ZeroGDesign/docs/pages/bom/instructions/merc/Hardware.md

---
layout: default
title: Installation Hardware
nav_order: 1
has_children: false
has_toc: false
parent: How To Build
permalink: /instructions/how/hardware
---

# Installation Hardware

| Image | Tool |
| :---: | --- |
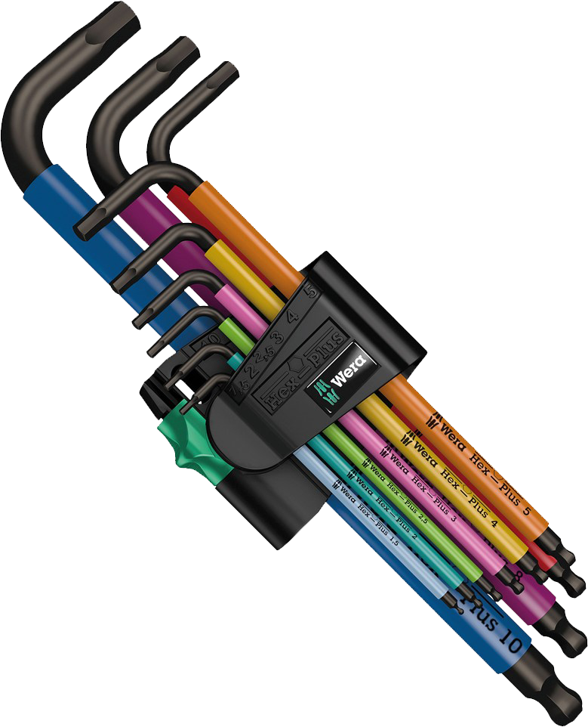
[picture p1: assets/img/hardware/hexkeys.png]
Wera Hex Keys
|  | Hex Key set.<br/>Used to tighten or loosen screws.|
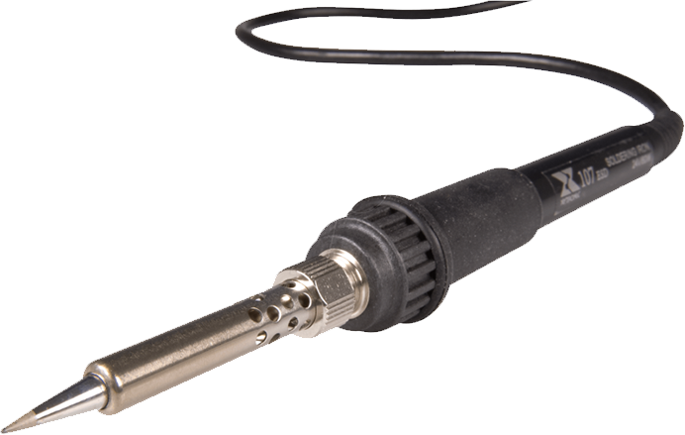
[picture p2: assets/img/hardware/solderiron.png]
Generic Soldering Iron
|  | Generic Soldering iron.<br/>Heat insert tip recommended.<br />Used to melt in brass heat inserts.|
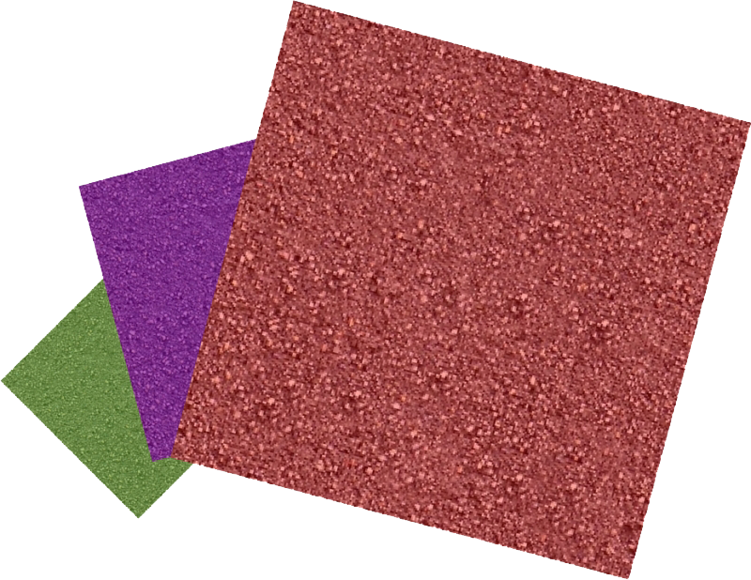
[picture p3: assets/img/hardware/sandpaper.png]
Sander paper
|  | Sand paper.<br/>Sometimes dowel pins are too tight, used to grind them down a little.|
