ZeroGDesign/docs/index.md

---

title: Welcome
nav_order: 1
---

# Welcome to the ZeroG docs!

Our first attempt at documentation! Found any errors in this document? Please report it on our [Discord server](https://discord.com/invite/gzJP2s8).

This contains all the information you need to build your personal ZeroG printer.

If you're not an expert with cad we'd suggest you to read our Documentation carefully. Do you have any questions? Hit up our [Discord](https://discord.com/invite/gzJP2s8){:target="_blank"}!

## Screenshot
The image bellow contains the Mercury One.1 ([Eva](https://main.eva-3d.page/){:target="_blank"} compatible).

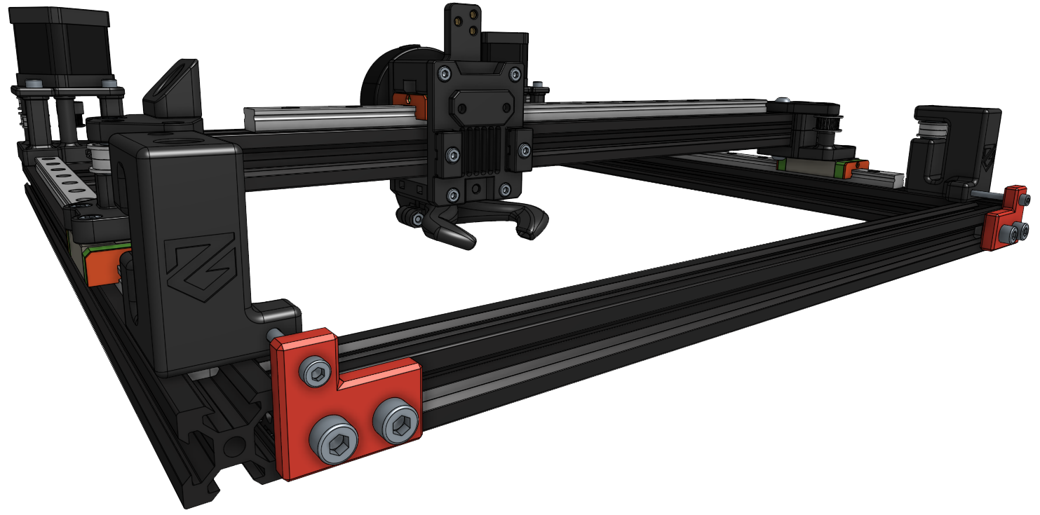
[picture p4: assets/img/printer/birdview.png]
Birdseye overview
