ZeroGDesign/docs/docs/index.md

---

title: Welcome
nav_order: 1
---

# Welcome
{: .fs-9 }
The Zero G documentation will give you a start building your project, learning all about 3D printing and more!
{: .fs-6 .fw-300 }

## Getting started
On this website you'll find all sorts of information, [ABS Printing Tips](/manual/print/abs), [Print Settings](/standard/print/settings), [Design Guidelines](/standard/cad/guidelines), [Mainsail Theme](/klipper/mainsail/theme), [Manuals](/manual/build) and more!

Currently we're working on instructions for two of our projects. Our projects are **Mercury One.1** and **Hydra**.

*The documentation is still a work in progress so keep in mind it's not complete.*

[Mercury One.1](/manual/build/mercury_eva){: .btn .btn-red } [Hydra](/manual/build/hydra){: .btn }

### Discord

We're a big [<i class="bi bi-discord"></i> Discord](https://discord.gg/zerog) advocate! We love using it and building a community. Missing something in the documentation, need assistance, share your adventure, or enjoy a nice community? Join our [<i class="bi bi-discord"></i> Discord](https://discord.gg/zerog) today!

## Step files!

The step files for Hydra and Mercury One.1 are now available.

Find them in the menu: Manual → [Mercury One.1](/manual/build/mercury_eva/printed_files) **OR** [Hydra](/manual/build/hydra/printed_files) → 3. Files. There is a section called "Step files".

### License

We're not using a GPL3 license like most other open source projects. 
Our work is licensed under a [Creative Commons Attribution-NonCommercial-ShareAlike 4.0 International License](http://creativecommons.org/licenses/by-nc-sa/4.0/)

**What does this mean and why did you choose for this instead of GPL3?**

1. What does this mean?
   1. Read more about the license here **[here](http://creativecommons.org/licenses/by-nc-sa/4.0/)**.
2. Why did you choose this license?
   1. I want to protect our project from others taking advantage of our files and community members.
   2. The license still allows you to do the following:
      1. **Share** — copy and redistribute the material in any medium or format
      2. **Adapt** — remix, transform, and build upon the material
   3. Yes, **Share and Adapt** come with **terms** and you can read those **[here](http://creativecommons.org/licenses/by-nc-sa/4.0/)**.
