ZeroGDesign/docs/docs/pages/menu/menu_universal.md

---
layout: default
title: Universal
nav_order: 45
has_toc: true
has_children: true
permalink: /universal
---

# Universal
{: .no_toc }

## WHAT IS UNIVERSAL ABOUT THIS PAGE
{: .no_toc }

This page is a versatile space designed to address a wide range of needs beyond our own project, ZeroG. Whether you're a seasoned 3D printing enthusiast or a newcomer wanting to enhance your printing experience, this page is a helpfull tool. Presenting a range of small tools to simplify your setup and troubleshooting processes.
