ZeroGDesign/docs/docs/pages/menu/menu_klipper.md

---
layout: default
title: Klipper
nav_order: 40
has_toc: true
has_children: true
permalink: /klipper
---

# Klipper
