ZeroGDesign/docs/docs/pages/manual/build/Electronics_enclosure/introduction.md

---
layout: default
title: 1. Introduction
nav_order: 0
has_toc: false
parent: Electronics Enclosure
grand_parent: Manual
permalink: /manual/build/electronics_enclosure/introduction
---

# 1. Introduction
{: .no_toc }

Building the Electronics enclosure
{: .fs-6 .fw-300 }

<dl>
  <dt>Difficulty</dt>
  <dd><span style="color:#FF3001">Advanced</span></dd>
  <dt>Language</dt>
  <dd>English</dd>
</dl>

## Higher resolution image

Hovering an image with your mouse will show a zoom icon <i class="bi bi-zoom-in"></i> after opening the image you can either click 'CLOSE' or anywhere on the screen to close the pop-up.

## Tools required

| :-------------------------: | :--------------------       | -------------------------------------------------------------------------------: |
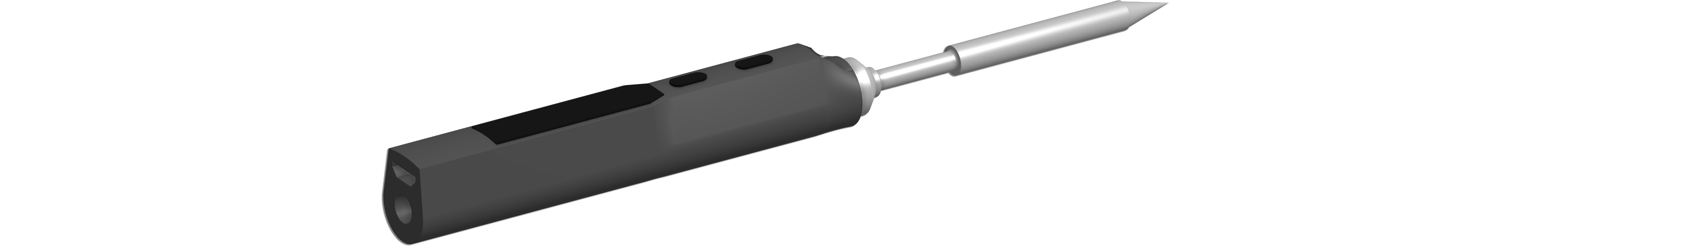
[picture p5: docs/assets/images/tools/soldering_iron.png]
soldering iron
| Tool<br/>Description| Soldering iron<br/>Used for heat set inserts |     {: .lightbox_wrapper} |
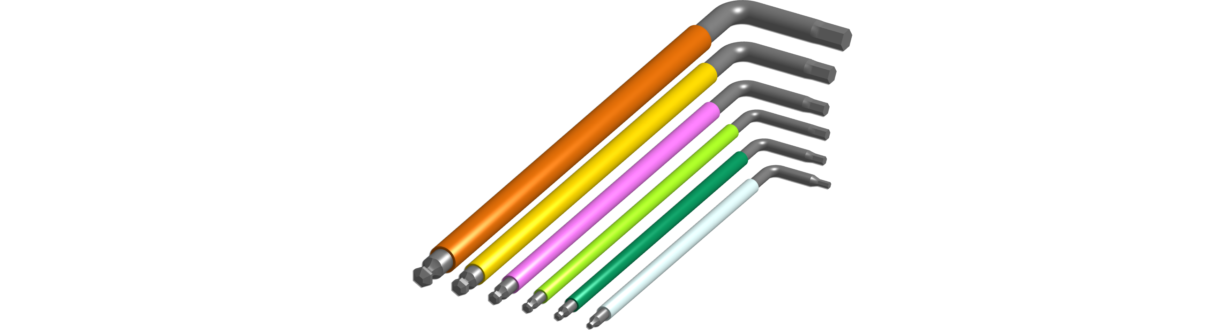
[picture p6: docs/assets/images/tools/wera_hexkeys.png]
| Tool<br/>Description<br/>Sizes| Hex Keys<br/>Used to tighten and losen bolts<br/>2mm, 2.5mm, 3mm|     {: .lightbox_wrapper} |
{: class="hardwaretable"}

<div onclick="location.href='##';"  id="lightbox__item_1"  class="lightbox__item">
    <div class="lightbox__content">

        Soldering iron
    </div>
</div>

<div onclick="location.href='##';"  id="lightbox__item_2"  class="lightbox__item">
    <div class="lightbox__content">

        Hex keys
    </div>
</div>

## Do's and don'ts

1. **Read and execute the instructions.**
2. **Got questions?**
   1. Join our [Discord server <i class="bi bi-discord"></i>](https://discord.gg/zerog){:target="_blank"}.
3. **Don't just look at images.**
   1. An image doesn't explain the full story.
   2. There is text that will explain every step, read it carefully.
4. **Don't skip instructions.**
   1. Unless we tell you to.
5. **Don't use force, you shouldn't have too.**
   1. Make sure to not use a unreasonable amount of force.
   2. Plastic does break and flange bearings crack, would be a waste wouldn't it?

## Need more help?

Lost? Need help? Not sure? Join our [Discord server <i class="bi bi-discord"></i>](https://discord.gg/zerog){:target="_blank"}, we've got a big community ready to help you out!

{: style="text-align: center" .fs-8}
[Next step &rarr;](#){: .btn .btn-red }
