ZeroGDesign/docs/docs/assets/stl/eva2_4/optional_ducts/info.pdf

# FAN DUCT NAMES

WHAT ARE THOSE!?

EVA2_4_TRIHORN_2-6-NARROW.STL / EVA2_4_TRIHORN_2-6-WIDE.STL

The name contains 2-6, this means the lowest part of the Trihorn duct is 2.6mm above the bottom of your nozzle.

Narrow means the width in-between exhaust holes is 24mm
Wide means the width in-between exhaust holes is 31mm.

EVA2_4_TRIHORN_3-4-NARROW.STL / EVA2_4_TRIHORN_3-4-WIDE.STL

Lowest part of the Trihorn duct is 3.4mm above the bottom of your nozzle.

EVA2_4_TRIHORN_4-3-NARROW.STL / EVA2_4_TRIHORN_4-3-WIDE.STL

Lowest part of the Trihorn duct is 4.3mm above the bottom of your nozzle.
