ZeroGDesign/docs/docs/assets/stl/m1_1/customExtrusion/what_are_these_files_for.pdf

These files are for the Lightweight Mercury One.1 Extrusion.

For normal size and plus size.
