ZeroGDesign/docs/docs/pages/klipper/mainsail_theme.md

---
layout: default
title: Mainsail Theme
nav_order: 2
has_children: false
has_toc: true
parent: Klipper
permalink: /klipper/mainsail/theme
---

# Mainsail theme

Mainsail custom theme installation instructions.
{: .fs-6 .fw-300 }

Skill required - easy
{: .label .label-red }

[Screenshot](#screenshot)

---

<details closed markdown="block">
  <summary>
    Table of contents
  </summary>
1. TOC
{:toc}
</details>

## Connect to SSH

1) Launch your SSH client, in my case [Putty](https://www.putty.org/){:target="_blank"}.

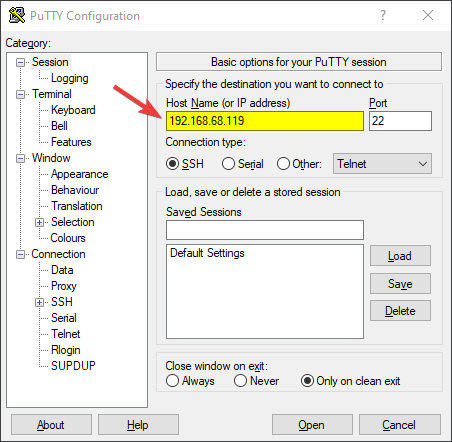
[picture p7: docs/assets/images/howto/theme/step1.png]
putty


2) Enter your Raspberry's local IP address in the "Host" or "Server" field.

3) Follow the prompts to connect to your Raspberry. Note that your local IP address may differ from the one used in the example.

---

### SSH console

Your console should appear similar to this.

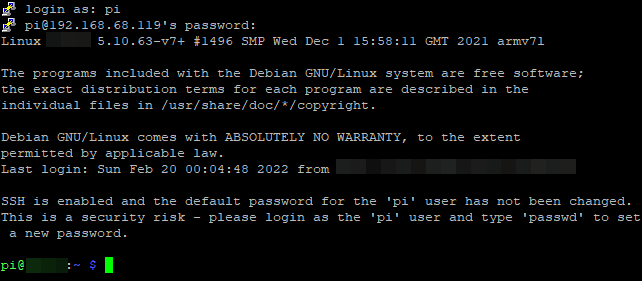
[picture p8: docs/assets/images/howto/theme/step2.png]
putty_normal_view


---

### Console Commands

Paste the following code into your console.

```bash
    cd ~/
    git clone https://github.com/ZeroGDesign/zerog-mainsail-theme.git
    bash ~/zerog-mainsail-theme/install.sh
```

After pasting them into the console, it should resemble this.

putty_first_paste

{: .warn }
The input field still shows a command we have to run, press **ENTER** on your keyboard to run the command.

Once executed, your console should display the message  '*Theme has been installed, have fun!*' indicating that this step is now complete.

putty_second_paste

---

## Machine Settings

For the next step of the instructions, you will be using your web client.
{: .fs-6 .fw-300 }

To begin, open the web client of your printer. On the left-hand side of the interface, locate the menu and click on '*Machine*'.

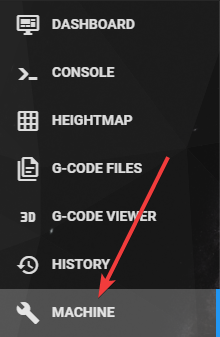
[picture p9: docs/assets/images/howto/theme/step5.png]
machine_web


---

### Config Files

Locate the file '*moonraker.conf*' and click on it.

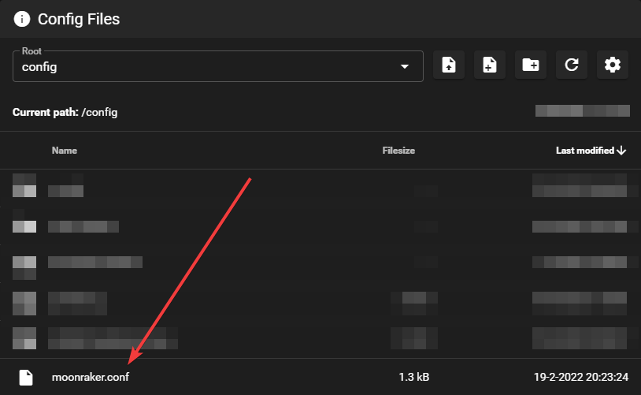
[picture p10: docs/assets/images/howto/theme/step6.png]
config_files


---

## Adding Update Script

Scroll down until you find the text *[update_manager]*.

{: .note }
If you see an additional line that reads "enable_auto_refresh: True", do not remove it. Simply proceed to the next line. Note that this line may not be present for all users.

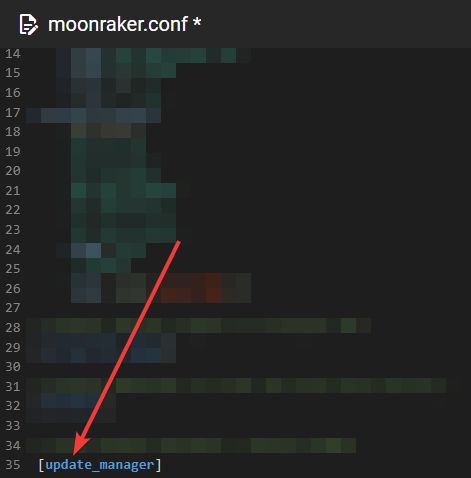
[picture p11: docs/assets/images/howto/theme/step7.png]


Insert the following code:

```s
[update_manager client ZeroGTheme]
type: git_repo
path: ~/zerog-mainsail-theme
origin: https://github.com/ZeroGDesign/zerog-mainsail-theme.git
install_script: install.sh
is_system_service: False
```

---

Your configuration should now resemble the following:

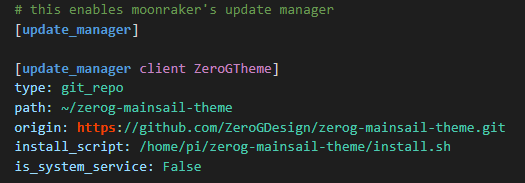
[picture p12: docs/assets/images/howto/theme/step8.png]
pasted_update_manager


---

### Save & Restart

Click on the **Save & Restart** button.

save_restart

---

### Restart Moonraker

If a notification appears asking you to **try again**, click on it to proceed.

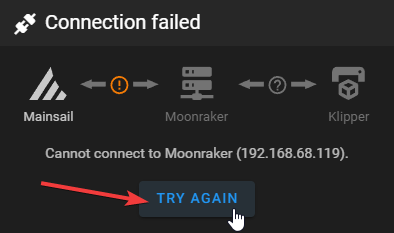
[picture p13: docs/assets/images/howto/theme/step10.png]
try_again


---

### Refresh your browser

Refresh your browser to check if the ZeroG theme is now visible.

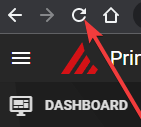
[picture p14: docs/assets/images/howto/theme/step11.png]
refresh


---

### Update manager

On the right-hand side, you will see the **Update Manager**. You should now notice that **ZeroGTheme** has been added. This will enable you to easily obtain the latest updates as they become available for the ZeroG Mainsail Theme.

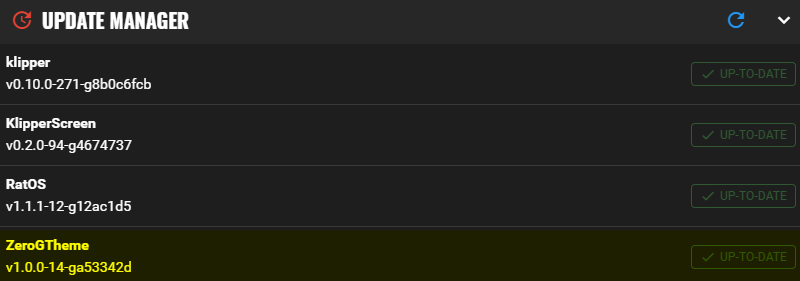
[picture p15: docs/assets/images/howto/theme/step12.png]


---

### Screenshot

You now have a fresh new theme to enjoy. With its sleek new design, your ZeroG experience just got a whole lot better. So sit back and enjoy the ride - the view has never looked better!

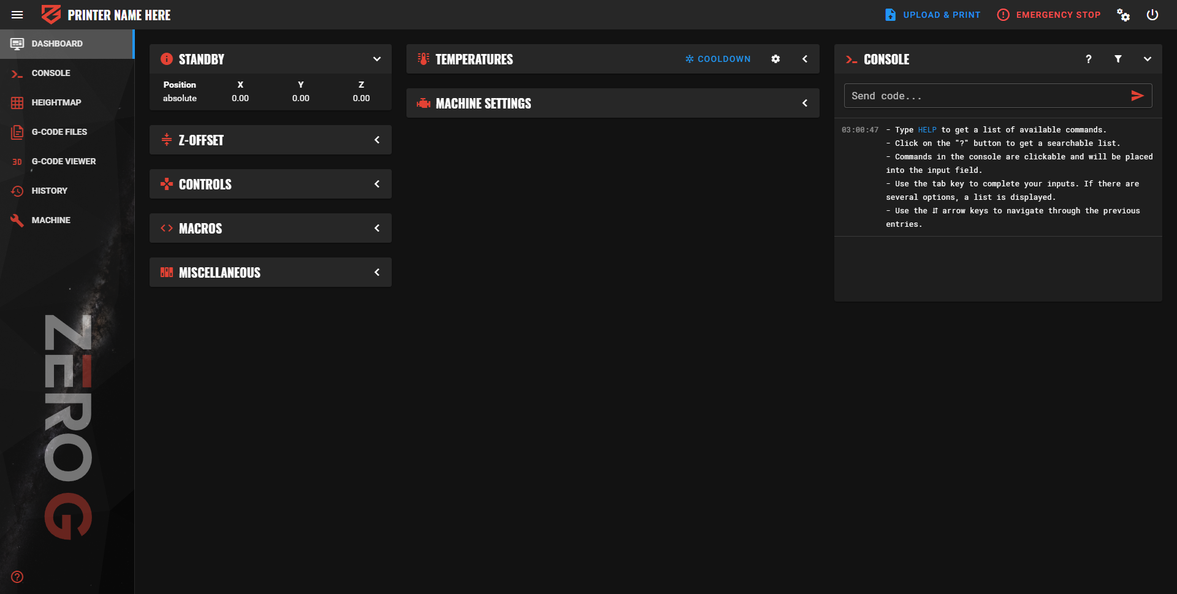
[picture p16: docs/assets/images/howto/theme/step13.png]
full_theme
