ZeroGDesign/docs/docs/assets/images/instructions/hydra/electronics_enclosure/back_left_5.png

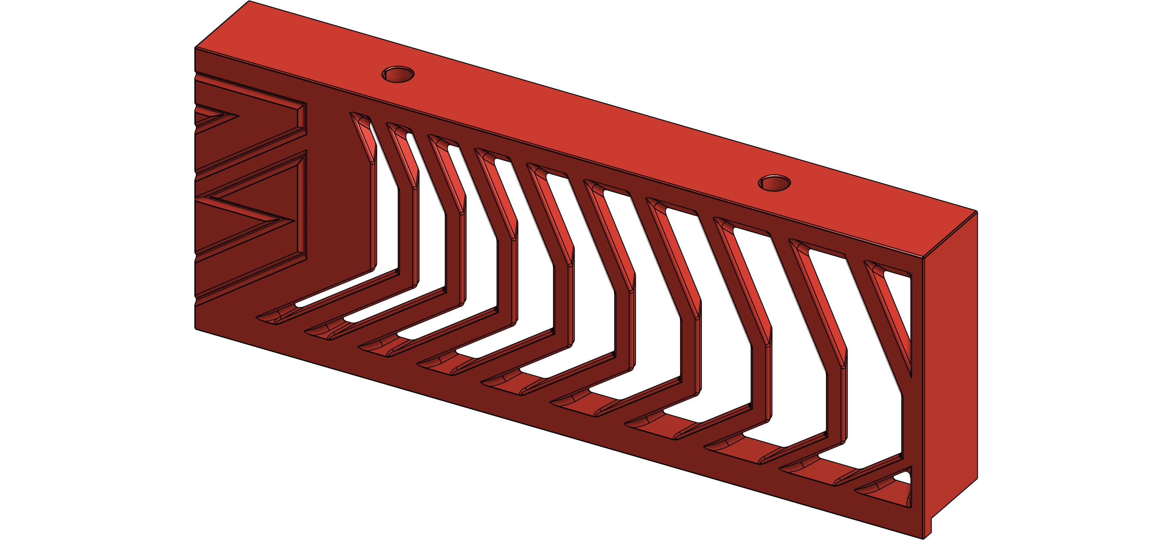
docs/assets/images/instructions/hydra/electronics_enclosure/back_left_5.png
