ZeroGDesign/docs/docs/assets/images/instructions/hydra/electronics_enclosure/back_left_5plus.png

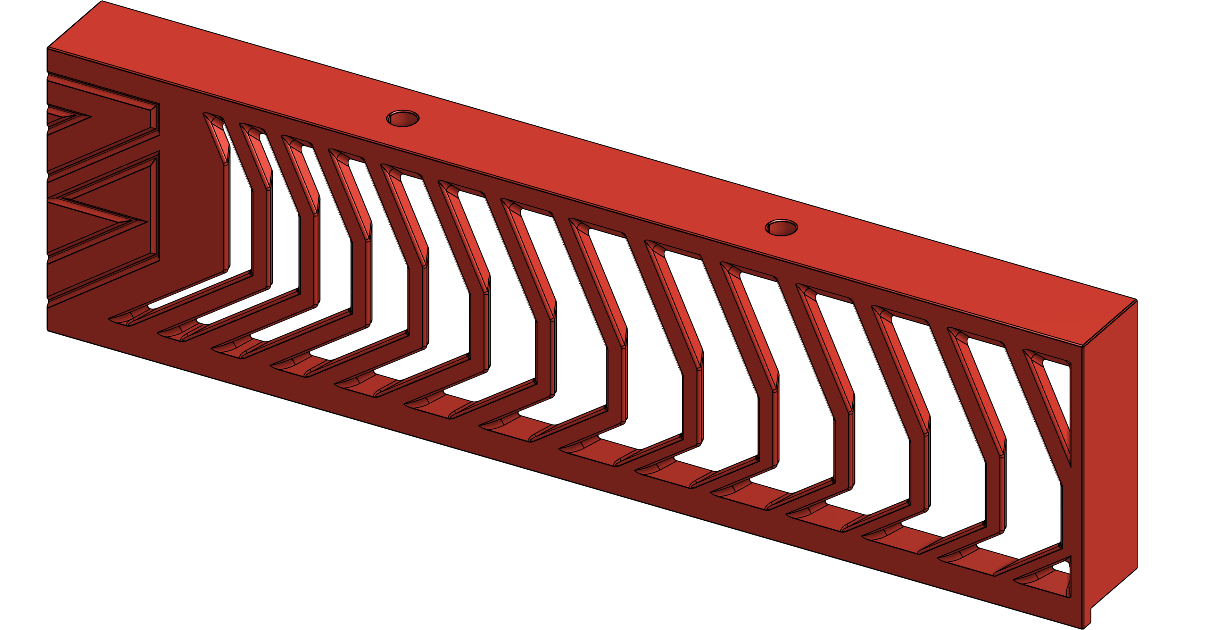
docs/assets/images/instructions/hydra/electronics_enclosure/back_left_5plus.png
