ZeroGDesign/docs/docs/assets/images/instructions/hydra/electronics_enclosure/back_right_5.png

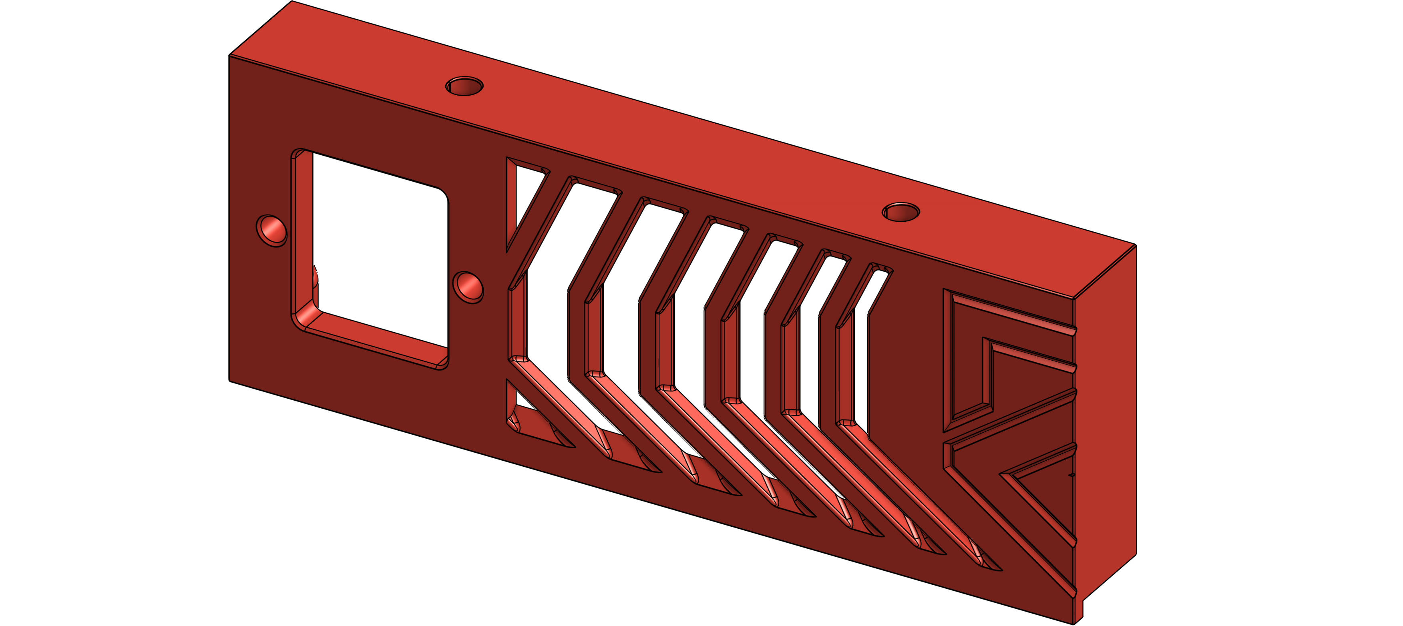
docs/assets/images/instructions/hydra/electronics_enclosure/back_right_5.png
