ZeroGDesign/docs/docs/assets/images/instructions/hydra/electronics_enclosure/front_left_5.png

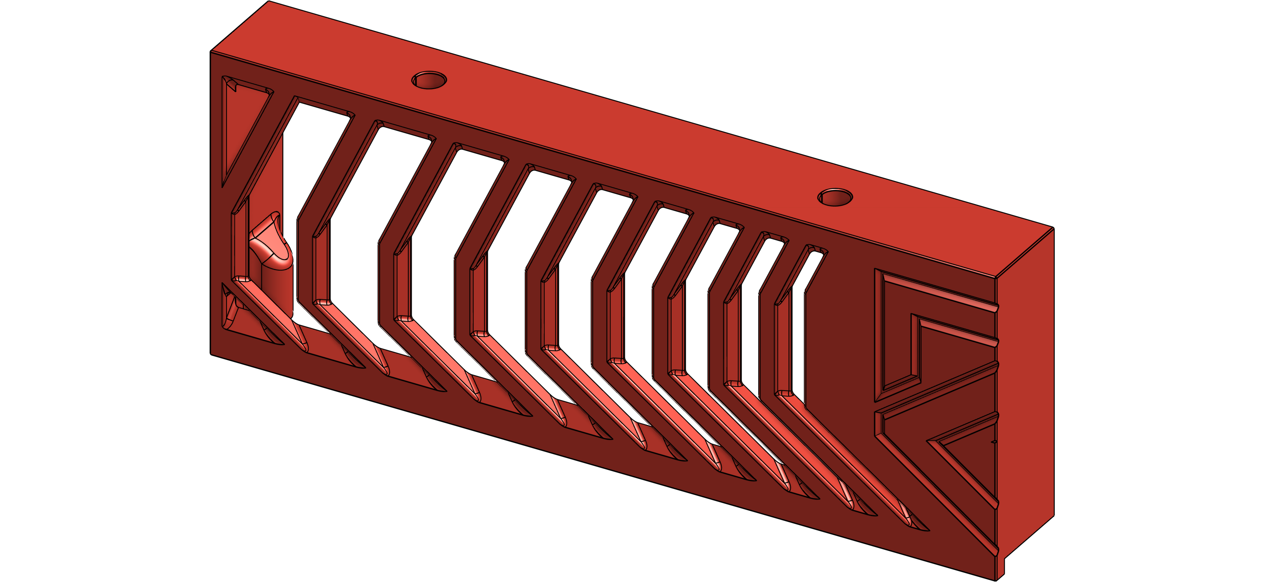
docs/assets/images/instructions/hydra/electronics_enclosure/front_left_5.png
