ZeroGDesign/docs/docs/assets/images/instructions/hydra/electronics_enclosure/front_right_5plus.png

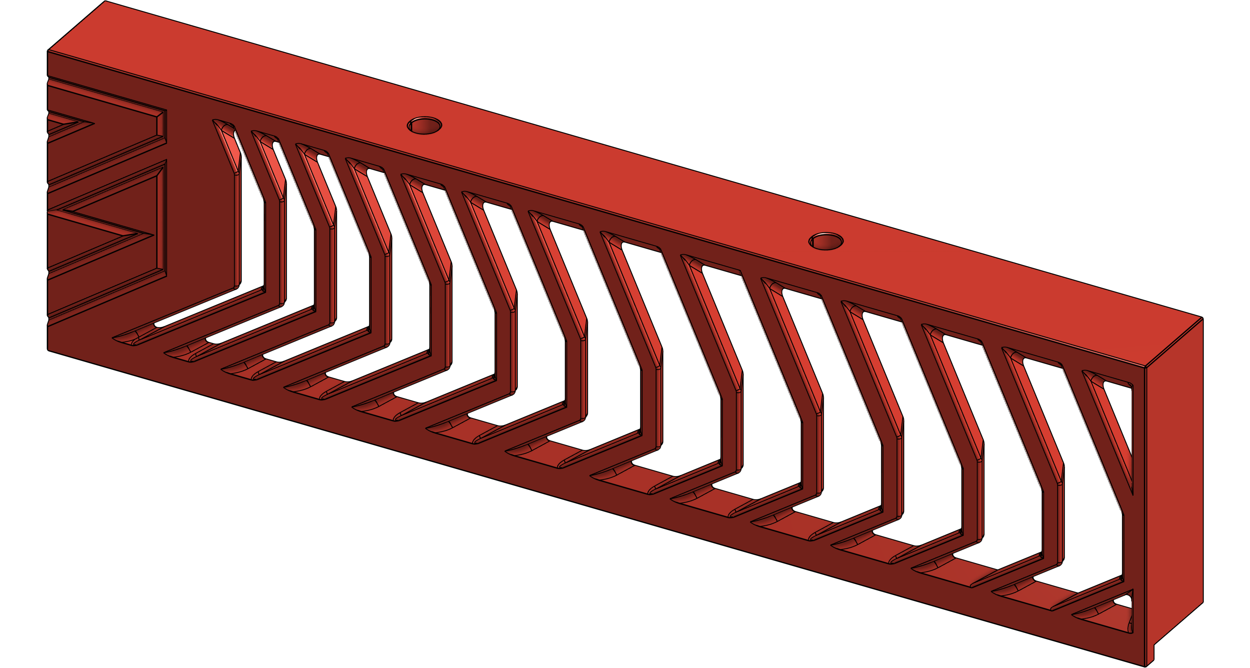
docs/assets/images/instructions/hydra/electronics_enclosure/front_right_5plus.png
