ZeroGDesign/docs/docs/assets/images/instructions/hydra/electronics_enclosure/left_corner.png

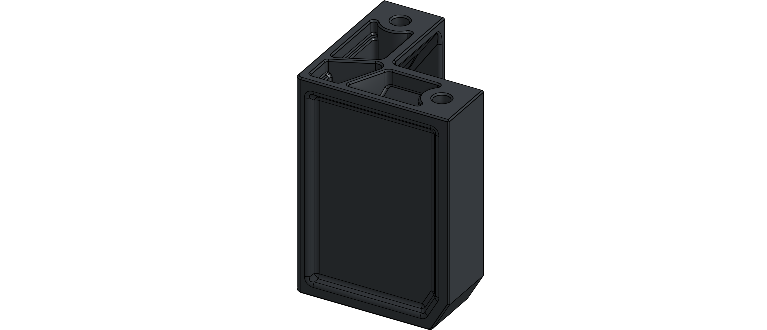
docs/assets/images/instructions/hydra/electronics_enclosure/left_corner.png
