ZeroGDesign/docs/docs/assets/images/instructions/hydra/electronics_enclosure/right_corner_switch.png

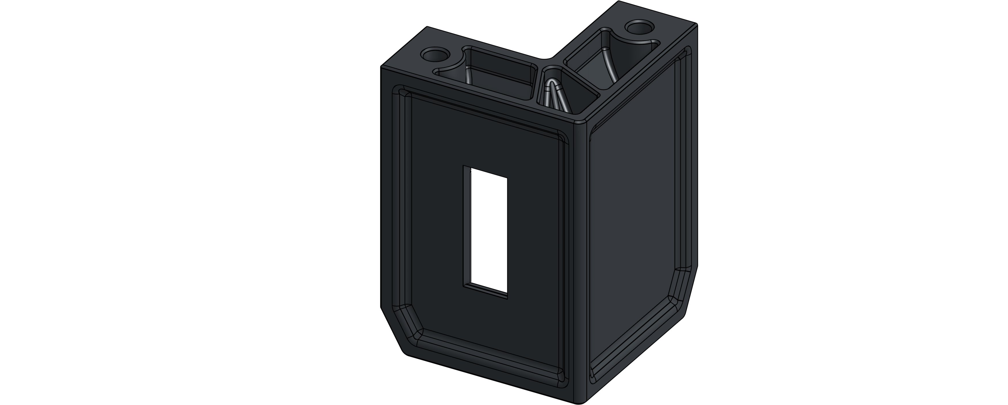
docs/assets/images/instructions/hydra/electronics_enclosure/right_corner_switch.png
