ZeroGDesign/docs/docs/assets/images/instructions/hydra/electronics_enclosure/side_left_5plus.png

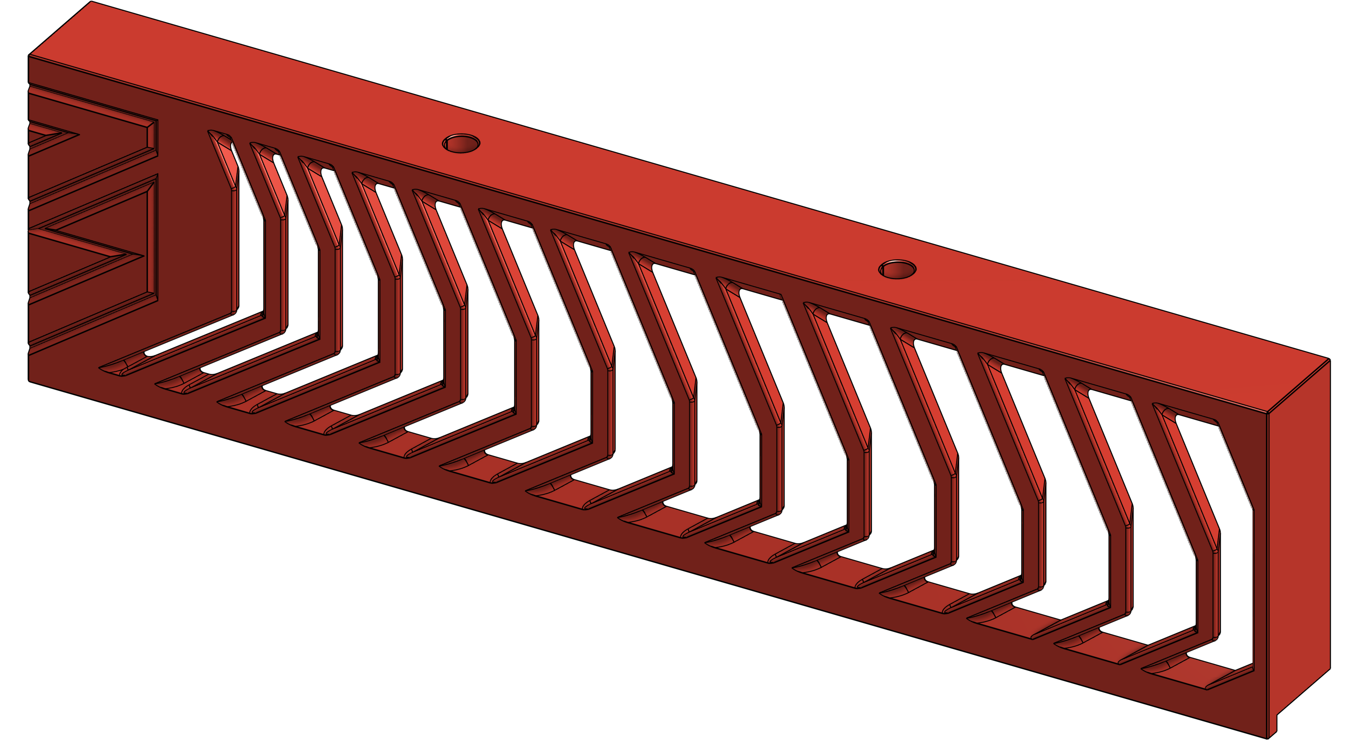
docs/assets/images/instructions/hydra/electronics_enclosure/side_left_5plus.png
