ZeroGDesign/docs/docs/assets/images/instructions/hydra/hydra_overview.png

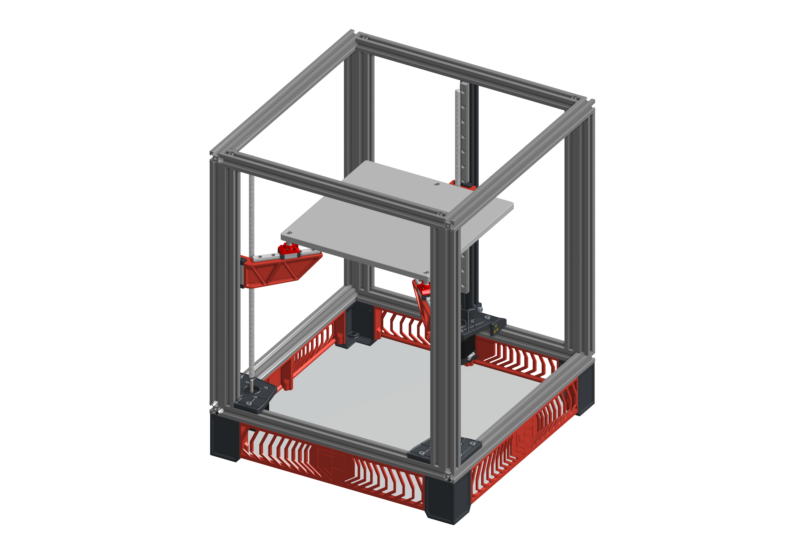
docs/assets/images/instructions/hydra/hydra_overview.png
