ZeroGDesign/docs/docs/assets/images/instructions/m1_1/right_stepper_tower/overview_top.png

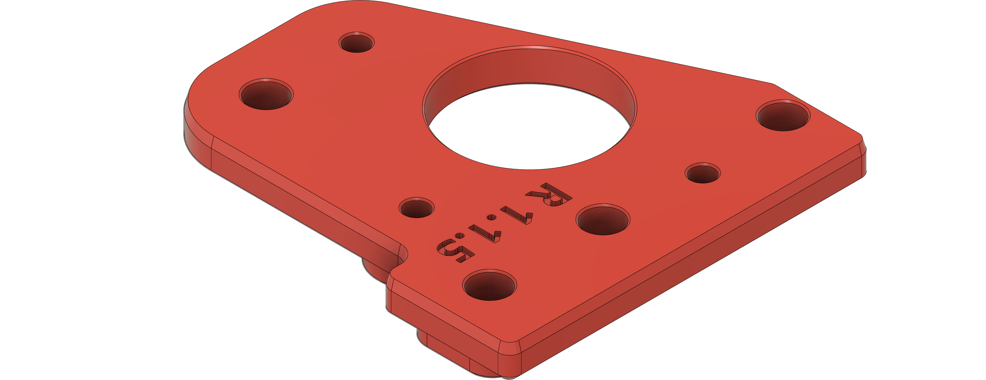
docs/assets/images/instructions/m1_1/right_stepper_tower/overview_top.png
