ZeroGDesign/docs/docs/assets/images/renders/electronics_back.png

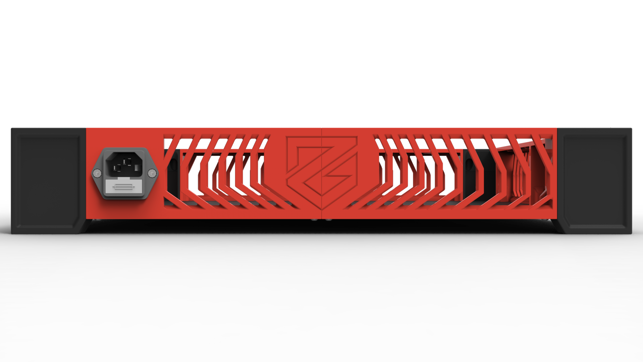
docs/assets/images/renders/electronics_back.png
