ZeroGDesign/docs/docs/assets/images/renders/electronics_bird.png

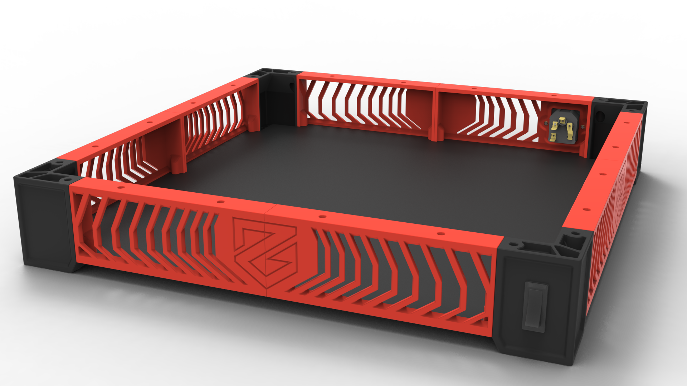
docs/assets/images/renders/electronics_bird.png
