ZeroGDesign/docs/docs/assets/images/renders/electronics_bottom.png

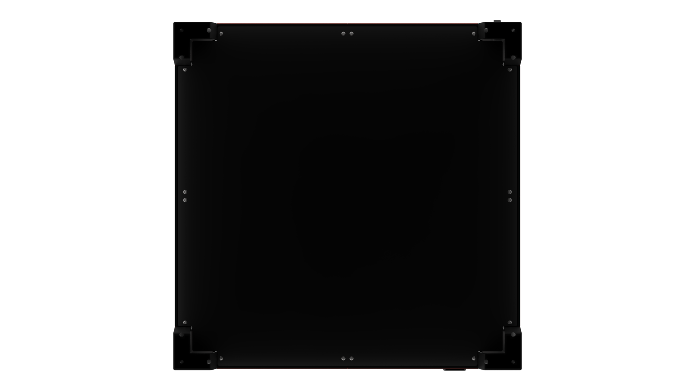
docs/assets/images/renders/electronics_bottom.png
