ZeroGDesign/docs/docs/assets/images/renders/electronics_front.png

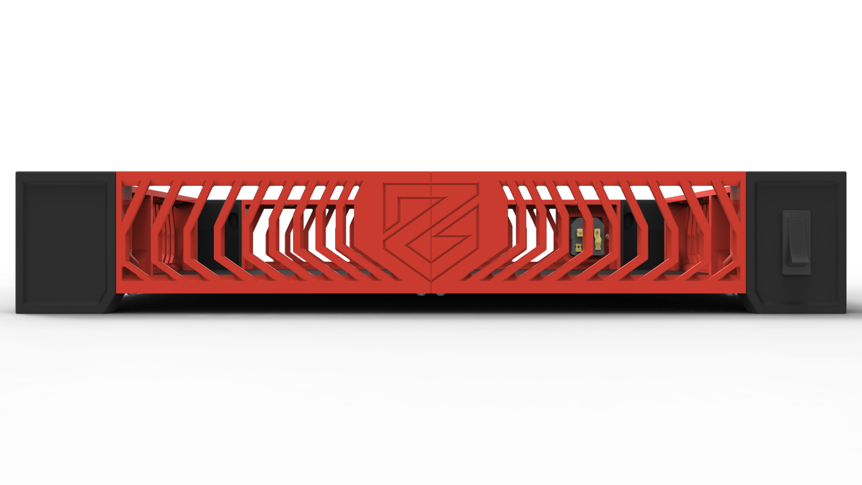
docs/assets/images/renders/electronics_front.png
