ZeroGDesign/docs/docs/assets/images/renders/electronics_top.png

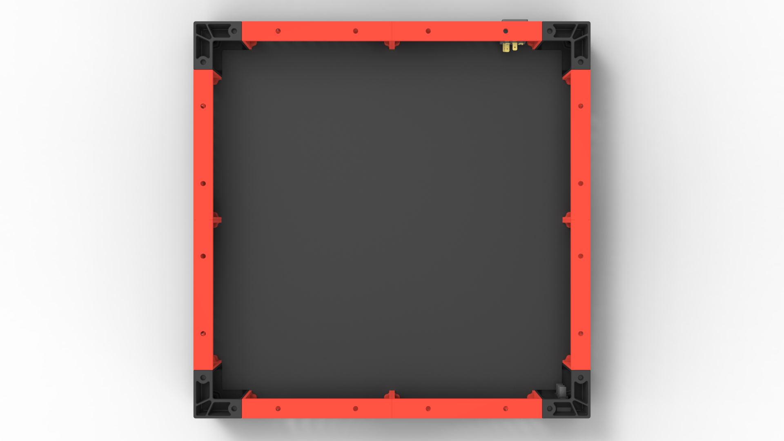
docs/assets/images/renders/electronics_top.png
