ZeroGDesign/docs/docs/pages/manual/build/mercury_one_1/bill_of_material.md

---
layout: default
title: Bill of material
nav_order: 20
has_toc: false
parent: Mercury One.1
grand_parent: Manual
permalink: /manual/build/mercury_eva/bill_of_material
---

{% include store_popout.md %}

# Bill of material
{: .no_toc }

The tables contain a column named `Stores` Click the [red text](#) underneath to reveal a pop-up with a list of stores. Stores that contain a checkmark <i class="bi bi-check-all"></i> have been verified and tested by either an Engineer or a trusted community member.

The Bill of Materials for the Mercury One.1 is not yet complete, but it does include the hardware for the EVA Toolhead. For further information, please refer to the Changelog [here](/changelog/mercury#th-december-2022).

## Self sourcing

### Bolts

#### Self sourcing bolts

*Note: The amount of bolts includes spares.*
{: .fs-3 }

| Size  | Type | Amount | Stores |
|:---|:---|:---:|:---:|
| M3x8  | <nobr>ISO 4762 / DIN 912</nobr> | 65 | [Click here](#m3x8_912)  &emsp; <input type="checkbox"> |
| M3x12 | <nobr>ISO 4762 / DIN 912</nobr> | 8 | [Click here](#m3x12_912) &emsp; <input type="checkbox"> |
| M3x16 | <nobr>ISO 4762 / DIN 912</nobr> | 8 | [Click here](#m3x16_912) &emsp; <input type="checkbox"> |
| M3x20 | <nobr>ISO 4762 / DIN 912</nobr> | 14 | [Click here](#m3x20_912) &emsp; <input type="checkbox"> |
| M3x25 | <nobr>ISO 4762 / DIN 912</nobr> | 5 | [Click here](#m3x25_912) &emsp; <input type="checkbox"> |
| M3x30 | <nobr>ISO 4762 / DIN 912</nobr> | 8 | [Click here](#m3x30_912) &emsp; <input type="checkbox"> |
| M3x35 | <nobr>ISO 4762 / DIN 912</nobr> | 12 | [Click here](#m3x35_912) &emsp; <input type="checkbox"> |
| M4x20 | <nobr>ISO 4762 / DIN 912</nobr> | 8 (PLUS ONLY) | [Click here](#m4x20_912) &emsp; <input type="checkbox"> |
| M5x8  | <nobr>ISO 4762 / DIN 912</nobr> | 6 | [Click here](#m5x8_912_SHCS) &emsp; <input type="checkbox"> |
| M5x12 | <nobr>ISO 4762 / DIN 912</nobr> | 6 | [Click here](#m5x12_912) &emsp; <input type="checkbox"> |
| M5x20 | <nobr>ISO 4762 / DIN 912</nobr> | 4 | [Click here](#m5x20_912) &emsp; <input type="checkbox"> |
| M5x50 | <nobr>ISO 4762 / DIN 912</nobr> | 6 | [Click here](#m5x50_912) &emsp; <input type="checkbox"> |
{: class="transparant_table"}

### T-Nuts

| Size | Type | Amount | Stores |
|:-----|:---|:---:|:---:|
| M3 | <nobr>Roll in spring loaded</nobr> | 35 | [Click here](#m3_rollin_tnut) &emsp; <input type="checkbox"> |
| M5 | <nobr>Roll in spring loaded</nobr> | 20 | [Click here](#m5_rollin_tnut) &emsp; <input type="checkbox"> |
{: class="transparant_table"}

### Extrusions

*Note: Ender 5 (Pro) and Ender 5 Plus have different sizes for parts.*
{: .fs-3 }

| Printer | Size  | Type | Amount | Stores |
|:---|:---|:---|:---:|:---:|
| Ender 5 (Pro) | 370mm | <nobr>2020 Extrusion</nobr> | 1 | [Click here](#extrusion_2020) &emsp; <input type="checkbox"> |
| Ender 5 Plus | 500mm | <nobr>2020 Extrusion</nobr> | 1 | [Click here](#extrusion_2020) &emsp; <input type="checkbox"> |
| LIGHTWEIGHT GANTRY | 370mm | <nobr>READ NOTE →</nobr> | 1 | [Click here](#merc_light) &emsp; <input type="checkbox"> |
{: class="transparant_table"}

### Linear rails

*Note: Ender 5 (Pro) and Ender 5 Plus have different sizes for parts.*
{: .fs-3 }

| Printer | Size  | Type | Amount | Stores |
|:---|:---|:---|:---:|:---:|
| Ender 5 (Pro) | 330mm | <nobr>MGN12H</nobr> | 3 | [Click here](#MGN12mm) &emsp; <input type="checkbox"> |
| Ender 5 Plus  | 450mm | <nobr>MGN12H</nobr> | 3 | [Click here](#MGN12mm) &emsp; <input type="checkbox"> |
{: class="transparant_table"}

### Electronics

*Note: You can self source the following parts. The parts below are recommended by us.*
{: .fs-3 }

| Type | Amount | Stores |
|:---|:---:|:---:|
| <nobr>Nema17 Stepper motor</nobr> | 2 | [Click here](#nema17_stepper_motor) &emsp; <input type="checkbox"> |
| <nobr>Controller board</nobr> | 1 | [Click here](#printer_motherboard) &emsp; <input type="checkbox">  |
| <nobr>Hotend - Rapido HF</nobr> | 1 | [Click here](#rapido_hotend) &emsp; <input type="checkbox"> |
{: class="transparant_table"}

| Size | Type | Amount | Stores |
|:---|:---|:---:|:---:|
| 40x40x10mm | <nobr>Brushless DC fan</nobr> | 1 | [Click here](#Gdstime_4010) &emsp; <input type="checkbox"> |
{: class="transparant_table"}

### Misc

#### Motion system

| Size | Type | Amount | Stores |
|:---|:---|:---:|:---:|
| <nobr>M5X30mm</nobr> | Precision dowel pin | 10 | [Click here](#m5_30_Precision_dowel_pin) &emsp; <input type="checkbox"> |
| <nobr>5*13*4 Mm</nobr> | F695-2RS | 20 |  [Click here](#f695_2rs_flangebearing) &emsp; <input type="checkbox"> |
| 6mm | 2GT 20T Idler | 2 | [Click here](#2gt_teeth_idler) &emsp; <input type="checkbox"> |
| 6mm | 2GT 20T Pulley | 2 | [Click here](#2gt_teeth_pulley) &emsp; <input type="checkbox"> |
| Check note in store | GATES-LL-2GT | READ NOTE → | [Click here](#gates_belts_6mm) &emsp; <input type="checkbox"> |
{: class="transparant_table"}

#### Other

| Size | Type | Amount | Stores |
|:---|:---|:---:|:---:|
| <nobr>M3 X D5.0 X L4.0</nobr> | Heatset insert | 50 | [Click here](#heatset_insert) &emsp; <input type="checkbox">  |
| <nobr>M3</nobr> | Hex Nut | 10 | [Click here](#m3_hex_nut) &emsp; <input type="checkbox"> |
| M3 Washer | <nobr>Normal grade A M3<br/>Stainless Steel</nobr> | 10 | [Click here](#plain_m3_washer) &emsp; <input type="checkbox"> |
| M5 Washer/Shim | <nobr>Normal grade A M5<br/>Stainless Steel</nobr> | 40 | [Click here](#plain_m5_washer) &emsp; <input type="checkbox"> |
{: class="transparant_table"}

{: style="text-align: center" .fs-8}
[Next step &rarr;](/manual/build/mercury_eva/printed_files){: .btn .btn-red }
