ZeroGDesign/docs/docs/pages/manual/build/Hydra/bill_of_material.md

---
layout: default
title: 2. Bill of material
nav_order: 20
has_toc: false
parent: Hydra
grand_parent: Manual
permalink: /manual/build/hydra/bill_of_material
---

{% include store_popout.md %}

# 2. Bill of material
{: .no_toc }

The tables contain a column named `Stores`. Click the [red text](#) underneath to reveal a pop-up with a list of stores. Stores that contain a checkmark <i class="bi bi-check-all"></i> have been verified and tested by either an Engineer or a trusted community member.

## Kits

We **do not** own the kits. We're **not responsible** for these kits. **Make sure to check the included hardware**. These kits might not contain all the hardware needed.

### All kits

| Type | Stores |
|:---|:---:|
| <nobr>Hydra kit</nobr> | [Click here](#hydra_kits) |
{: class="transparant_table"}

## Self sourcing

### Bolts

#### Self sourcing bolts

| Size  | Type | Amount | Stores |
|:---|:---|:---:|:---:|
| M3X6  | <nobr>ISO 10642 / DIN 7991</nobr> | 6 | [Click here](#m3x6_7991) &emsp; <input type="checkbox"> |
| M3X8  | <nobr>ISO 4762 / DIN 912</nobr> | 85 | [Click here](#m3x8_912)  &emsp; <input type="checkbox"> |
| M3X10 | <nobr>ISO 4762 / DIN 912</nobr> | 3 | [Click here](#m3x10_912) &emsp; <input type="checkbox"> |
| M4X16 | <nobr>ISO 4762 / DIN 912</nobr> | 3 | [Click here](#m4x16_912) &emsp; <input type="checkbox"> |
| M5X8  | <nobr>ISO 7380 / DIN 7380</nobr>  | 4 | [Click here](#m5x8_7380) &emsp; <input type="checkbox"> |
| M5X10 | <nobr>ISO 4762 / DIN 912</nobr> | 18 | [Click here](#m5x10_912) &emsp; <input type="checkbox"> |
{: class="transparant_table"}

### T-Nuts

| Size | Type | Amount | Stores |
|:-----|:---|:---:|:---:|
| M3 | <nobr>Roll in spring loaded</nobr> | 24 | [Click here](#m3_rollin_tnut) &emsp; <input type="checkbox"> |
| M5 | <nobr>Roll in spring loaded</nobr> | 22 | [Click here](#m5_rollin_tnut) &emsp; <input type="checkbox"> |
{: class="transparant_table"}

### Extrusions

*Note: Ender 5 (Pro) and Ender 5 Plus have different sizes for parts.*
{: .fs-3 }

| Printer | Size  | Type | Amount | Stores |
|:---|:---|:---|:---:|:---:|
| Ender 5 (Pro) | 400mm | <nobr>2020 Extrusion</nobr> | 1 | [Click here](#extrusion_2020) &emsp; <input type="checkbox"> |
| Ender 5 Plus  | 510mm | <nobr>2020 Extrusion</nobr> | 1 | [Click here](#extrusion_2020) &emsp; <input type="checkbox"> |
{: class="transparant_table"}

### Linear rails

*Note: Ender 5 (Pro) and Ender 5 Plus have different sizes for parts.*
{: .fs-3 }

| Printer | Size  | Type | Amount | Stores |
|:---|:---|:---|:---:|:---:|
| X | 100mm | <nobr>MGN9C</nobr> | 3 | [Click here](#MGN9C_100mm) &emsp; <input type="checkbox"> |
| Ender 5 (Pro) | 400mm | <nobr>MGN12C <b>OR</b> MGN12H</nobr> | 3 | [Click here](#MGN12_400mm) &emsp; <input type="checkbox"> |
| Ender 5 Plus  | 500mm | <nobr>MGN12C <b>OR</b> MGN12H</nobr> | 3 | [Click here](#MGN12_500mm) &emsp; <input type="checkbox"> |
{: class="transparant_table"}

### Leadscrew

*Note: Ender 5 (Pro) and Ender 5 Plus have different sizes for parts. Leadscrews can vary in sizes.*
{: .fs-3 }

{: .warn}
Make sure to look for Leadscrews that include a circular T8 Nut with 4 holes.

| Printer | Size Range | Type | Amount | Stores |
|:---|:---|:---|:---:|:---:|
| Ender 5 (Pro) | 350mm / 370mm | <nobr>TR8 Leadscrew</nobr> | 3 | [Click here](#TR8_Leadscrew) &emsp; <input type="checkbox"> |
| Ender 5 Plus  | 450mm / 470mm | <nobr>TR8 Leadscrew</nobr> | 3 | [Click here](#TR8_Leadscrew) &emsp; <input type="checkbox"> |
{: class="transparant_table"}

### Magnet

| Size | Type | Amount | Stores |
|:---|:---|:---:|:---:|
| 12x5mm or 12x4mm | <nobr>4mm hole Neodymium<br/>Countersunk Ring Magnet</nobr> | 3 | [Click here](#12x5_cs_magnet) &emsp; <input type="checkbox"> |
{: class="transparant_table"}

### Bed

| Printer | Size | Type | Amount | Stores |
|:---|:---|:---|:---:|:---:|
| Ender 5 (Pro) | 255/275mm | <nobr>Bed heater</nobr> | 1 | [Click here](#bed_heater) &emsp; <input type="checkbox"> |
| Ender 5 Plus  | 377mm | <nobr>Bed heater</nobr> | 1 | [Click here](#bed_heater) &emsp; <input type="checkbox"> |
| Ender 5 (Pro) | 255/275mm | <nobr>Aluminum bed</nobr> | 1 | [Click here](#hydra_bed)  &emsp; <input type="checkbox"> |
| Ender 5 Plus  | 377mm | <nobr>Aluminum bed</nobr> | 1 | [Click here](#hydra_bed)  &emsp; <input type="checkbox"> |
| X | Case specific | <nobr>Solid State Relay</nobr> | 1 |  [Click here](#ssr) &emsp; <input type="checkbox"> |
{: class="transparant_table"}

### Misc

| Size | Type | Amount | Stores |
|:---|:---|:---:|:---:|
| 2020 | <nobr>2020 Corner bracket</nobr> | 2 | [Click here](#2020_corner_bracket) &emsp; <input type="checkbox"> |
| <nobr>M3 X D5.0 X L4.0</nobr> | Heatset insert | 39 |  [Click here](#heatset_insert) &emsp; <input type="checkbox">  |
| M3 Washer | <nobr>Normal grade A M3 <br/>Stainless Steel </nobr> | 12 |  [Click here](#plain_m3_washer) &emsp; <input type="checkbox">  |
| M4 X 8 X L8 | Spacer | 3 | [Click here](#8mm_spacers) &emsp; <input type="checkbox"> |
| 10mm M4 | Kossel ball | 3 |  [Click here](#m4_kossel_balls) &emsp; <input type="checkbox">  |
| 10x11mm - 1 Meter | R18 Drag chain | 1 | [Click here](#10x11_drag_chain) &emsp; <input type="checkbox">  |
| Nema17 | Stepper motor | 3 |  [Click here](#nema17_zaxis) &emsp; <input type="checkbox"> |
| 5mm-8mm | Shaft Coupling | 3 |  [Click here](#stepper_coupler) &emsp; <input type="checkbox">  |
| OPTIONAL | Oldham Coupling | 3 |  [Click here](#oldham_coupler) &emsp; <input type="checkbox">  |
{: class="transparant_table"}

{: style="text-align: center" .fs-8 }
[Next step <i class="bi bi-arrow-return-right"></i>](/manual/build/hydra/printed_files){: .btn .btn-red }
