ZeroGDesign/docs/docs/assets/dxf/hydra/275x275.dxf

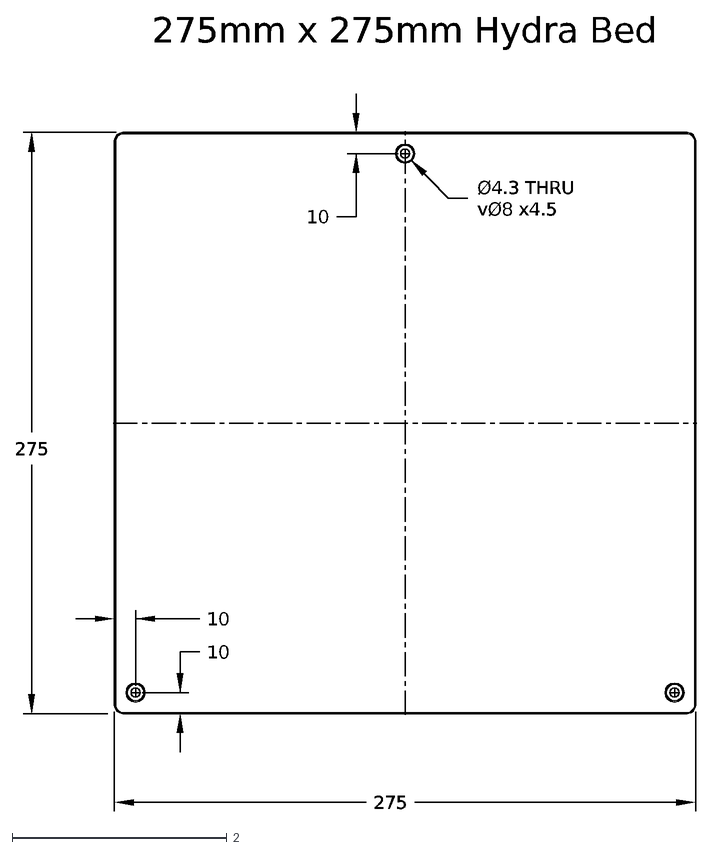
[picture p35: CAD file, 2022-05-21]
docs/assets/dxf/hydra/275x275.dxf
10
275
275mm x 275mm Hydra Bed
