ZeroGDesign/docs/docs/assets/stl/electronics_enclosure/DIN-Pi-M3_heatset_1.stl

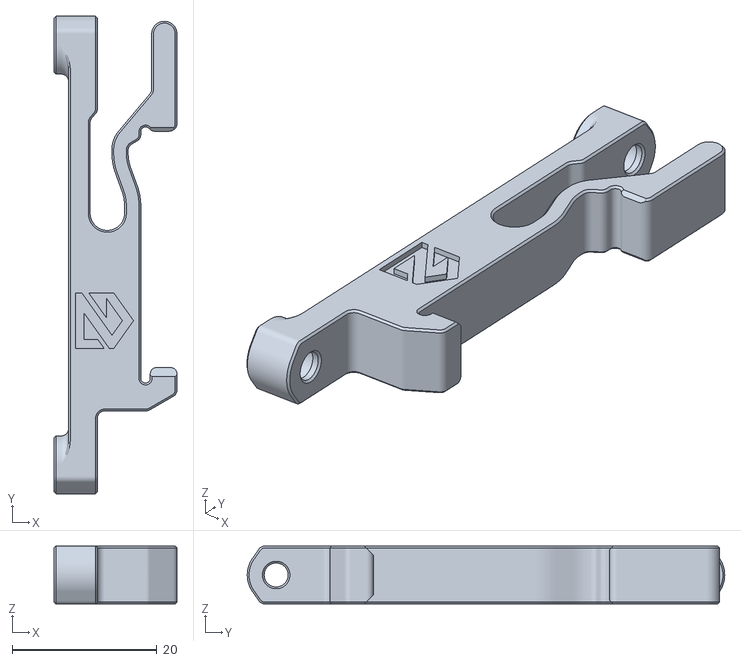
[picture p36: CAD file, 2023-03-29]
docs/assets/stl/electronics_enclosure/DIN-Pi-M3_heatset_1.stl
17.0 x 66.0 x 8.00
