ZeroGDesign/docs/docs/assets/stl/electronics_enclosure/skirt/5plus/SK_5Plus_BottomPanel.dxf

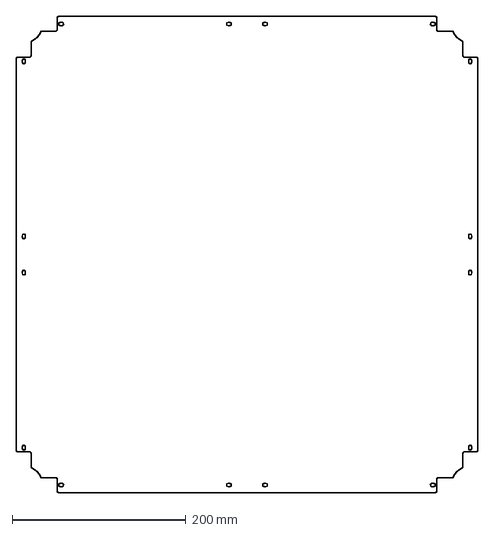
[picture p37: CAD file, 2024-02-21]
docs/assets/stl/electronics_enclosure/skirt/5plus/SK_5Plus_BottomPanel.dxf
530.5 x 547.5 mm
