ZeroGDesign/docs/docs/assets/stl/electronics_enclosure/skirt/5pro/5Pro_BottomPanel.dxf

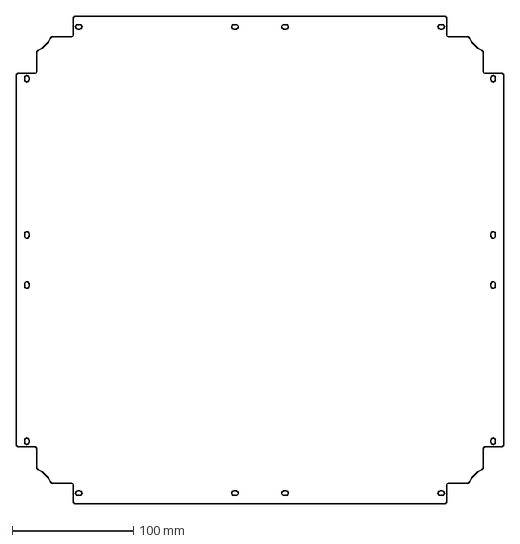
[picture p38: CAD file, 2024-02-21]
docs/assets/stl/electronics_enclosure/skirt/5pro/5Pro_BottomPanel.dxf
402.5 x 402.5 mm
