ZeroGDesign/docs/docs/assets/stl/electronics_enclosure/skirt/SK_CenterLogo_Inlay_x4.stl

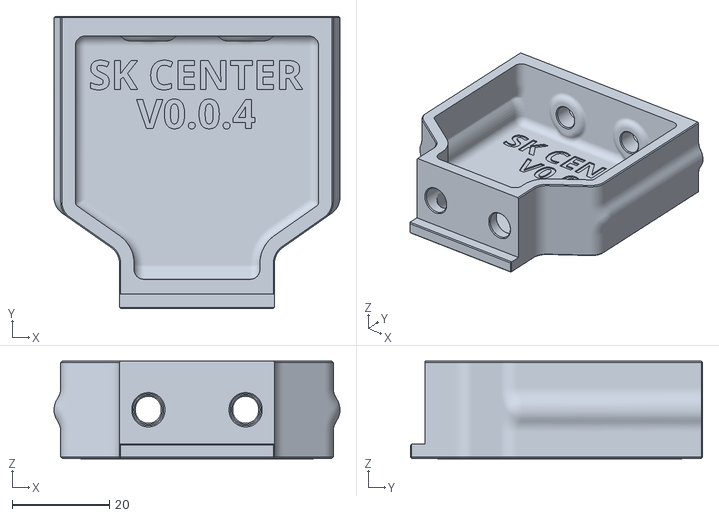
[picture p39: CAD file, 2023-03-29]
docs/assets/stl/electronics_enclosure/skirt/SK_CenterLogo_Inlay_x4.stl
58.8 x 60.0 x 20.1
