ZeroGDesign/docs/docs/assets/stl/eva2_4/optional_ducts/EVA2_4_Trihorn_3-4-wide.stl

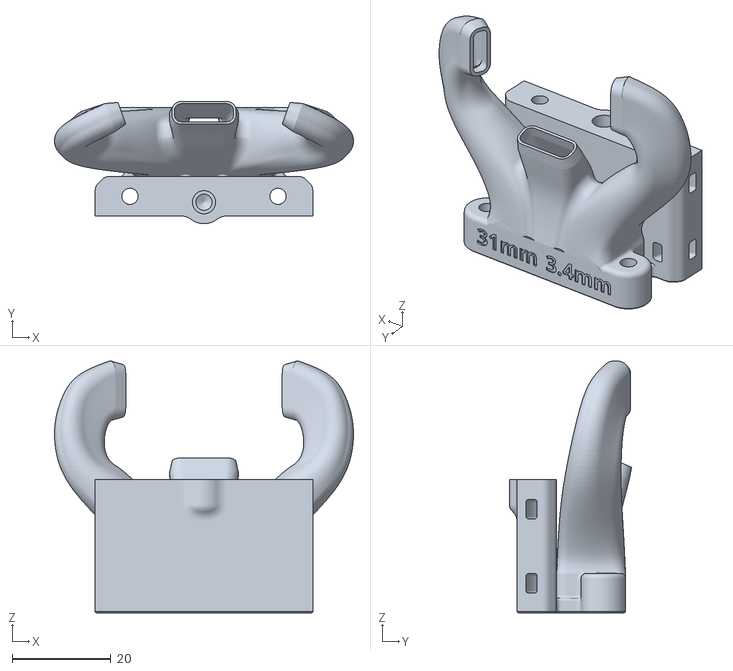
[picture p40: CAD file, 2024-02-20]
docs/assets/stl/eva2_4/optional_ducts/EVA2_4_Trihorn_3-4-wide.stl
60.6 x 24.8 x 51.0
