ZeroGDesign/docs/docs/assets/stl/eva2_4/Orbiter_2_0_TOP.stl

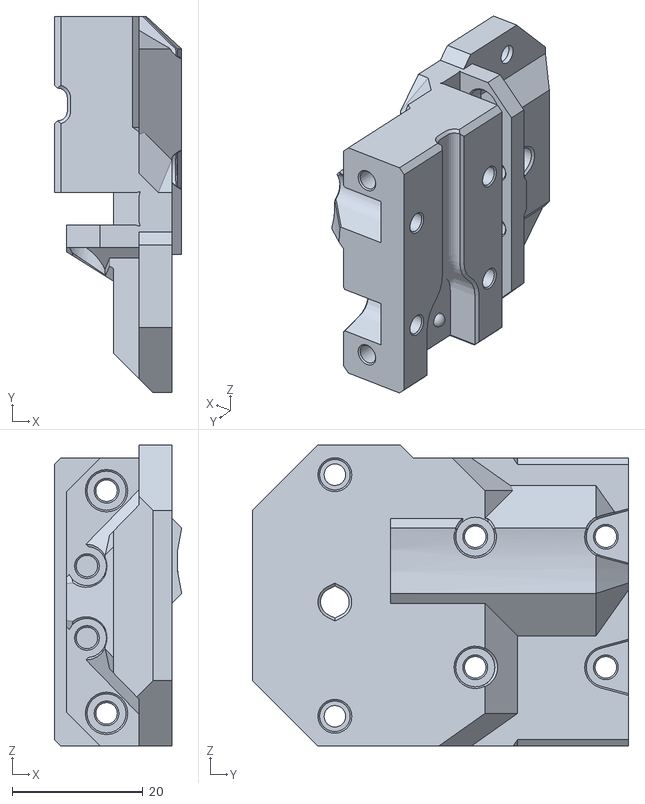
[picture p41: CAD file, 2024-02-18]
docs/assets/stl/eva2_4/Orbiter_2_0_TOP.stl
19.5 x 57.6 x 46.1
