ZeroGDesign/docs/docs/assets/stl/hydra/ChainEnd.stl

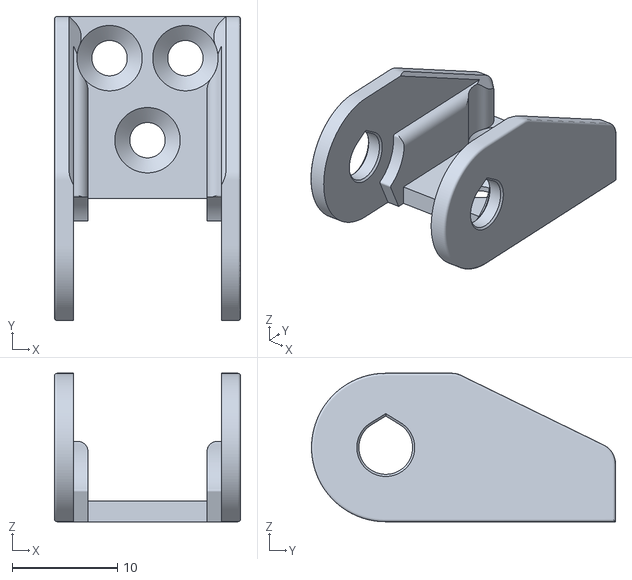
[picture p42: CAD file, 2023-03-04]
docs/assets/stl/hydra/ChainEnd.stl
17.7 x 28.9 x 14.1
