ZeroGDesign/docs/docs/assets/dxf/hydra/377x370.dxf

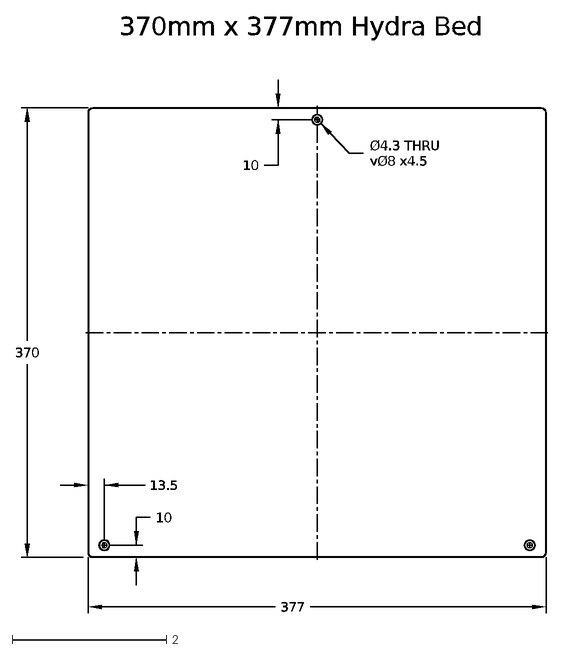
[picture p43: CAD file, 2022-05-21]
docs/assets/dxf/hydra/377x370.dxf
10
13.5
377
370
370mm x 377mm Hydra Bed
