ZeroGDesign/docs/docs/assets/stl/electronics_enclosure/Clip_Top_x4.stl

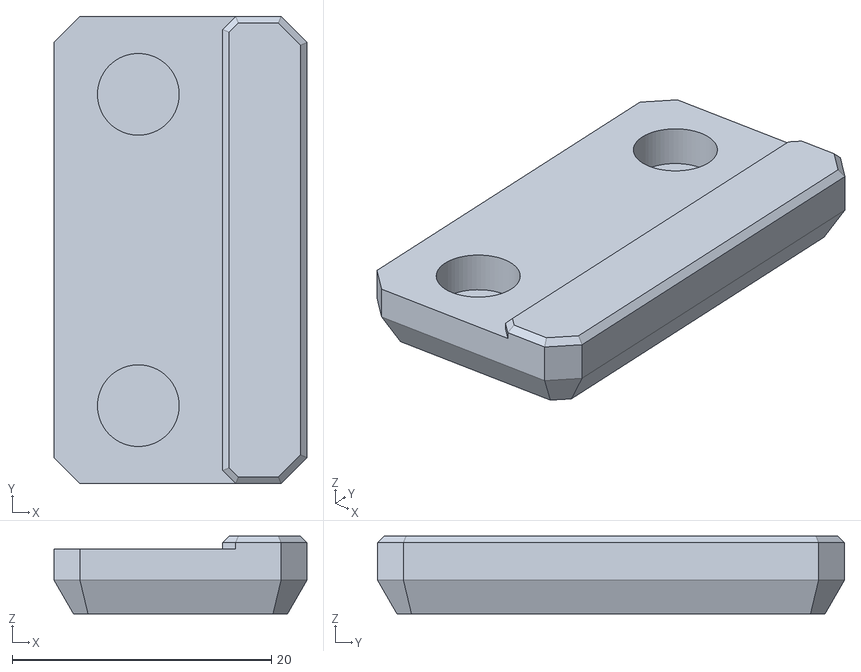
[picture p44: CAD file, 2023-03-29]
docs/assets/stl/electronics_enclosure/Clip_Top_x4.stl
19.5 x 36.0 x 6.00
