ZeroGDesign/docs/docs/assets/stl/electronics_enclosure/skirt/5plus/5Plus_Hydra_TopPanel.dxf

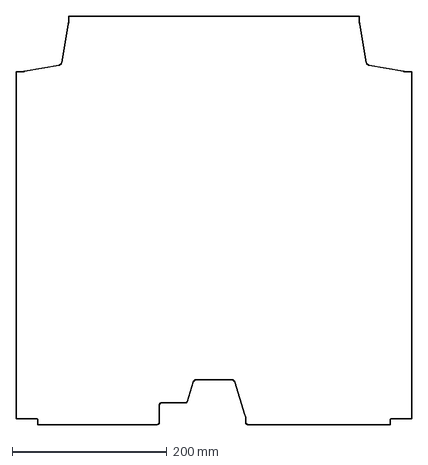
[picture p45: CAD file, 2023-03-29]
docs/assets/stl/electronics_enclosure/skirt/5plus/5Plus_Hydra_TopPanel.dxf
511.0 x 528.0 mm
