ZeroGDesign/docs/docs/assets/stl/electronics_enclosure/skirt/5pro/5Pro_Hydra_TopPanel.dxf

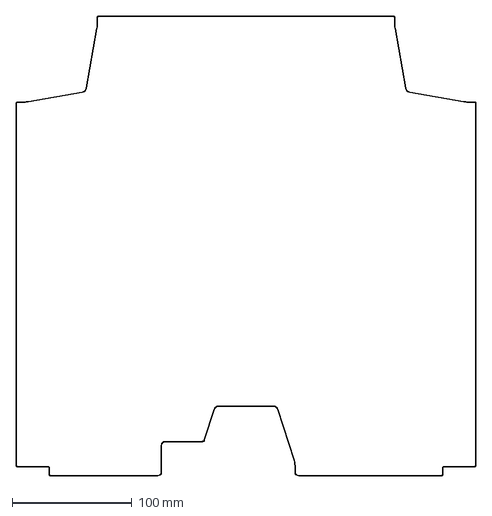
[picture p46: CAD file, 2023-03-29]
docs/assets/stl/electronics_enclosure/skirt/5pro/5Pro_Hydra_TopPanel.dxf
383.0 x 383.0 mm
