ZeroGDesign/docs/docs/assets/stl/electronics_enclosure/skirt/SK_FT_38mm_x3.stl

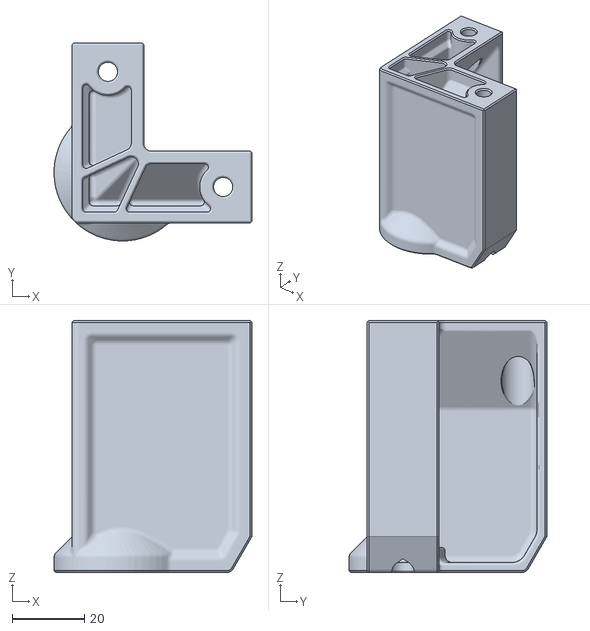
[picture p47: CAD file, 2023-03-29]
docs/assets/stl/electronics_enclosure/skirt/SK_FT_38mm_x3.stl
55.0 x 55.0 x 70.0
