ZeroGDesign/docs/docs/assets/stl/eva2_4/LGX_Lite_TOP.stl

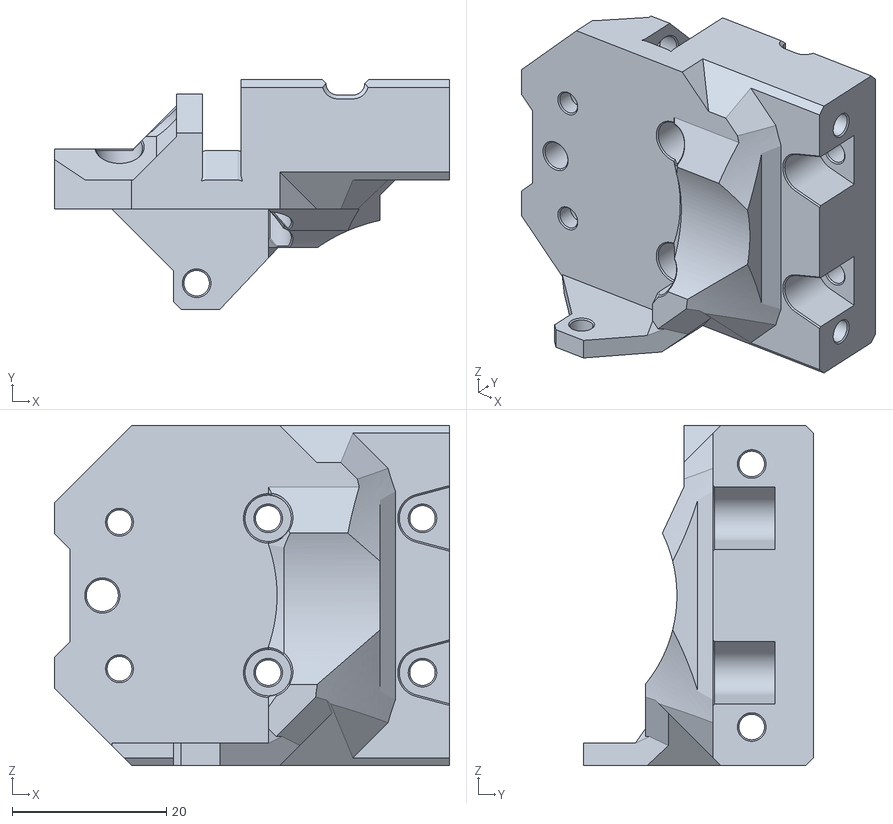
[picture p48: CAD file, 2023-04-16]
docs/assets/stl/eva2_4/LGX_Lite_TOP.stl
51.2 x 29.8 x 44.1
