ZeroGDesign/docs/docs/assets/stl/eva2_4/optional_ducts/EVA2_4_Trihorn_4-3-wide.stl

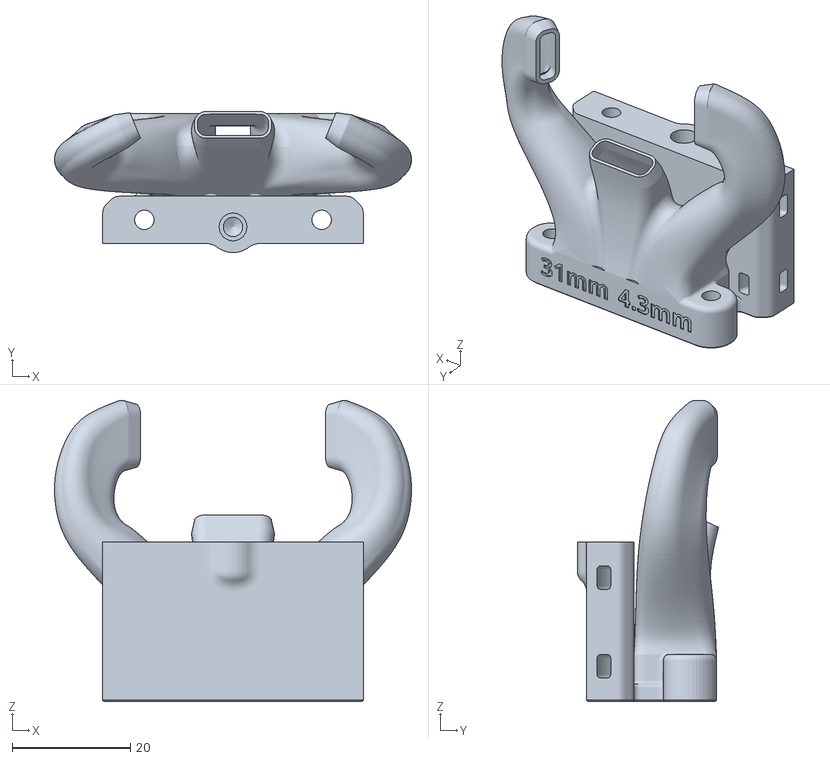
[picture p49: CAD file, 2024-02-20]
docs/assets/stl/eva2_4/optional_ducts/EVA2_4_Trihorn_4-3-wide.stl
60.4 x 23.9 x 51.0
