ZeroGDesign/docs/docs/assets/stl/hydra/2020_CableTie.stl

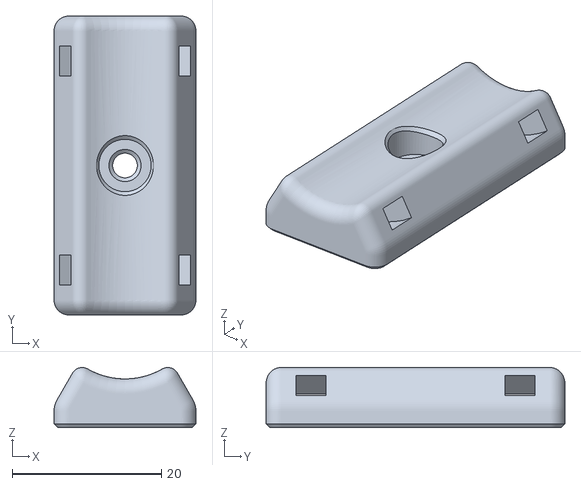
[picture p50: CAD file, 2023-03-04]
docs/assets/stl/hydra/2020_CableTie.stl
19.0 x 40.0 x 8.03
