ZeroGDesign/docs/docs/assets/dxf/hydra/255x255.dxf

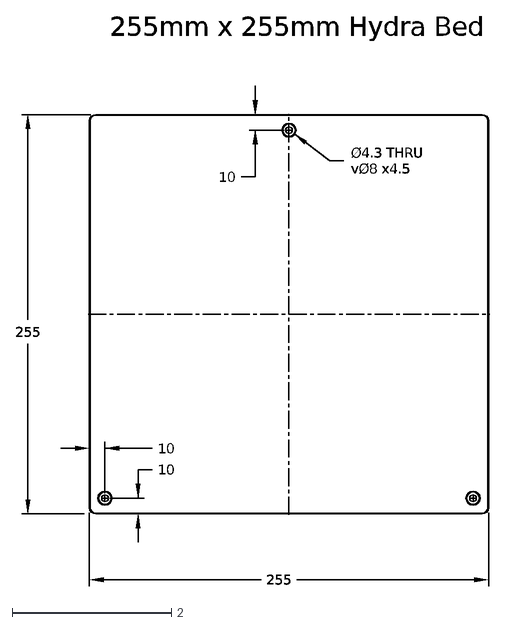
[picture p51: CAD file, 2022-05-21]
docs/assets/dxf/hydra/255x255.dxf
10
255
255mm x 255mm Hydra Bed
