ZeroGDesign/docs/docs/assets/stl/electronics_enclosure/DIN-Spider-M3_heatset_2.stl

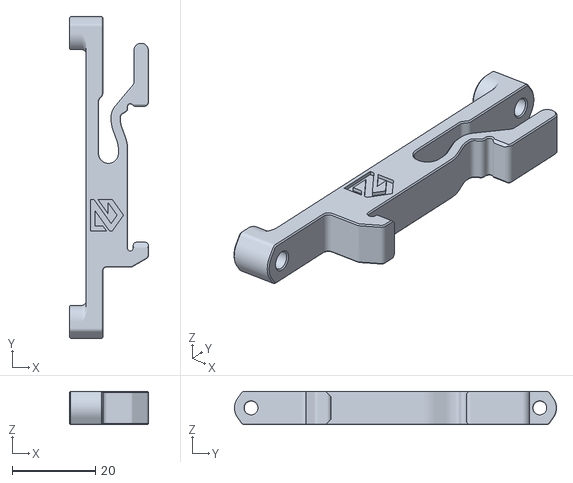
[picture p52: CAD file, 2023-03-29]
docs/assets/stl/electronics_enclosure/DIN-Spider-M3_heatset_2.stl
19.0 x 77.5 x 8.00
