ZeroGDesign/docs/docs/assets/stl/electronics_enclosure/skirt/SK_FT_38mm_PowerSW.stl

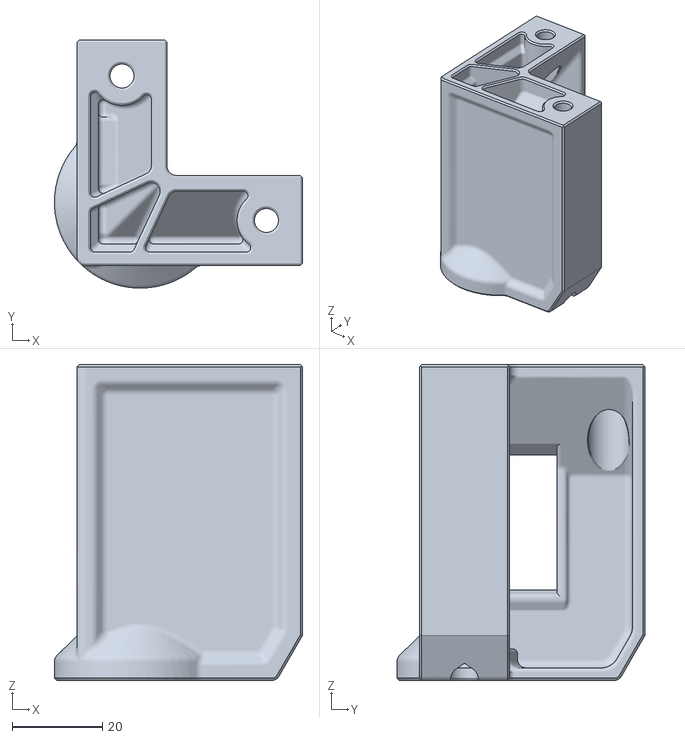
[picture p53: CAD file, 2023-03-29]
docs/assets/stl/electronics_enclosure/skirt/SK_FT_38mm_PowerSW.stl
55.0 x 55.0 x 70.0
