ZeroGDesign/docs/docs/assets/stl/eva2_4/LGX_TOP_a.stl

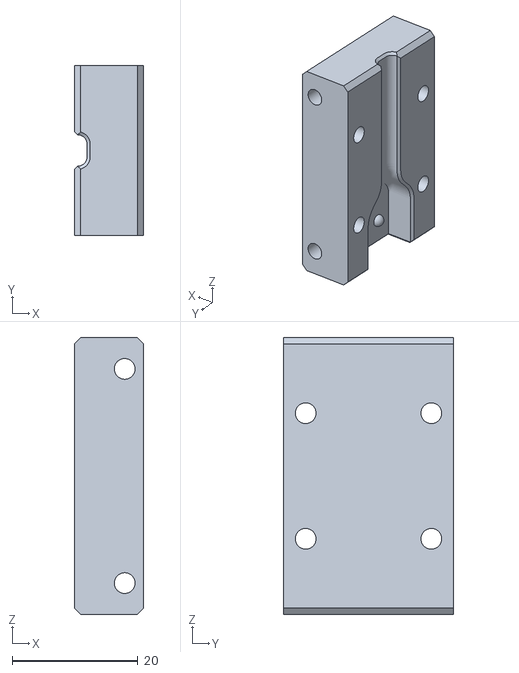
[picture p54: CAD file, 2022-12-26]
docs/assets/stl/eva2_4/LGX_TOP_a.stl
11.0 x 27.0 x 44.1
