ZeroGDesign/docs/docs/assets/dxf/hydra/410x410.dxf

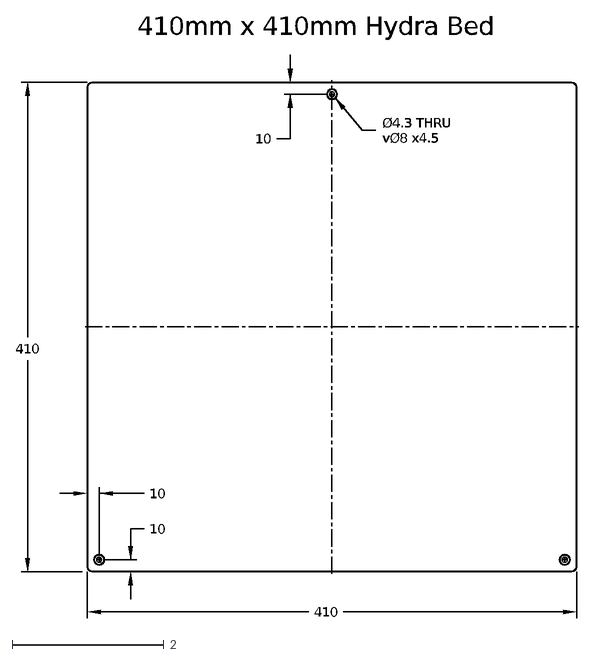
[picture p55: CAD file, 2022-05-21]
docs/assets/dxf/hydra/410x410.dxf
10
410
410mm x 410mm Hydra Bed
