ZeroGDesign/docs/docs/assets/stl/electronics_enclosure/DIN-PSU-LRS200_LRS350-M4_2.stl

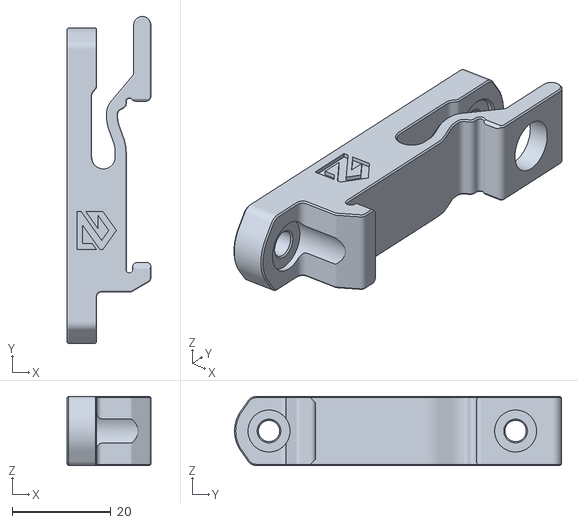
[picture p56: CAD file, 2023-03-29]
docs/assets/stl/electronics_enclosure/DIN-PSU-LRS200_LRS350-M4_2.stl
17.0 x 66.3 x 14.0
