ZeroGDesign/docs/docs/assets/stl/eva2_4/bl_touch_mount_volcano.stl

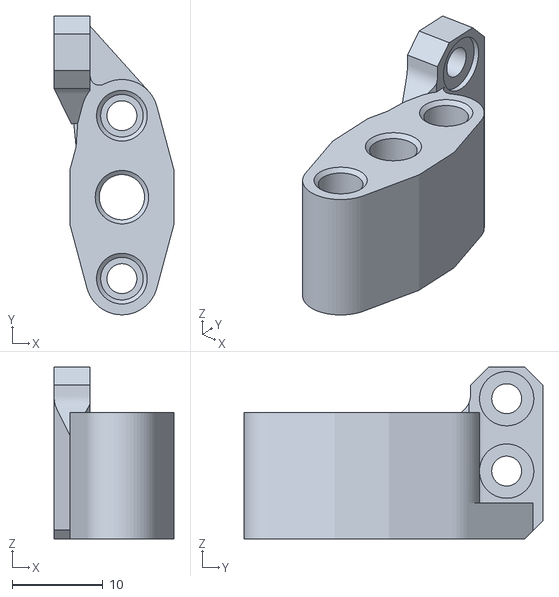
[picture p58: CAD file, 2022-12-26]
docs/assets/stl/eva2_4/bl_touch_mount_volcano.stl
13.2 x 33.0 x 19.0
