ZeroGDesign/docs/docs/assets/stl/eva2_4/copperhead_support_b.stl

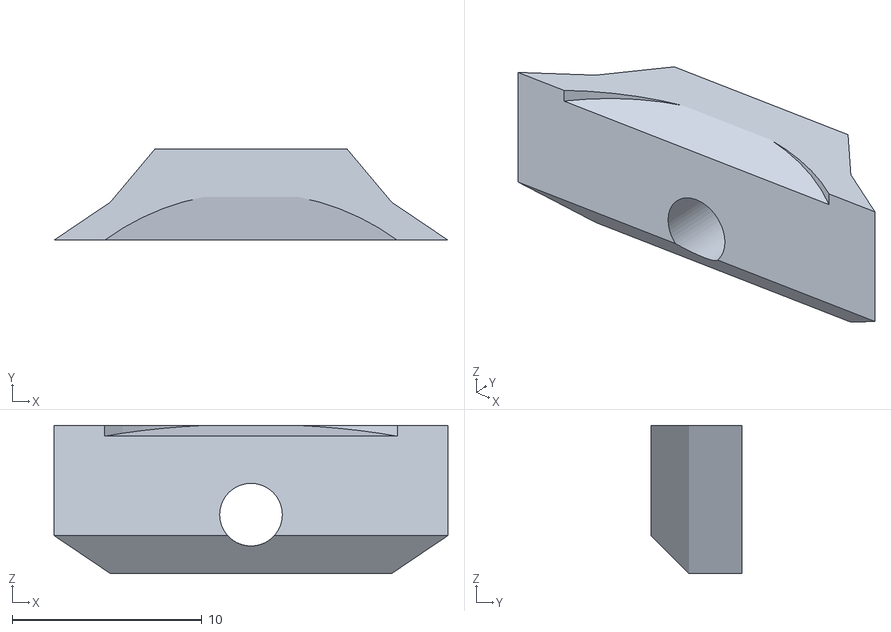
[picture p59: CAD file, 2022-12-26]
docs/assets/stl/eva2_4/copperhead_support_b.stl
20.8 x 4.81 x 7.80
