ZeroGDesign/docs/docs/assets/stl/electronics_enclosure/DIN-UHP200-M3_heatset_2.stl

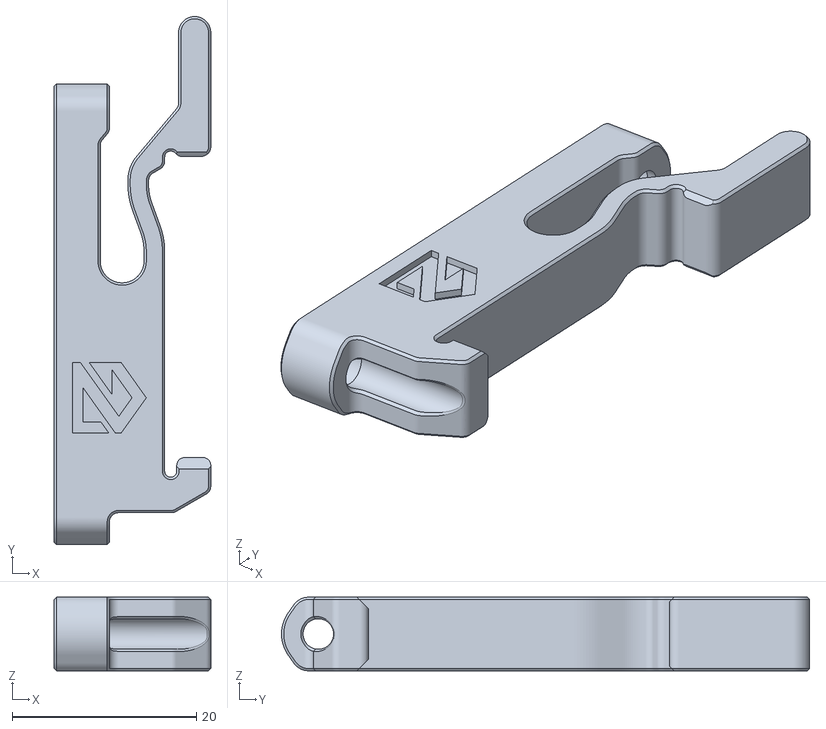
[picture p60: CAD file, 2023-03-29]
docs/assets/stl/electronics_enclosure/DIN-UHP200-M3_heatset_2.stl
17.0 x 57.3 x 8.00
