ZeroGDesign/docs/docs/assets/stl/eva2_4/v6_support.stl

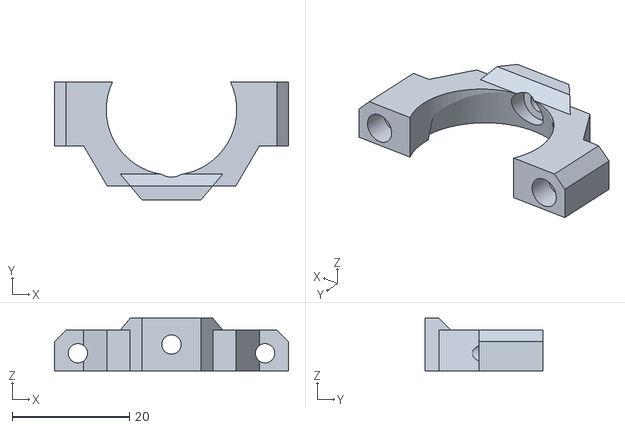
[picture p61: CAD file, 2022-12-26]
docs/assets/stl/eva2_4/v6_support.stl
40.0 x 20.2 x 9.00
