ZeroGDesign/docs/docs/assets/stl/electronics_enclosure/DIN-WS2403DY-M2.5.stl

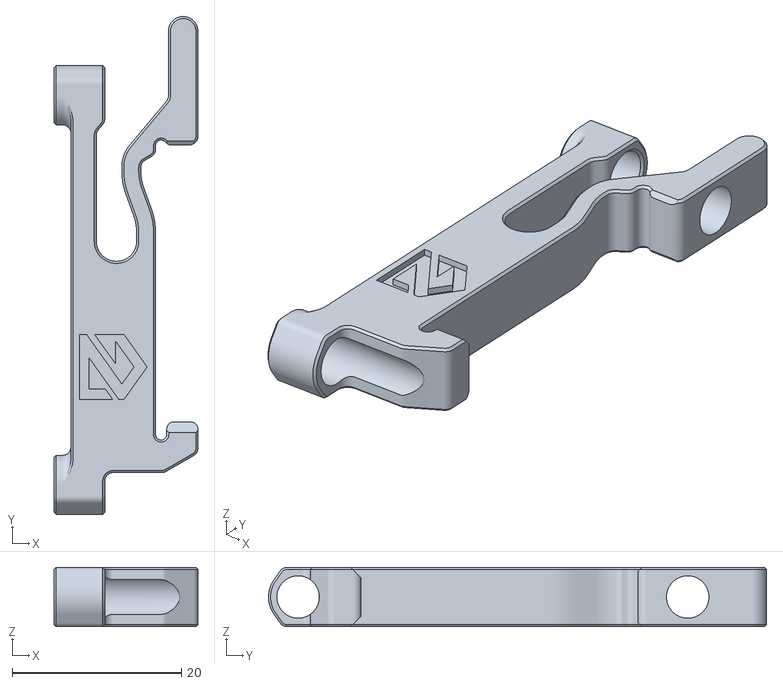
[picture p62: CAD file, 2023-03-29]
docs/assets/stl/electronics_enclosure/DIN-WS2403DY-M2.5.stl
17.0 x 58.8 x 7.00
