ZeroGDesign/docs/docs/assets/stl/eva2_4/bl_touch_mount.stl

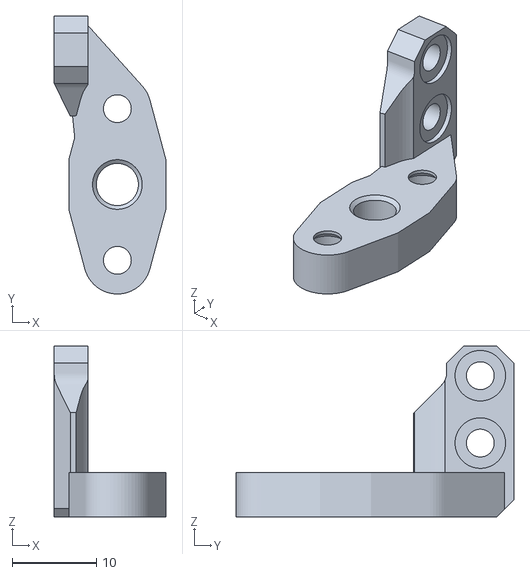
[picture p63: CAD file, 2022-12-26]
docs/assets/stl/eva2_4/bl_touch_mount.stl
13.2 x 33.0 x 20.2
