ZeroGDesign/docs/docs/assets/stl/eva2_4/Orbiter_1_5_TOP.stl

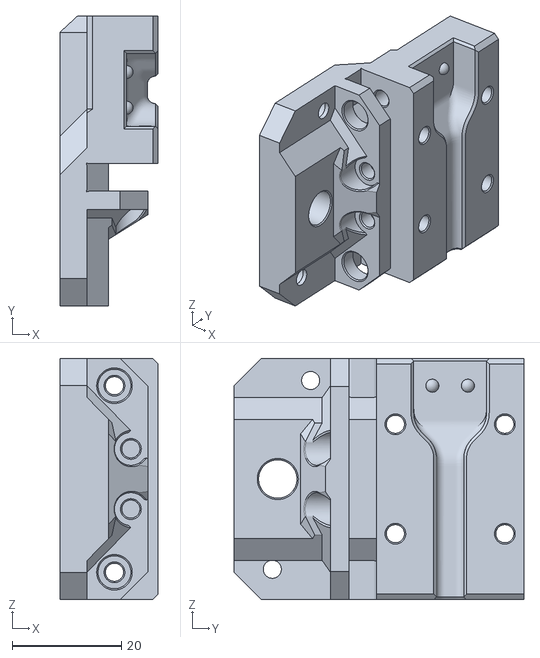
[picture p64: CAD file, 2022-12-26]
docs/assets/stl/eva2_4/Orbiter_1_5_TOP.stl
18.0 x 53.0 x 44.1
