ZeroGDesign/docs/docs/assets/stl/electronics_enclosure/DIN-Octopus-M3_heatset_2.stl

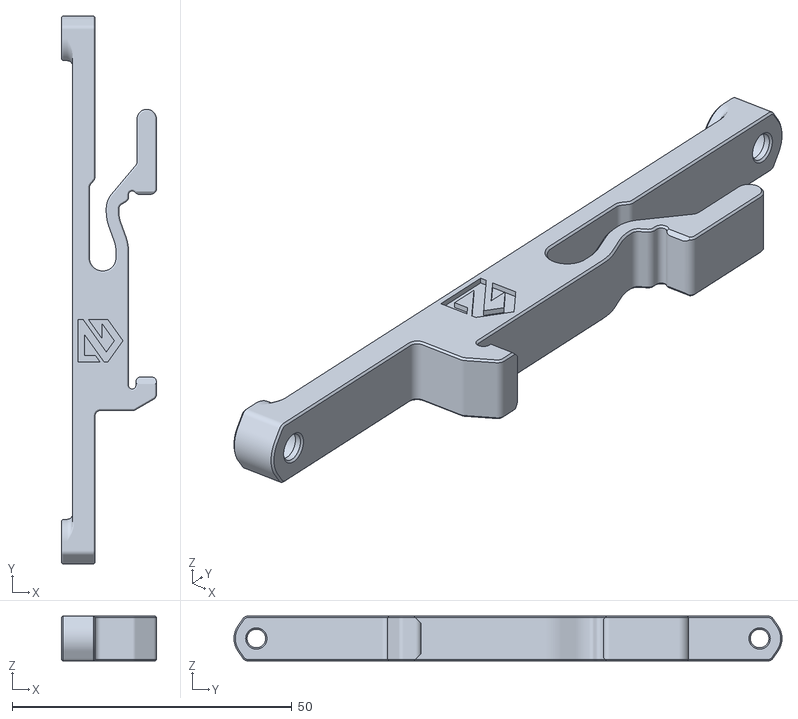
[picture p65: CAD file, 2023-03-29]
docs/assets/stl/electronics_enclosure/DIN-Octopus-M3_heatset_2.stl
17.0 x 98.0 x 8.00
