ZeroGDesign/docs/docs/assets/stl/electronics_enclosure/DIN-Generic-M2_5_threaded_2.stl

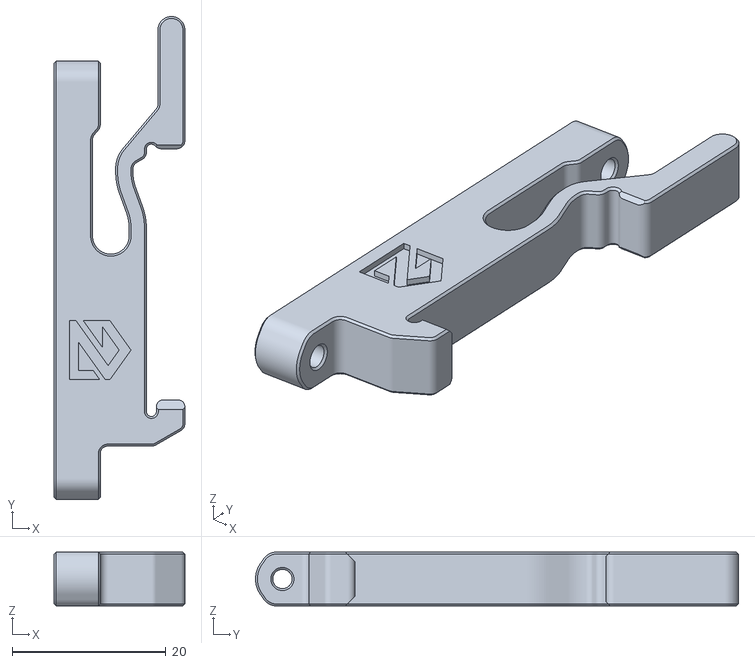
[picture p66: CAD file, 2023-03-29]
docs/assets/stl/electronics_enclosure/DIN-Generic-M2_5_threaded_2.stl
17.0 x 62.8 x 7.00
