ZeroGDesign/docs/docs/assets/stl/eva2_4/bmo_face.stl

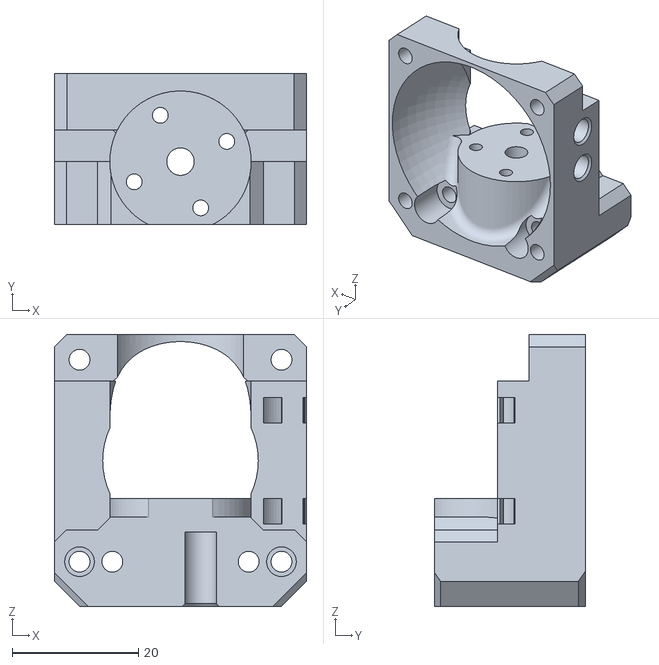
[picture p67: CAD file, 2022-12-26]
docs/assets/stl/eva2_4/bmo_face.stl
40.0 x 24.0 x 43.1
