ZeroGDesign/docs/docs/assets/stl/eva2_4/dragon_face.stl

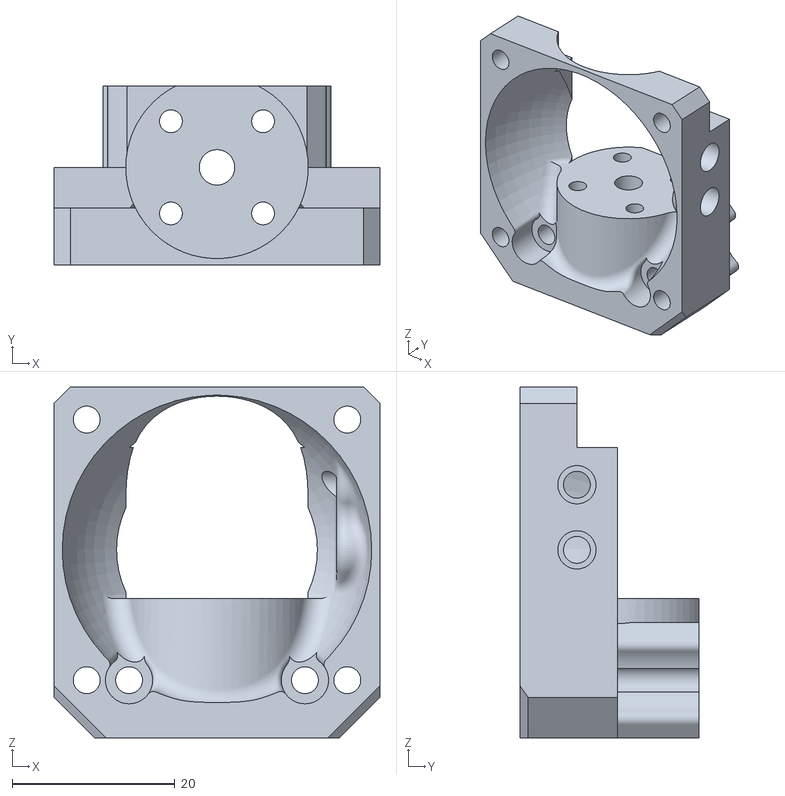
[picture p68: CAD file, 2022-12-26]
docs/assets/stl/eva2_4/dragon_face.stl
40.0 x 22.0 x 43.1
