ZeroGDesign/docs/docs/assets/stl/electronics_enclosure/DIN-Pi-M2_5_2.stl

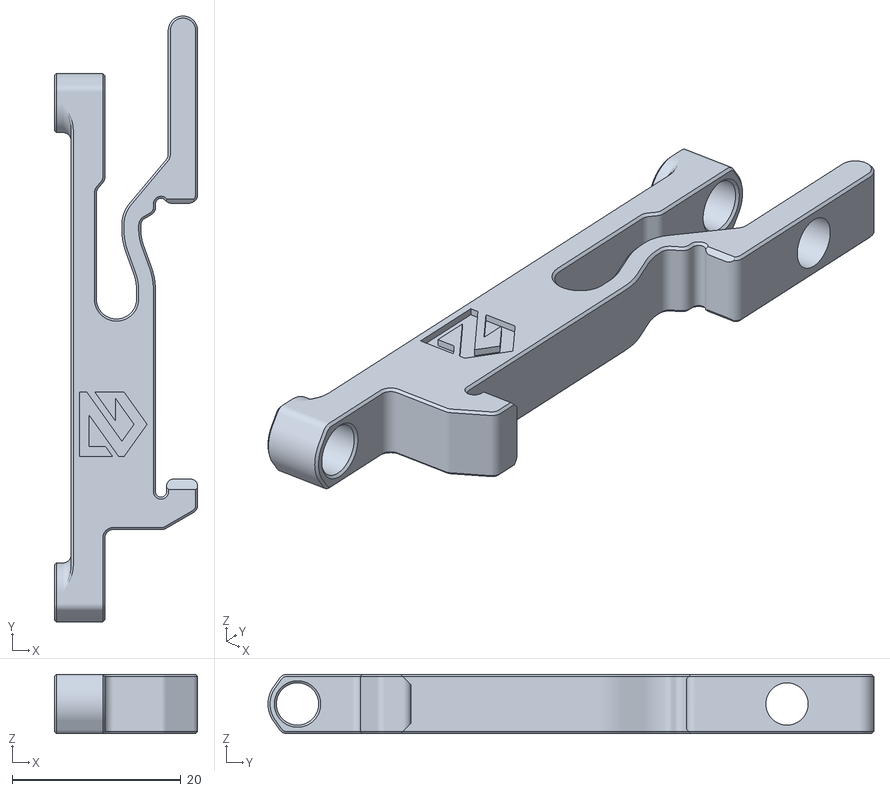
[picture p69: CAD file, 2023-03-29]
docs/assets/stl/electronics_enclosure/DIN-Pi-M2_5_2.stl
17.0 x 71.8 x 7.00
