ZeroGDesign/docs/docs/assets/stl/eva2_4/TOP.stl

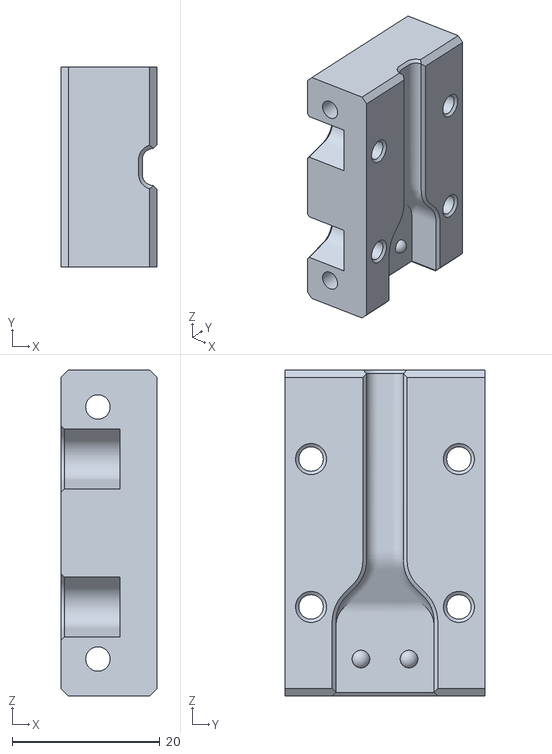
[picture p70: CAD file, 2022-12-26]
docs/assets/stl/eva2_4/TOP.stl
13.0 x 27.0 x 44.1
