ZeroGDesign/docs/docs/assets/stl/electronics_enclosure/DIN-U2C-V2_1-M3_heatset_1.stl

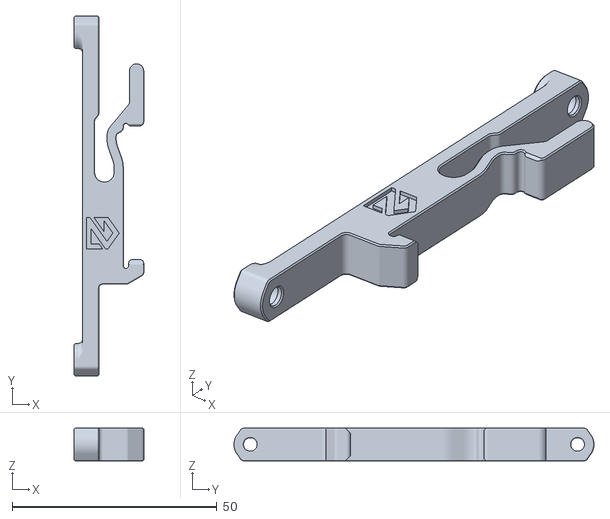
[picture p71: CAD file, 2023-03-29]
docs/assets/stl/electronics_enclosure/DIN-U2C-V2_1-M3_heatset_1.stl
17.0 x 88.0 x 8.00
