ZeroGDesign/docs/docs/assets/stl/eva2_4/copperhead_support_a.stl

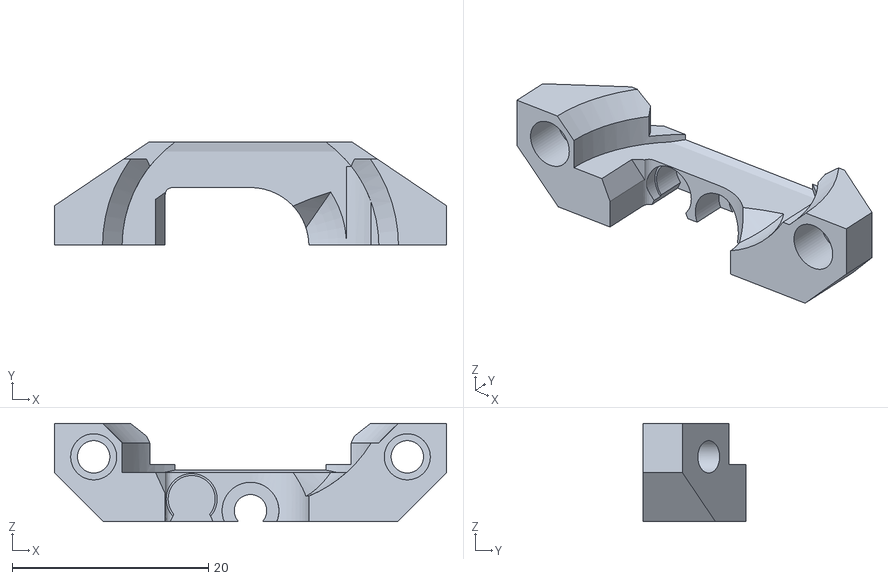
[picture p72: CAD file, 2022-12-26]
docs/assets/stl/eva2_4/copperhead_support_a.stl
40.0 x 10.5 x 10.0
