ZeroGDesign/docs/docs/assets/stl/electronics_enclosure/DIN-UHP350-M3_heatset_1.stl

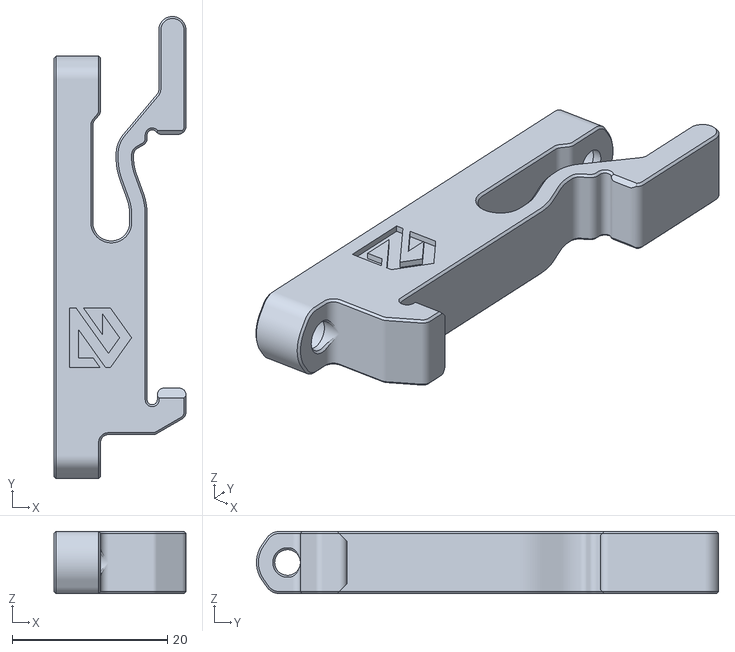
[picture p73: CAD file, 2023-03-29]
docs/assets/stl/electronics_enclosure/DIN-UHP350-M3_heatset_1.stl
17.0 x 59.5 x 8.00
