ZeroGDesign/docs/docs/assets/stl/eva2_4/v6_face_clamp.stl

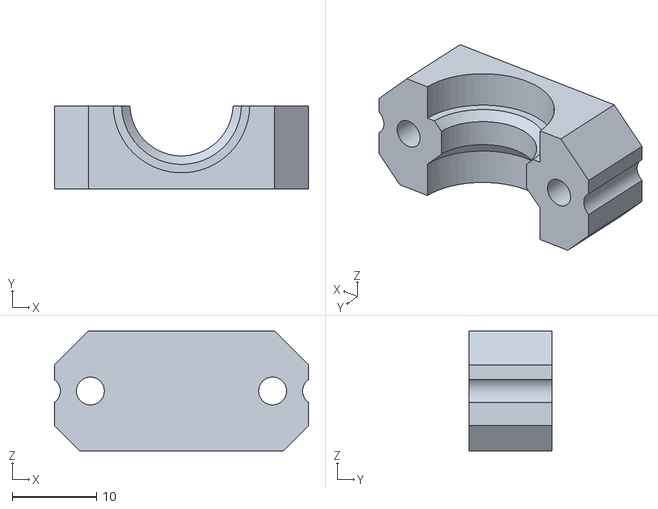
[picture p74: CAD file, 2022-12-26]
docs/assets/stl/eva2_4/v6_face_clamp.stl
30.1 x 9.80 x 14.2
