ZeroGDesign/docs/docs/assets/stl/electronics_enclosure/Clip_Base_x4.stl

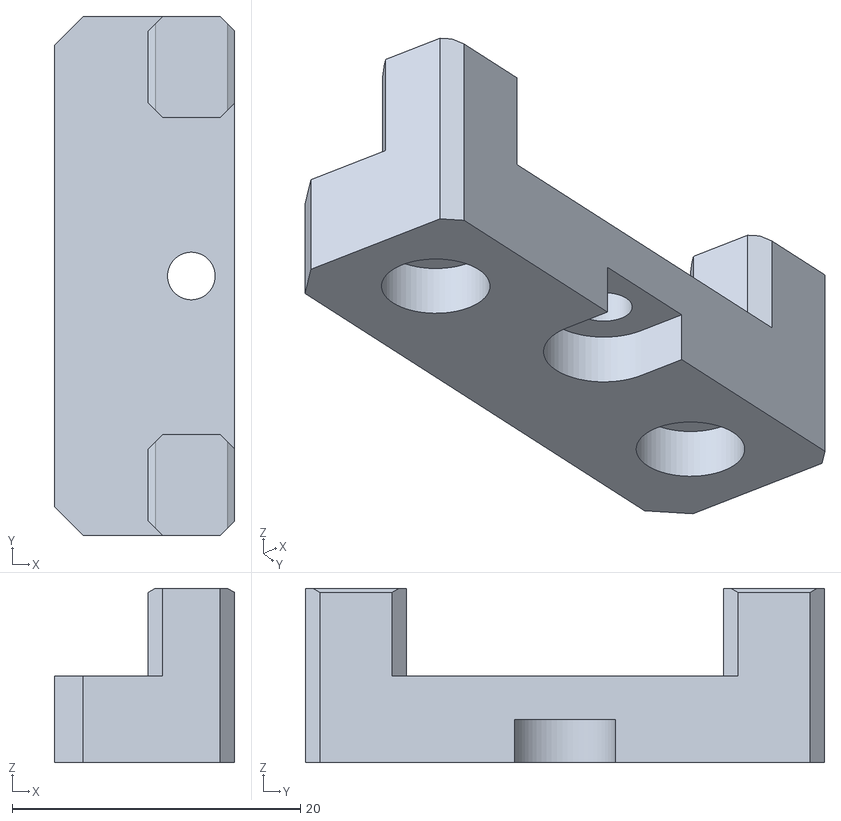
[picture p75: CAD file, 2023-03-29]
docs/assets/stl/electronics_enclosure/Clip_Base_x4.stl
12.5 x 36.0 x 12.1
