ZeroGDesign/docs/docs/assets/stl/eva2_4/cr_touch_mount.stl

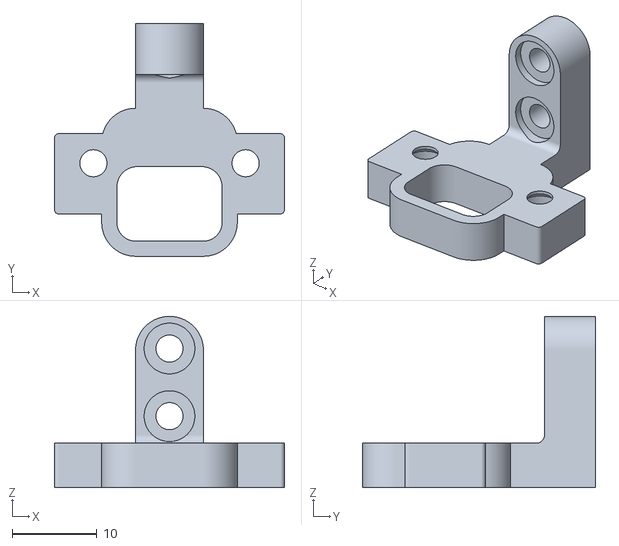
[picture p76: CAD file, 2022-12-26]
docs/assets/stl/eva2_4/cr_touch_mount.stl
27.2 x 27.5 x 20.2
