ZeroGDesign/docs/docs/assets/stl/electronics_enclosure/SKR_Mini_and_Creality.stl

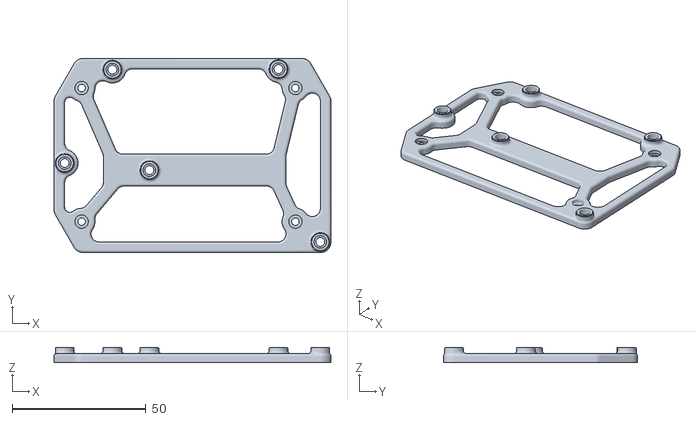
[picture p77: CAD file, 2023-03-29]
docs/assets/stl/electronics_enclosure/SKR_Mini_and_Creality.stl
103.7 x 72.7 x 5.80
