ZeroGDesign/docs/docs/assets/stl/eva2_4/face_rapido.stl

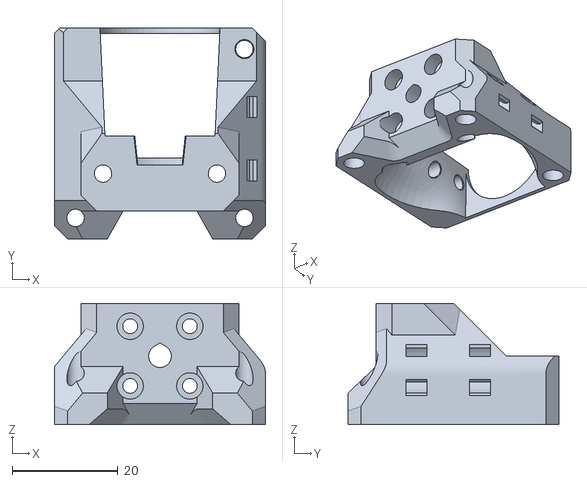
[picture p78: CAD file, 2022-12-26]
docs/assets/stl/eva2_4/face_rapido.stl
40.0 x 40.0 x 23.0
