ZeroGDesign/docs/docs/assets/stl/electronics_enclosure/DIN-5PL-Mosfet-M3_heatset.stl

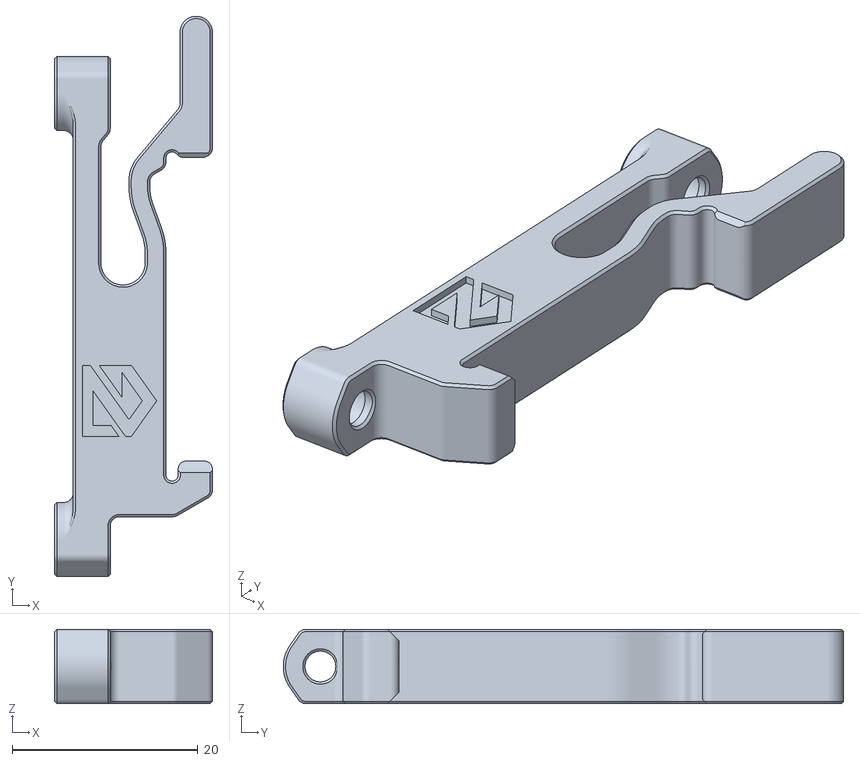
[picture p79: CAD file, 2023-03-29]
docs/assets/stl/electronics_enclosure/DIN-5PL-Mosfet-M3_heatset.stl
17.0 x 60.3 x 8.00
