ZeroGDesign/docs/docs/assets/stl/eva2_4/copperhead_face.stl

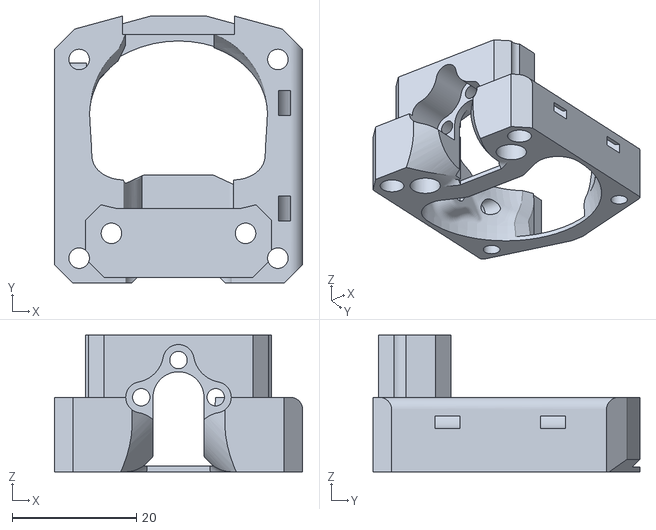
[picture p80: CAD file, 2022-12-26]
docs/assets/stl/eva2_4/copperhead_face.stl
40.0 x 43.0 x 22.0
