ZeroGDesign/docs/docs/assets/stl/eva2_4/v6_face.stl

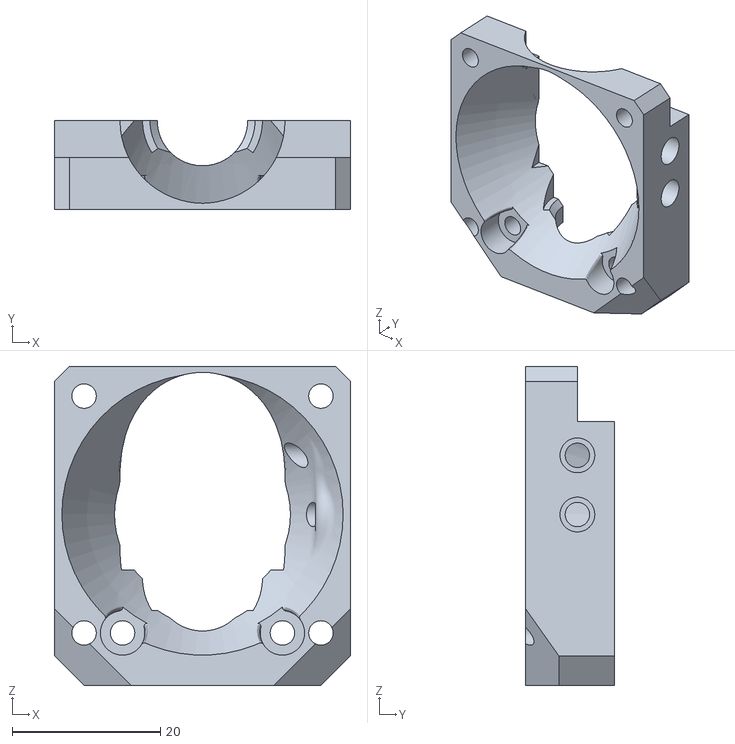
[picture p81: CAD file, 2022-12-26]
docs/assets/stl/eva2_4/v6_face.stl
40.0 x 12.0 x 43.1
