ZeroGDesign/docs/docs/assets/stl/eva2_4/mosquito_face.stl

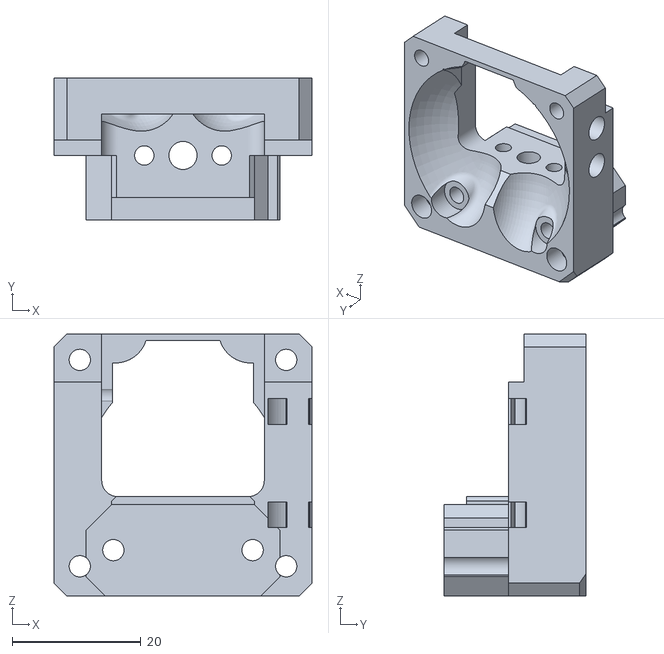
[picture p82: CAD file, 2022-12-26]
docs/assets/stl/eva2_4/mosquito_face.stl
40.0 x 22.0 x 40.6
