ZeroGDesign/docs/docs/assets/stl/electronics_enclosure/DIN-RS-25-5-Rig_heatset.stl

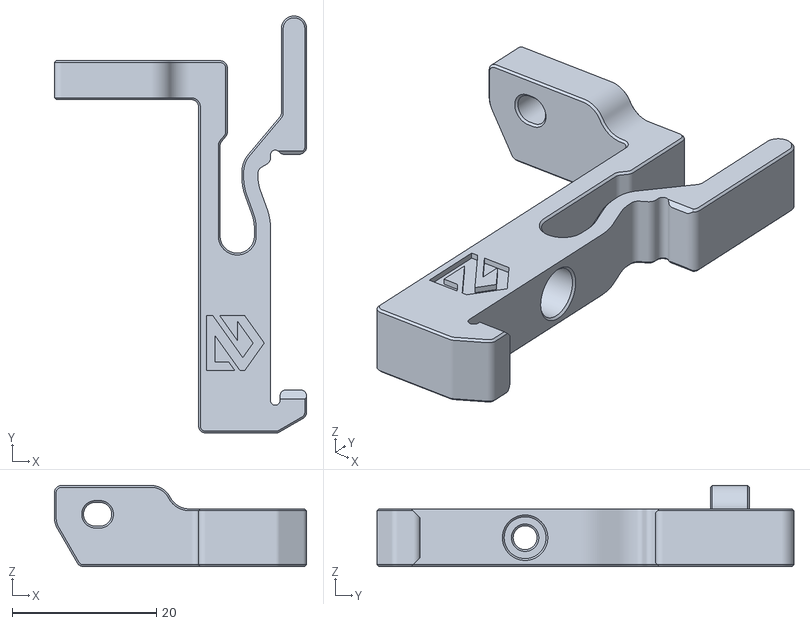
[picture p83: CAD file, 2023-03-29]
docs/assets/stl/electronics_enclosure/DIN-RS-25-5-Rig_heatset.stl
35.0 x 57.9 x 11.2
