ZeroGDesign/docs/docs/assets/stl/eva2_4/BMG_TOP.stl

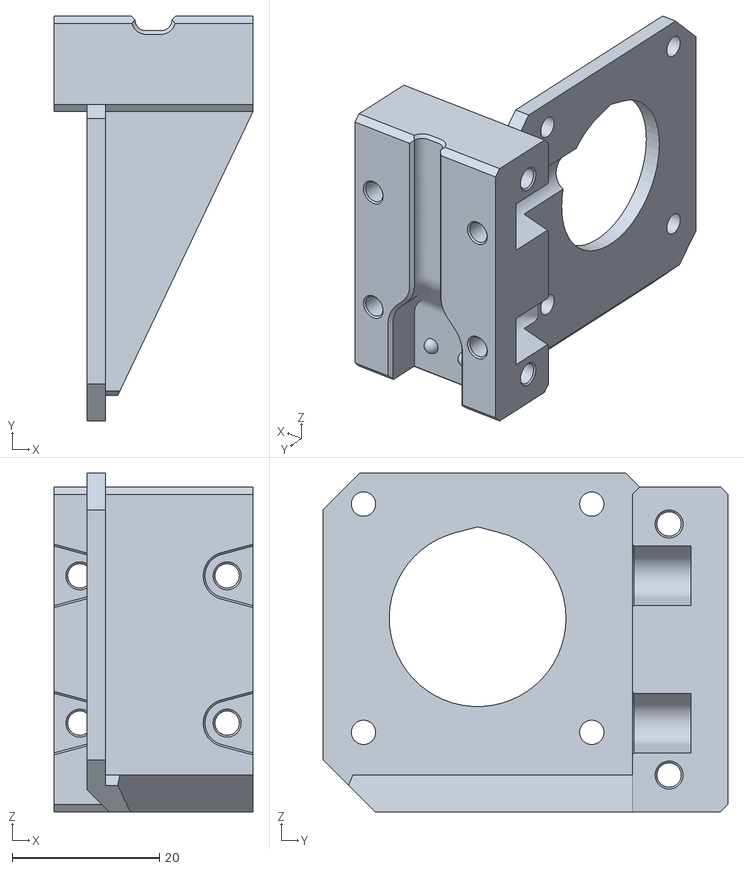
[picture p84: CAD file, 2022-12-26]
docs/assets/stl/eva2_4/BMG_TOP.stl
27.0 x 55.0 x 46.0
