ZeroGDesign/docs/docs/assets/stl/electronics_enclosure/DIN-M8PRT-M3_heatset.stl

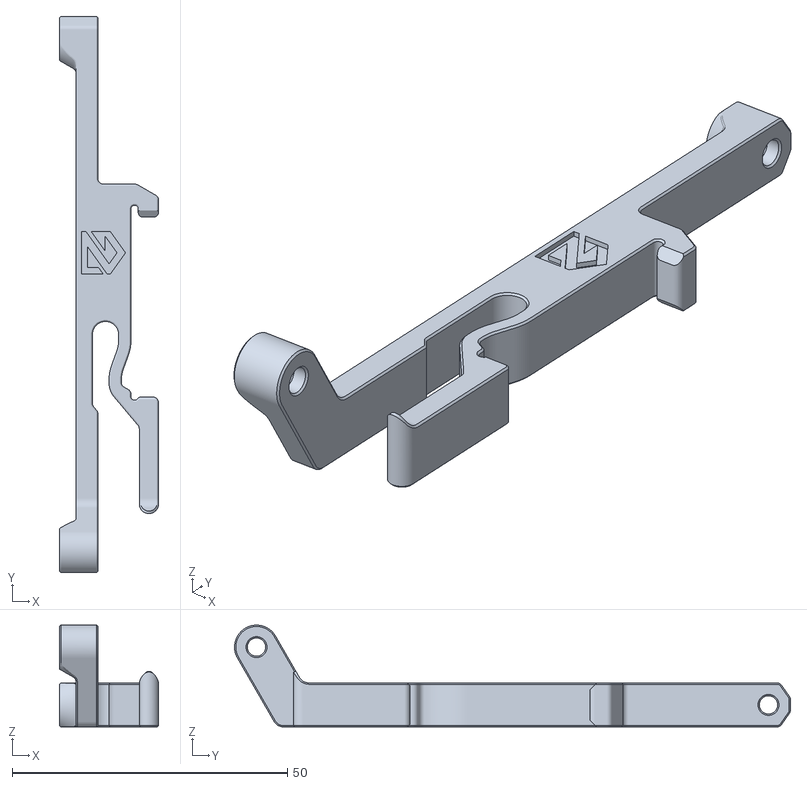
[picture p85: CAD file, 2023-03-29]
docs/assets/stl/electronics_enclosure/DIN-M8PRT-M3_heatset.stl
18.0 x 101.0 x 18.5
