ZeroGDesign/docs/docs/assets/stl/eva2_4/bl_touch_mount_alt_volcano.stl

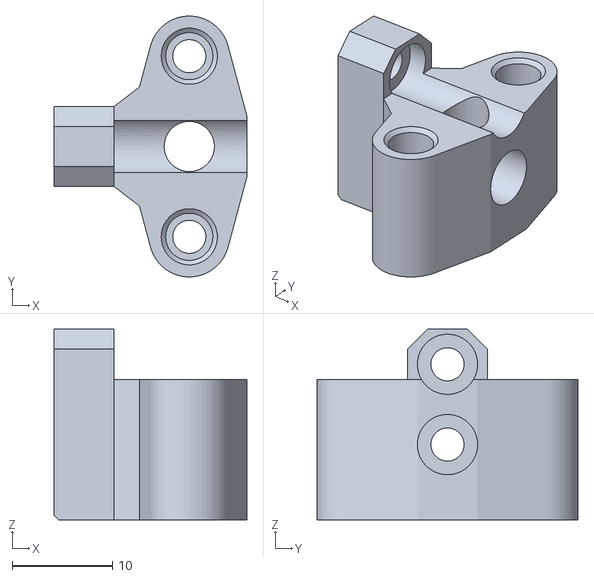
[picture p86: CAD file, 2022-12-26]
docs/assets/stl/eva2_4/bl_touch_mount_alt_volcano.stl
19.2 x 26.0 x 19.0
