ZeroGDesign/docs/docs/assets/stl/electronics_enclosure/DIN-RS-25-5-Left.stl

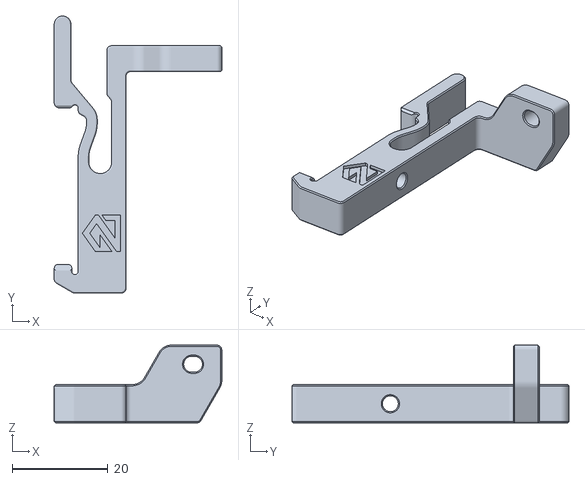
[picture p87: CAD file, 2023-03-29]
docs/assets/stl/electronics_enclosure/DIN-RS-25-5-Left.stl
35.0 x 57.9 x 16.2
