ZeroGDesign/docs/docs/assets/stl/eva2_4/Sherpa_Mini_TOP.stl

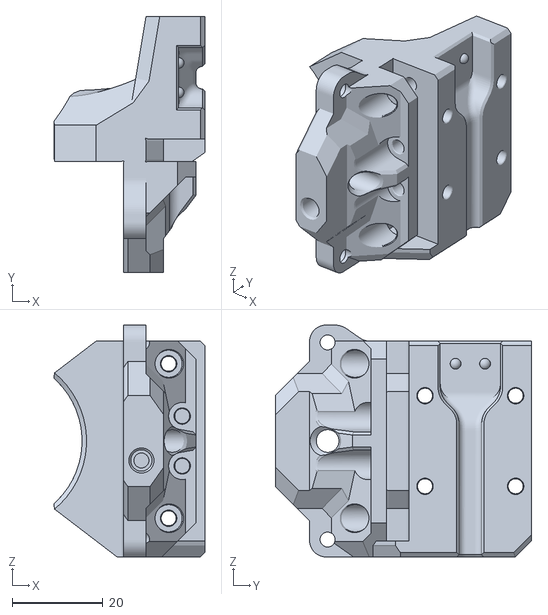
[picture p88: CAD file, 2022-12-26]
docs/assets/stl/eva2_4/Sherpa_Mini_TOP.stl
33.3 x 56.5 x 51.2
