ZeroGDesign/docs/docs/assets/stl/electronics_enclosure/DIN-RSP500-M4TR_2.stl

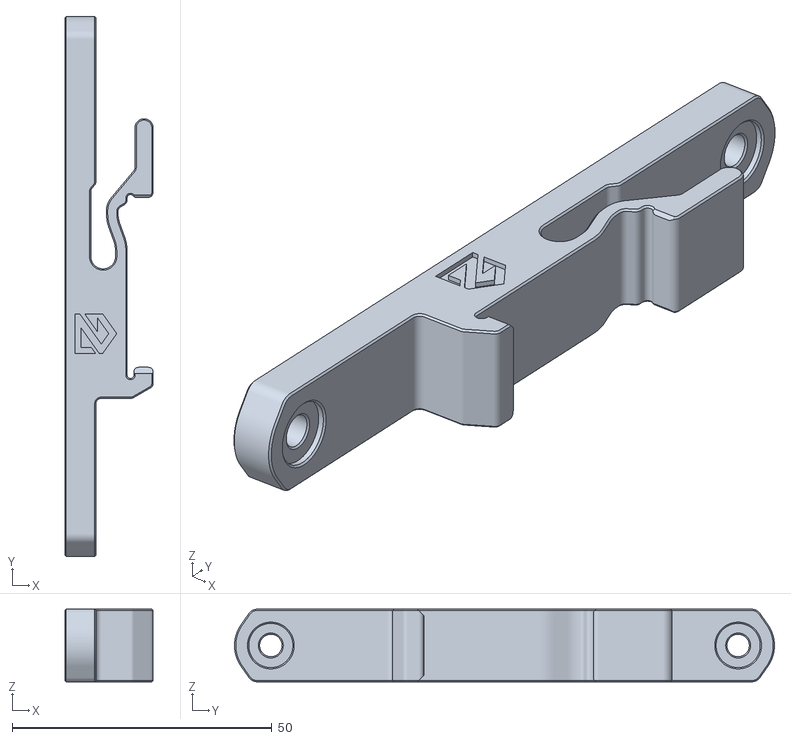
[picture p89: CAD file, 2023-03-29]
docs/assets/stl/electronics_enclosure/DIN-RSP500-M4TR_2.stl
17.0 x 104.0 x 14.0
