ZeroGDesign/docs/docs/assets/stl/eva2_4/mosquito_support.stl

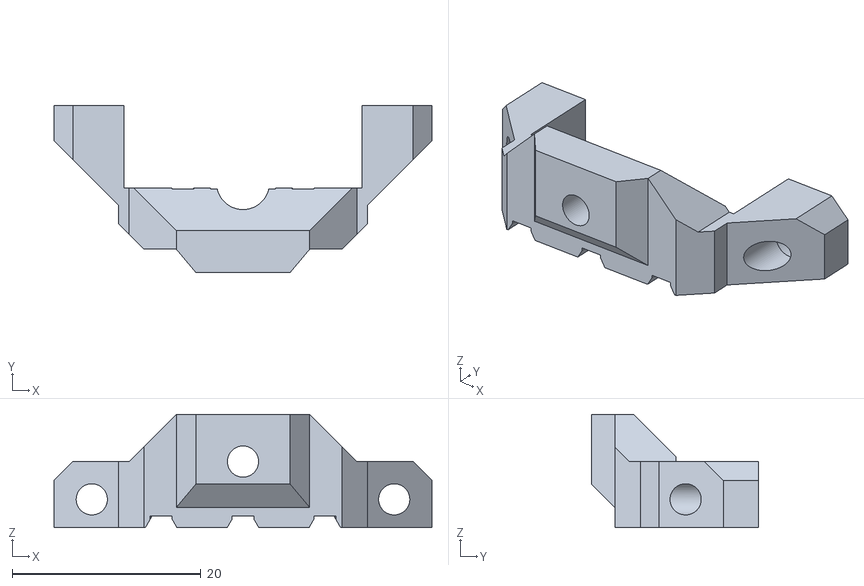
[picture p90: CAD file, 2022-12-26]
docs/assets/stl/eva2_4/mosquito_support.stl
40.0 x 17.6 x 12.0
