ZeroGDesign/docs/docs/assets/stl/electronics_enclosure/DIN_Plate_LM2596.stl

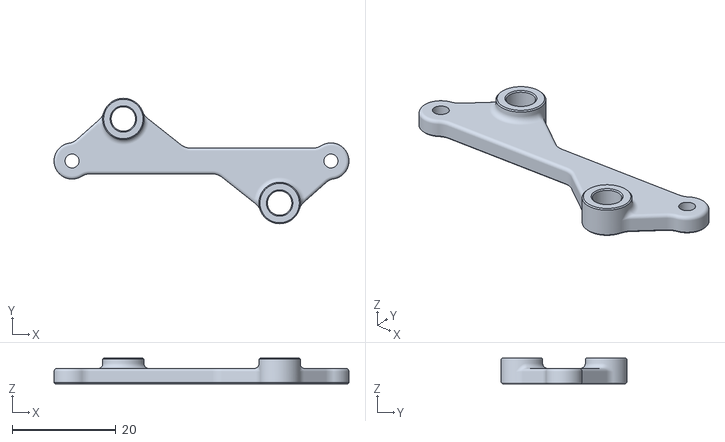
[picture p91: CAD file, 2023-03-29]
docs/assets/stl/electronics_enclosure/DIN_Plate_LM2596.stl
57.0 x 24.2 x 5.00
