ZeroGDesign/docs/docs/assets/stl/eva2_4/bl_touch_mount_alt.stl

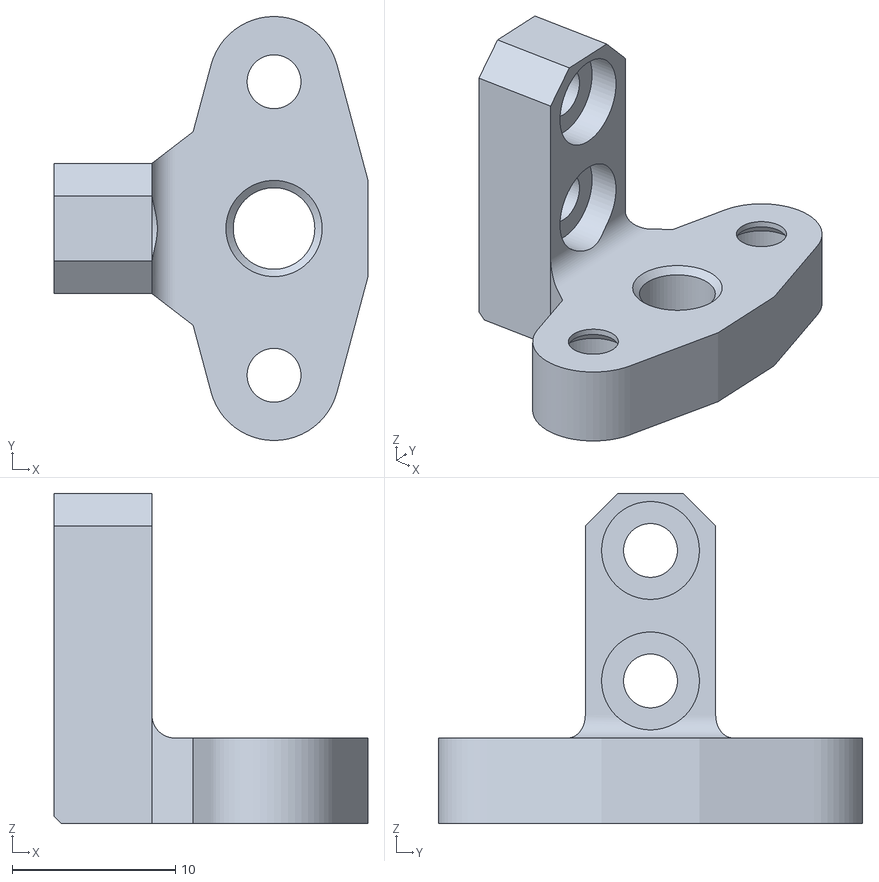
[picture p92: CAD file, 2022-12-26]
docs/assets/stl/eva2_4/bl_touch_mount_alt.stl
19.2 x 26.0 x 20.2
