ZeroGDesign/docs/docs/assets/stl/electronics_enclosure/DIN-M8PLT-M3_heatset.stl

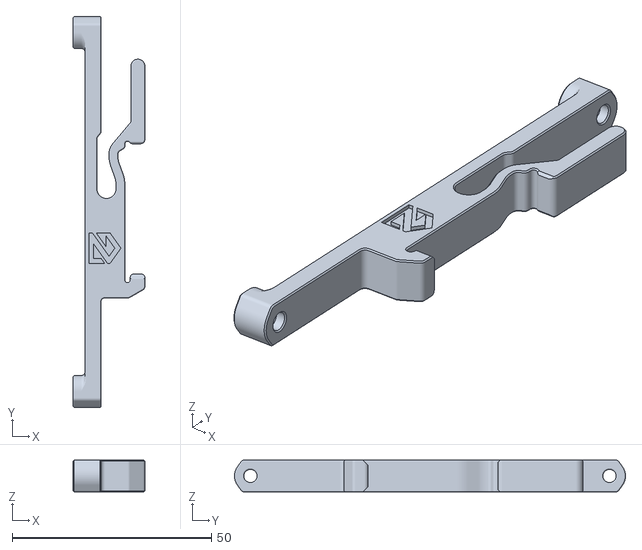
[picture p93: CAD file, 2023-03-29]
docs/assets/stl/electronics_enclosure/DIN-M8PLT-M3_heatset.stl
18.0 x 98.0 x 8.00
