ZeroGDesign/docs/docs/assets/stl/eva2_4/LGX_TOP__b.stl

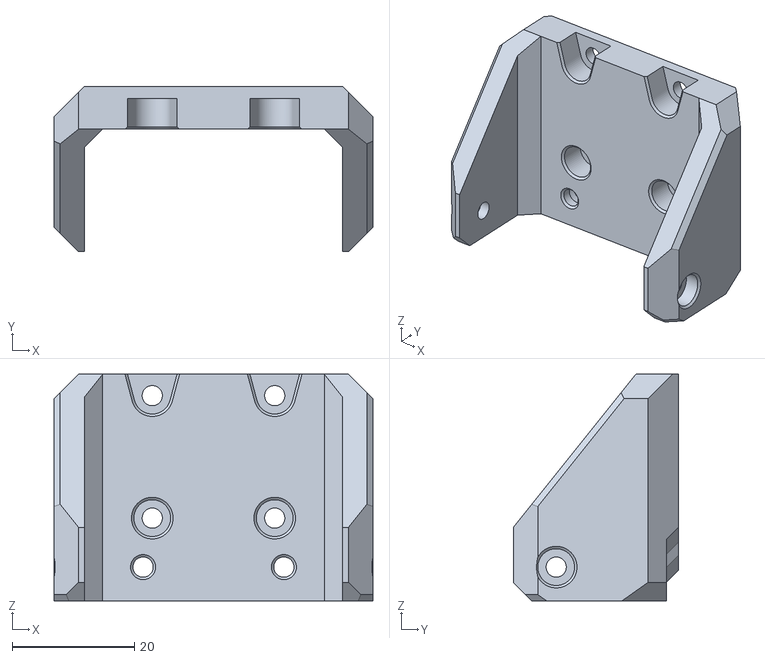
[picture p94: CAD file, 2022-12-26]
docs/assets/stl/eva2_4/LGX_TOP__b.stl
52.1 x 27.0 x 37.0
