ZeroGDesign/docs/docs/assets/stl/electronics_enclosure/DIN-LM2596S-M3_heatset.stl

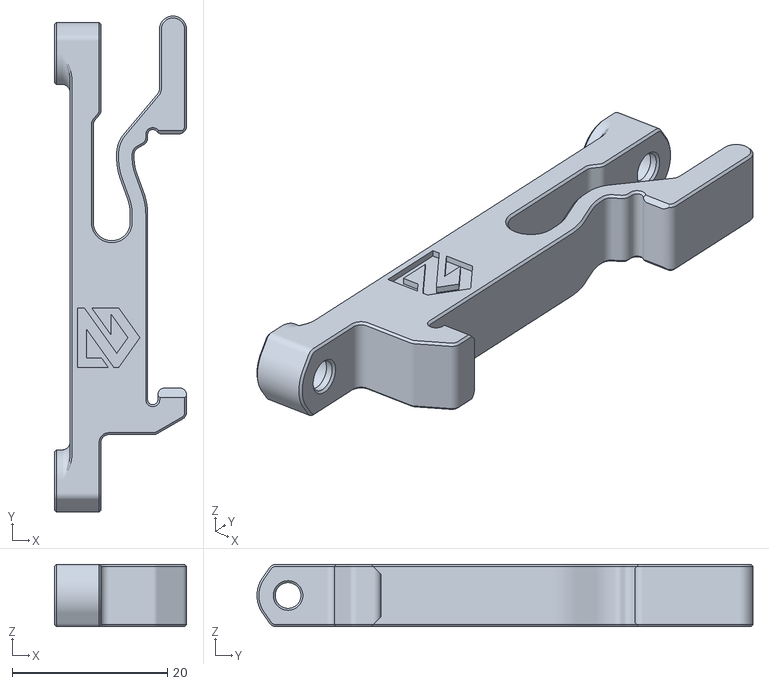
[picture p95: CAD file, 2023-03-29]
docs/assets/stl/electronics_enclosure/DIN-LM2596S-M3_heatset.stl
17.0 x 63.8 x 8.00
