ZeroGDesign/docs/docs/assets/stl/eva2_4/Titan_TOP.stl

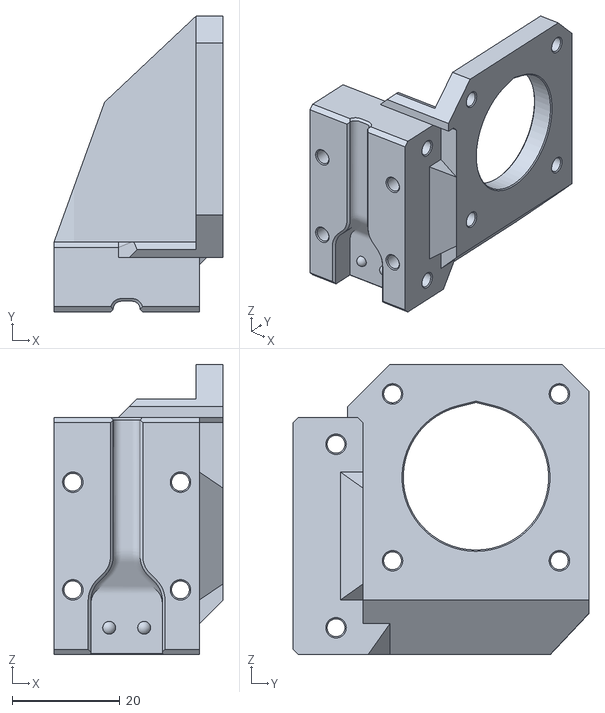
[picture p96: CAD file, 2022-12-26]
docs/assets/stl/eva2_4/Titan_TOP.stl
31.4 x 55.0 x 54.0
