ZeroGDesign/docs/docs/assets/stl/eva2_4/a_EVA_Backplate_Merc_Support_V1-1.stl

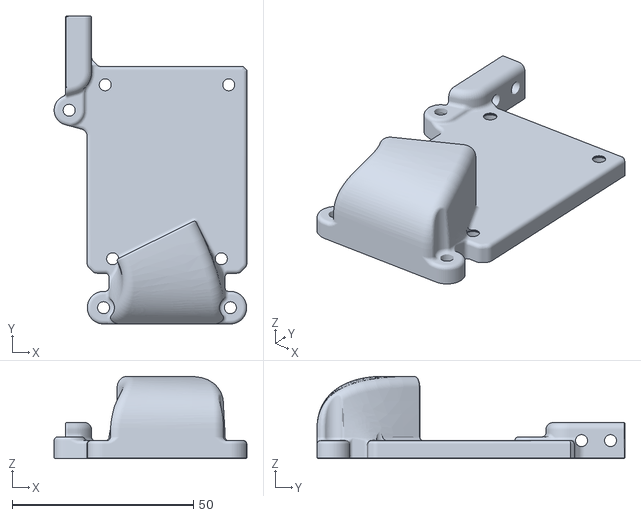
[picture p97: CAD file, 2022-07-31]
docs/assets/stl/eva2_4/a_EVA_Backplate_Merc_Support_V1-1.stl
53.2 x 85.0 x 22.8
