ZeroGDesign/docs/docs/assets/stl/eva2_4/RearCableArm_V1-1.stl

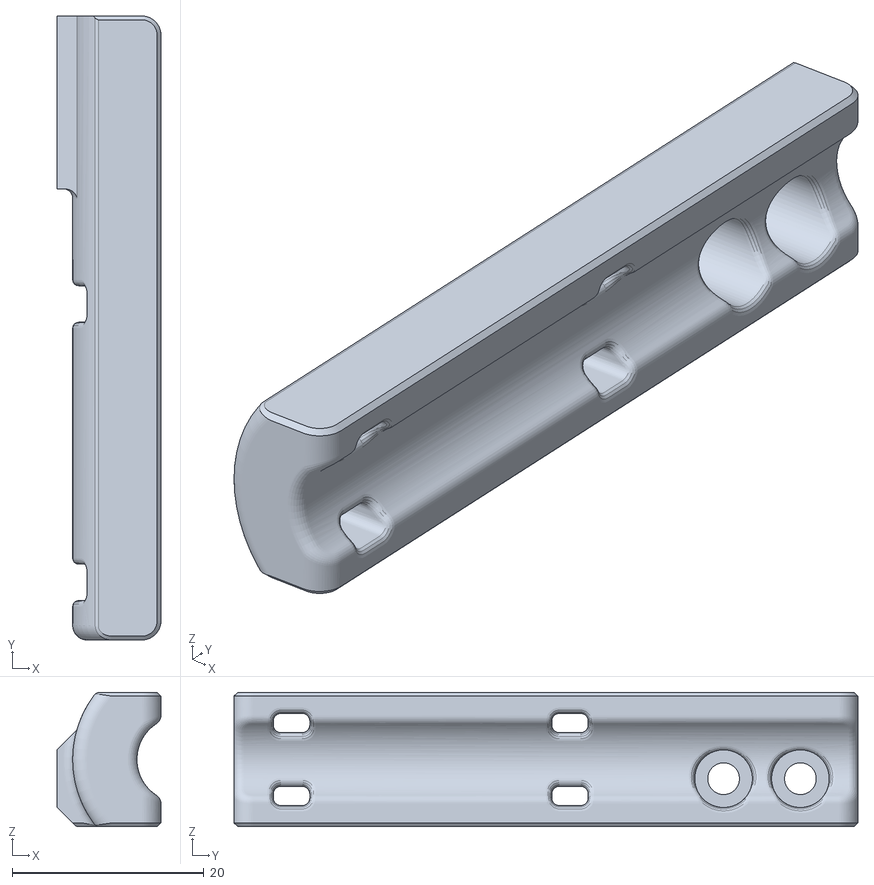
[picture p98: CAD file, 2022-07-31]
docs/assets/stl/eva2_4/RearCableArm_V1-1.stl
10.8 x 65.0 x 14.0
