ZeroGDesign/docs/docs/assets/stl/eva2_4/a_EVA_FrontPlate_HD_V-1-1.stl

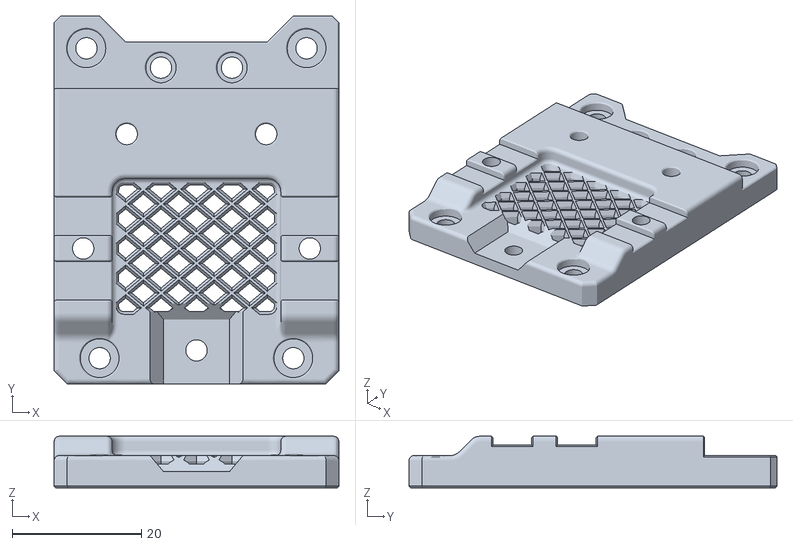
[picture p99: CAD file, 2022-07-31]
docs/assets/stl/eva2_4/a_EVA_FrontPlate_HD_V-1-1.stl
44.1 x 57.0 x 8.00
