ZeroGDesign/docs/docs/assets/stl/eva2_4/LJ12_probe_mount.stl

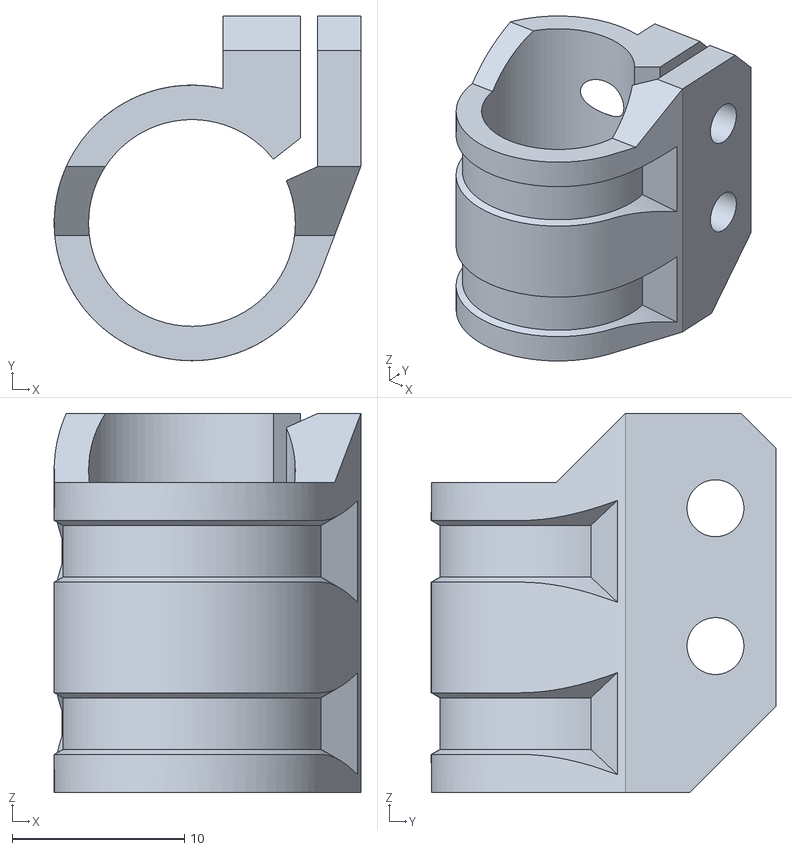
[picture p100: CAD file, 2022-07-12]
docs/assets/stl/eva2_4/LJ12_probe_mount.stl
17.8 x 20.0 x 22.0
