ZeroGDesign/docs/docs/assets/stl/eva2_4/LJ18_probe_mount.stl

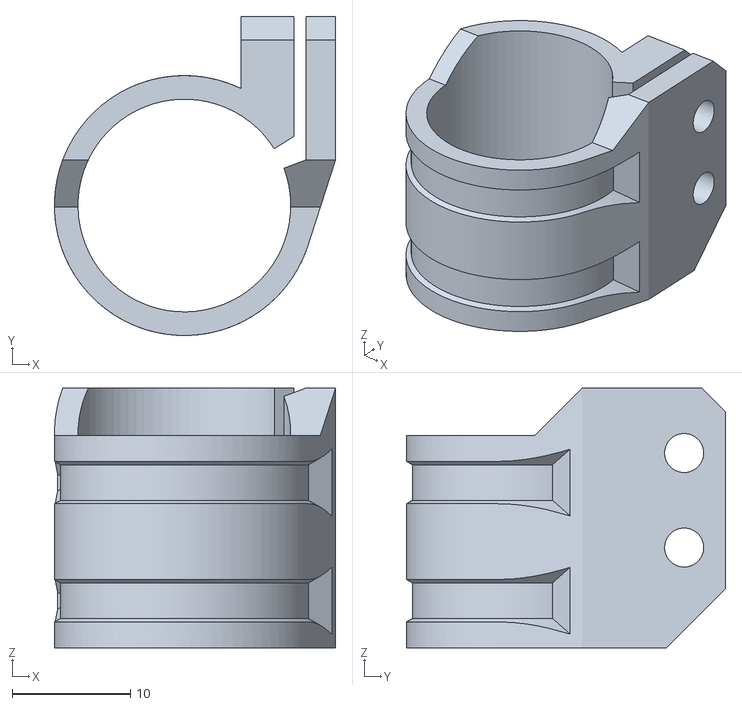
[picture p101: CAD file, 2022-07-12]
docs/assets/stl/eva2_4/LJ18_probe_mount.stl
23.8 x 27.0 x 22.0
