ZeroGDesign/docs/docs/assets/stl/eva2_4/Belt_clamp_1.stl

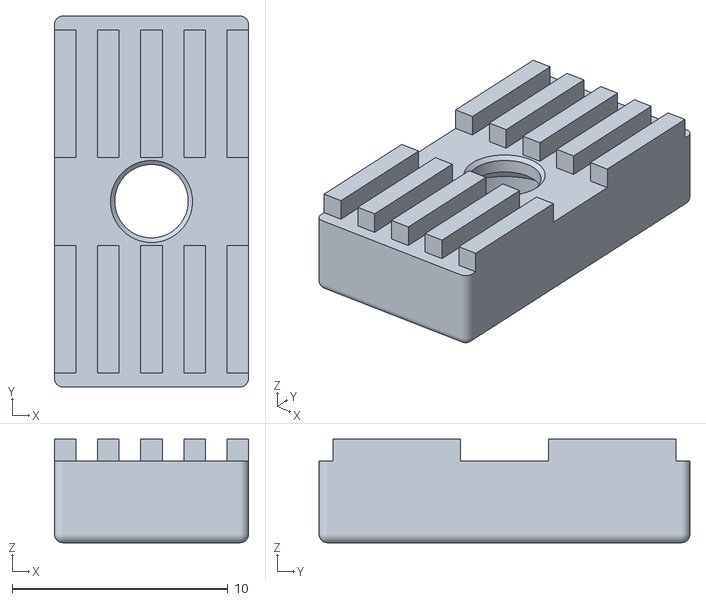
[picture p102: CAD file, 2022-07-12]
docs/assets/stl/eva2_4/Belt_clamp_1.stl
9.00 x 17.2 x 4.80
