ZeroGDesign/docs/docs/assets/stl/eva2_4/a_X_Limit_Stop_Block.stl

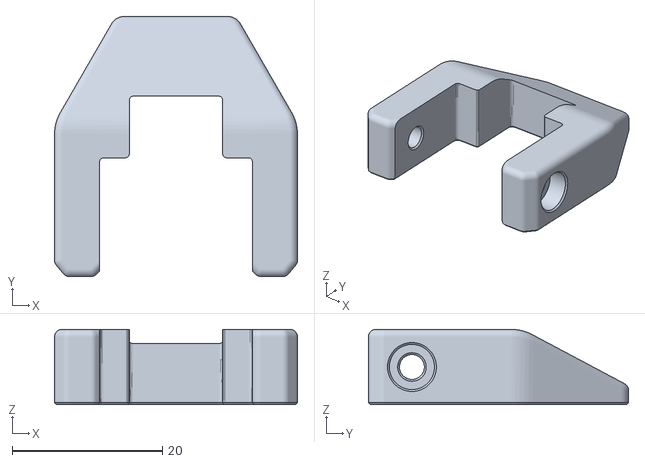
[picture p103: CAD file, 2022-07-12]
docs/assets/stl/eva2_4/a_X_Limit_Stop_Block.stl
32.3 x 34.6 x 10.0
