ZeroGDesign/docs/docs/assets/stl/eva2_4/LJ8_probe_mount.stl

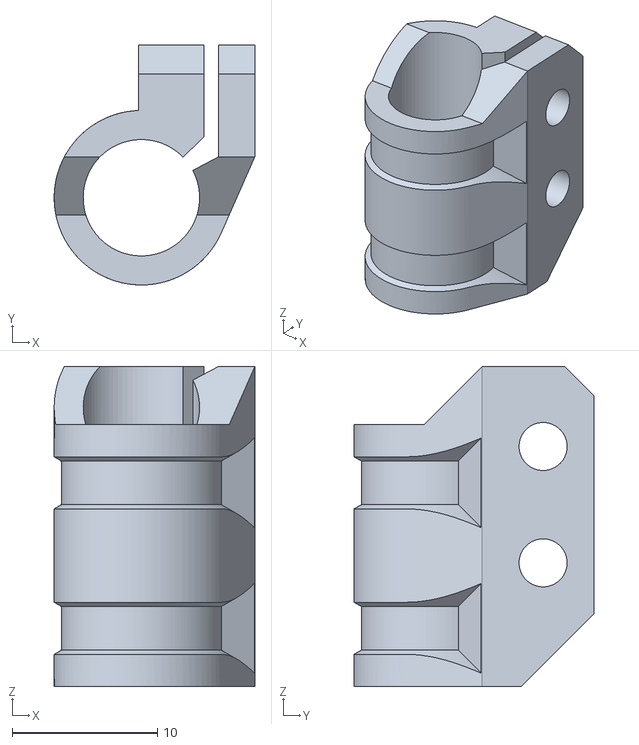
[picture p104: CAD file, 2022-07-12]
docs/assets/stl/eva2_4/LJ8_probe_mount.stl
13.8 x 16.5 x 22.0
