ZeroGDesign/docs/(list of files, cad)

Other CAD files:
docs/assets/stl/eva2_4/bmo_support.stl
docs/assets/stl/electronics_enclosure/2020_Cable_Tie_x3.stl
docs/assets/stl/m1_1/RearSplitloomArm_V1-1-0.stl
docs/assets/stl/m1_1/XJoint_left_bottom.stl
docs/assets/stl/m1_1/XJoint_left_top.stl
docs/assets/stl/m1_1/XJoint_right_bottom.stl
docs/assets/stl/m1_1/XJoint_right_top.stl
docs/assets/stl/m1_1/Z_DropBracket_5Pro_1.stl
docs/assets/stl/m1_1/Z_DropBracket_5Pro_2.stl
docs/assets/stl/m1_1/a_FlangeSpacer_pair.stl
docs/assets/stl/m1_1/a_Xjoint_10mm_Idler_Spacers.stl
docs/assets/stl/m1_1/a_Xjoint_8mm_Idler_Spacers.stl
docs/assets/stl/m1_1/a_Xjoint_9mm_Idler_Spacers.stl
docs/assets/stl/m1_1/a_front_tower_left.stl
docs/assets/stl/m1_1/a_front_tower_right.stl
docs/assets/stl/m1_1/a_stepper_mount_bottom_left.stl
docs/assets/stl/m1_1/a_stepper_mount_bottom_right.stl
docs/assets/stl/m1_1/a_stepper_mount_top_left.stl
docs/assets/stl/m1_1/a_stepper_mount_top_right.stl
docs/assets/stl/m1_1/customExtrusion/x_endstop_block.stl
docs/assets/stl/m1_1/customExtrusion/x_endstop_block_PLUS.stl
docs/assets/stl/m1_1/front_tension_plate_t-nut_1.stl
docs/assets/stl/m1_1/front_tension_plate_t-nut_2.stl
docs/assets/stl/m1_1/front_tension_plate_tapped_1.stl
docs/assets/stl/m1_1/front_tension_plate_tapped_2.stl
docs/assets/stl/m1_1/front_tower_tool.stl
docs/assets/stl/m1_1/front_tower_tool_brass.stl
docs/assets/stl/m1_1/left_pulley_alignment_tool.stl
docs/assets/stl/m1_1/plus_only_bed_raiser_1.stl
docs/assets/stl/m1_1/plus_only_bed_raiser_2.stl
docs/assets/stl/m1_1/plus_only_bed_raiser_3.stl
docs/assets/stl/m1_1/plus_only_bed_raiser_4.stl
docs/assets/stl/m1_1/rail_alignment_tool.stl
docs/assets/stl/m1_1/right_pulley_alignment_tool.stl
docs/assets/stl/m1_1/y_endstop.stl
