ZeroGDesign/docs/docs/pages/howto/howto_hardware.md

---
layout: default
title: Tools You Need
nav_order: 2
has_children: false
has_toc: false
parent: How To
permalink: /howto/build/tools
---

# Installation Hardware

| Image | Tool |
| :---: | --- |
| Wera Hex Keys | Hex Key set.<br/>Used to tighten or loosen screws.|
| Generic Soldering Iron | Generic Soldering iron.<br/>Heat insert tip recommended.<br />Used to melt in brass heat inserts.|
| Sander paper | Sand paper.<br/>Sometimes dowel pins are too tight, used to grind them down a little.<br/> 200-400 grit|
