ZeroGDesign/docs/docs/pages/howto/build/mercury_one_1/Full_build.md

---
layout: default
title: Mercury One.1
nav_order: 4
has_toc: true
parent: How To
permalink: /howto/build/printer/mercury_eva
---

# Mercury One.1 Full Assembly
{: .no_toc }

Welcome to your first steps at assembling your Mercury One.1!

Skill required - medium
{: .label .label-red }

## Section One: Frame

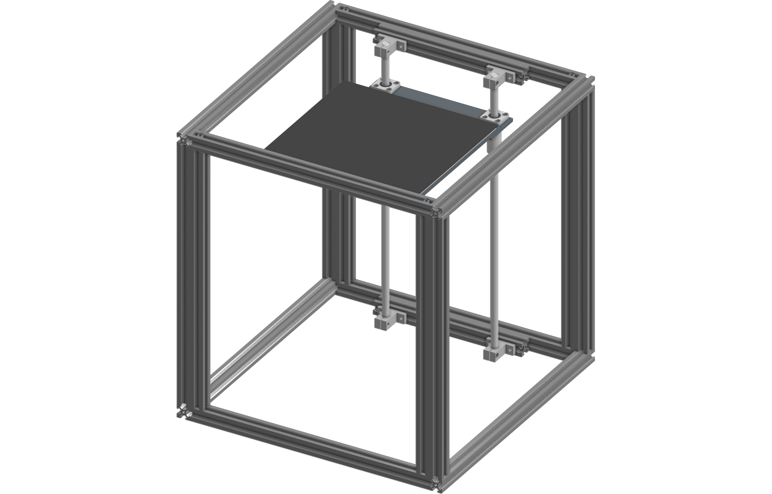
[picture p106: docs/assets/images/instructions/empty_frame.png]
Empty Ender 5 Frame


### Empty Frame

For the Mercury One.1 we want to start with the top motion system removed. We're not going into depth on how to remove the X and Y motion system.
If you're having trouble or you would like some help please don't hesitate and ask for help in our [Discord server](https://discord.com/invite/gzJP2s8){:target="_blank"}.

1. Table of content
{:toc}

# Section Two: Stepper mounts

## Left stepper mount
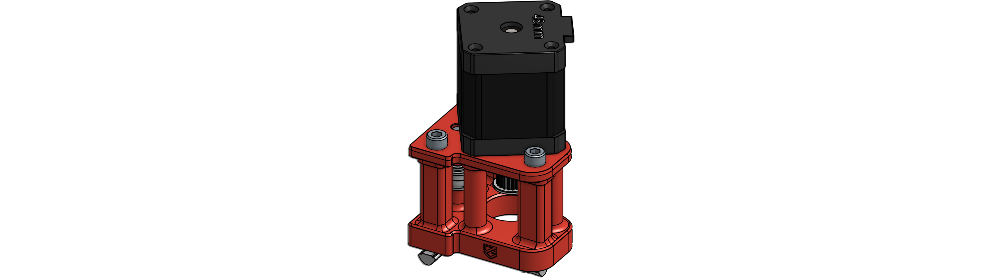
[picture p107: docs/assets/images/instructions/stepper_mounts_left.png]
Left Stepper mount


The hardware displayed below is for __ONE__ stepper mount. INPUT TEXT HERE FOR RIGHT STEPPER MOUNT.

### LS hardware

| :-------------------------: | :--------------------       | -------------------------------------------------------------------------------: |
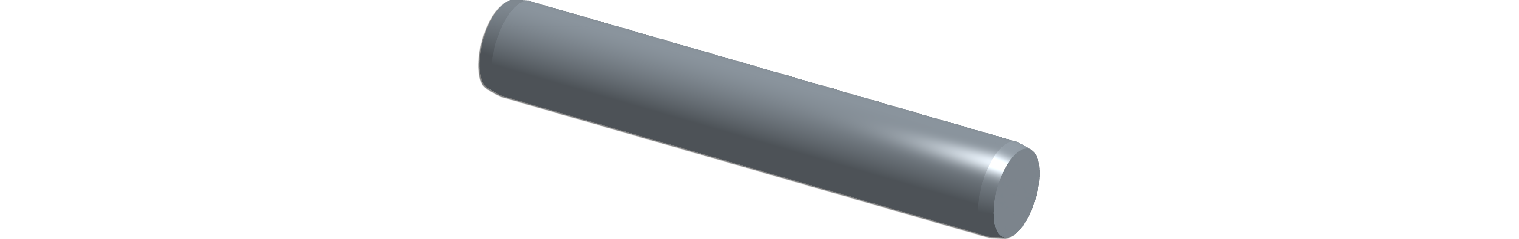
[picture p108: docs/assets/images/instructions/5x30_dowel_pin.png]
5MM 30mm dowel
| Type:<br>Amount: | 5x30 Precision Dowel pin<br>2          |      |
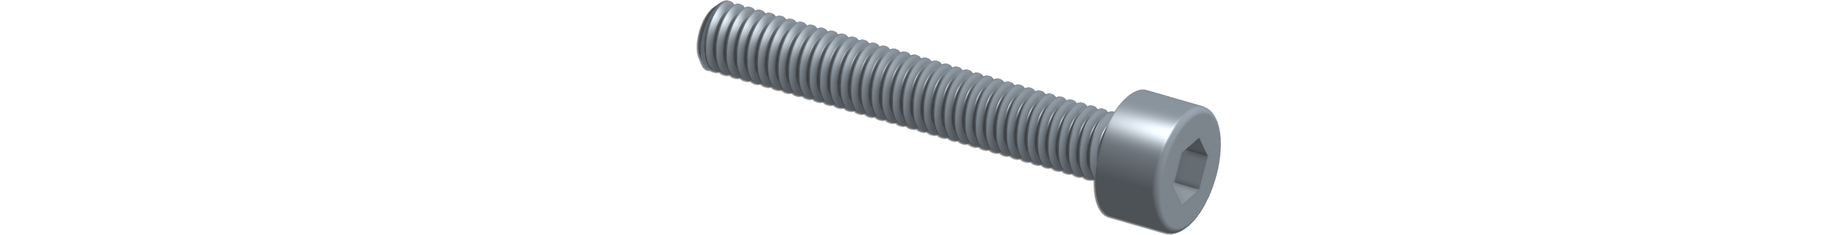
[picture p109: docs/assets/images/instructions/m3x20.png]
M3X20mm
| Type:<br>Amount: | M3X20mm<br>3                           |      |
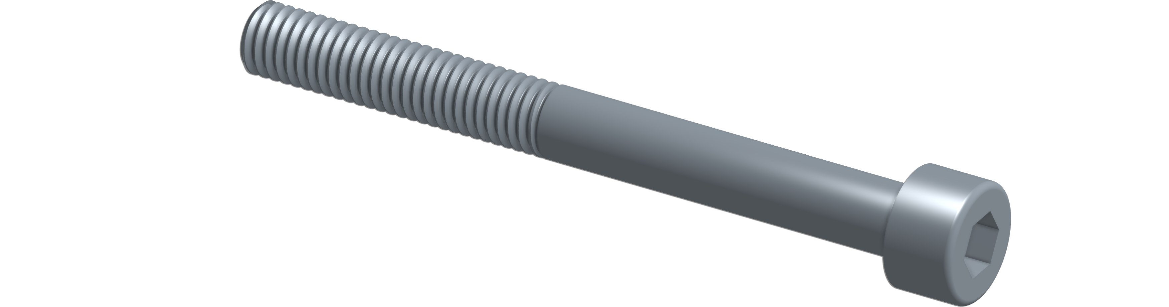
[picture p110: docs/assets/images/instructions/m5x50.png]
M5X50mm
| Type:<br>Amount: | M5X50mm<br>2                           |      |
| Type:<br>Amount: | [Flange stack](#flange-stack)<br>3     | Flange stack |
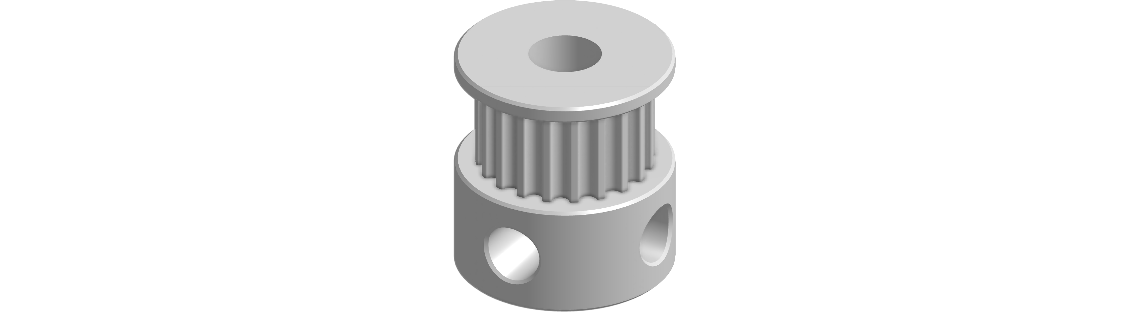
[picture p111: docs/assets/images/instructions/20t_pulley.png]
20T Pulley
| Type:<br>Amount: | 20Tooth Pulley<br>1          |      |
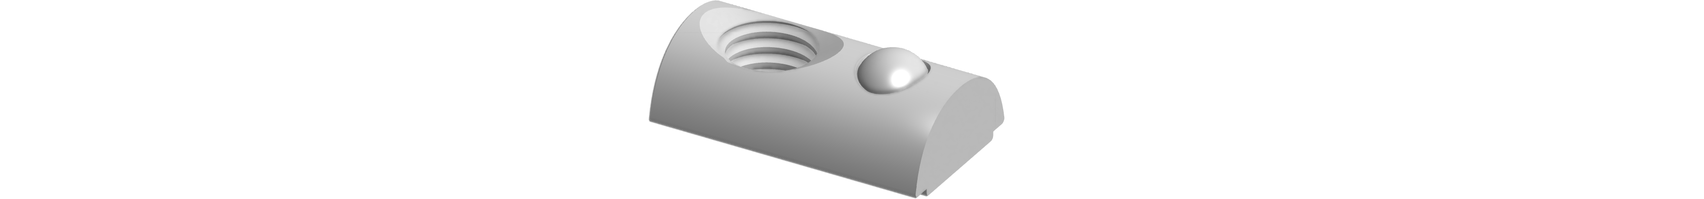
[picture p112: docs/assets/images/instructions/m5_rollin_tnut.png]
| Type:<br>Amount:<br>Note: | M5 T-Nut<br>2<br>Read more    |  |
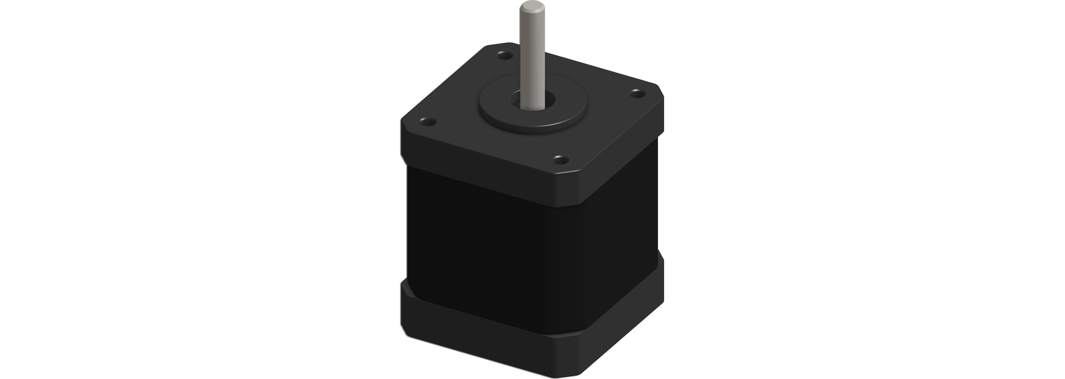
[picture p113: docs/assets/images/instructions/nema17.png]
Nema 17
| Type:<br>Amount: | Nema 17 Stepper Motor<br>1                            |  |
{: class="hardwaretable"}

### LS printed parts

| :-------------------------: | :--------------------       | -------------------------------------------------------------------------------: |
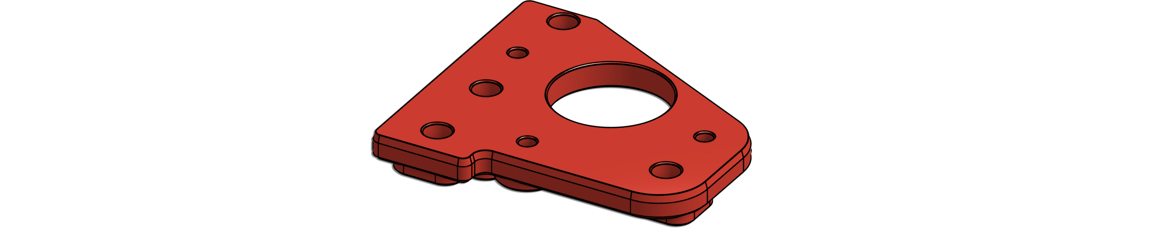
[picture p114: docs/assets/images/instructions/printer_stepper_left_top.png]
Left stepper top printed
| Type:<br>Amount: | Left stepper top<br>1        |      |
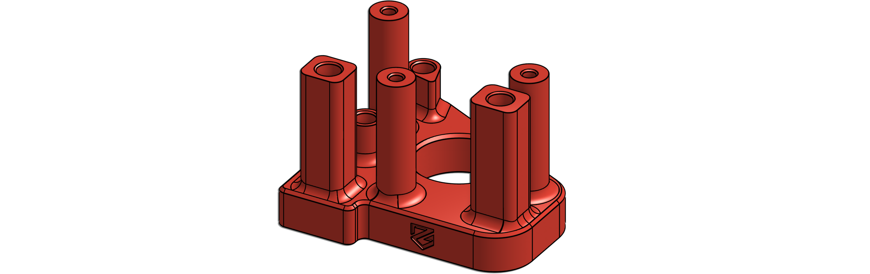
[picture p115: docs/assets/images/instructions/printed_stepper_left_bottom.png]
Left stepper bottom printed
| Type:<br>Amount: | Left stepper bottom<br>1     |      |
{: class="hardwaretable"}

We have very specific settings you should print the parts with, they've been designed around these settings. Read more about them.

## Sanding the dowel pins

Test fit your dowel pin in the F695-2RS 5\*13\*4 Mm bearing, if they're tight **DO NOT** continue. You want to sand them down a little. 

#### Why do I have to sand my dowel pins?

If they do fit nicely you do not need to sand them down. 

Forcing the dowel pins into the F695-2RS Bearings might cause one of the following issues:

1. The F695-2RS Bearing might crack and split.
2. The dowel pin will never come out again.

<details>
  <summary>Click to expand for instructions!</summary>
  
    Insert your pins into an electric drill and grab your sandpaper

    <dl>
        <dt>Sandpaper grit</dt>
        <dd>120 to 220</dd>
    </dl>

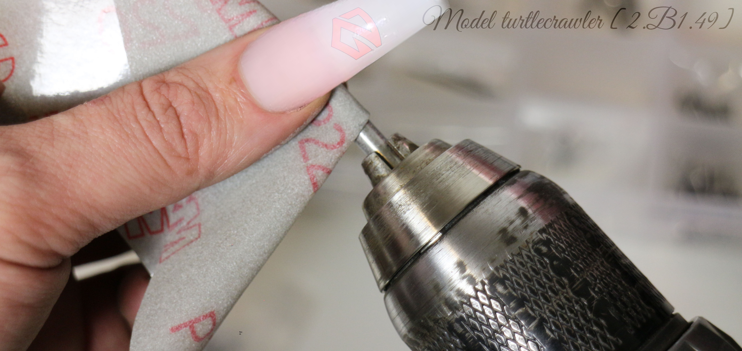
[picture p116: docs/assets/images/instructions/assembly/left_stepper/sanding.jpg]
how to sand
    ) |
</details>

## Left stepper mount assembly

### Inserting the T-nuts

Insert the two M5 T-Nuts into the frame. If you happen to have the T-Nuts without the springs you can skip this step and attach them to the M5x50mm bolts later.

You can slightly rotate the M5 T-nuts while pressing them into the frame. They will snap into place.

The placement of the T-nuts is not important, as long as the threaded holes are facing the right directions as shown on the image below.

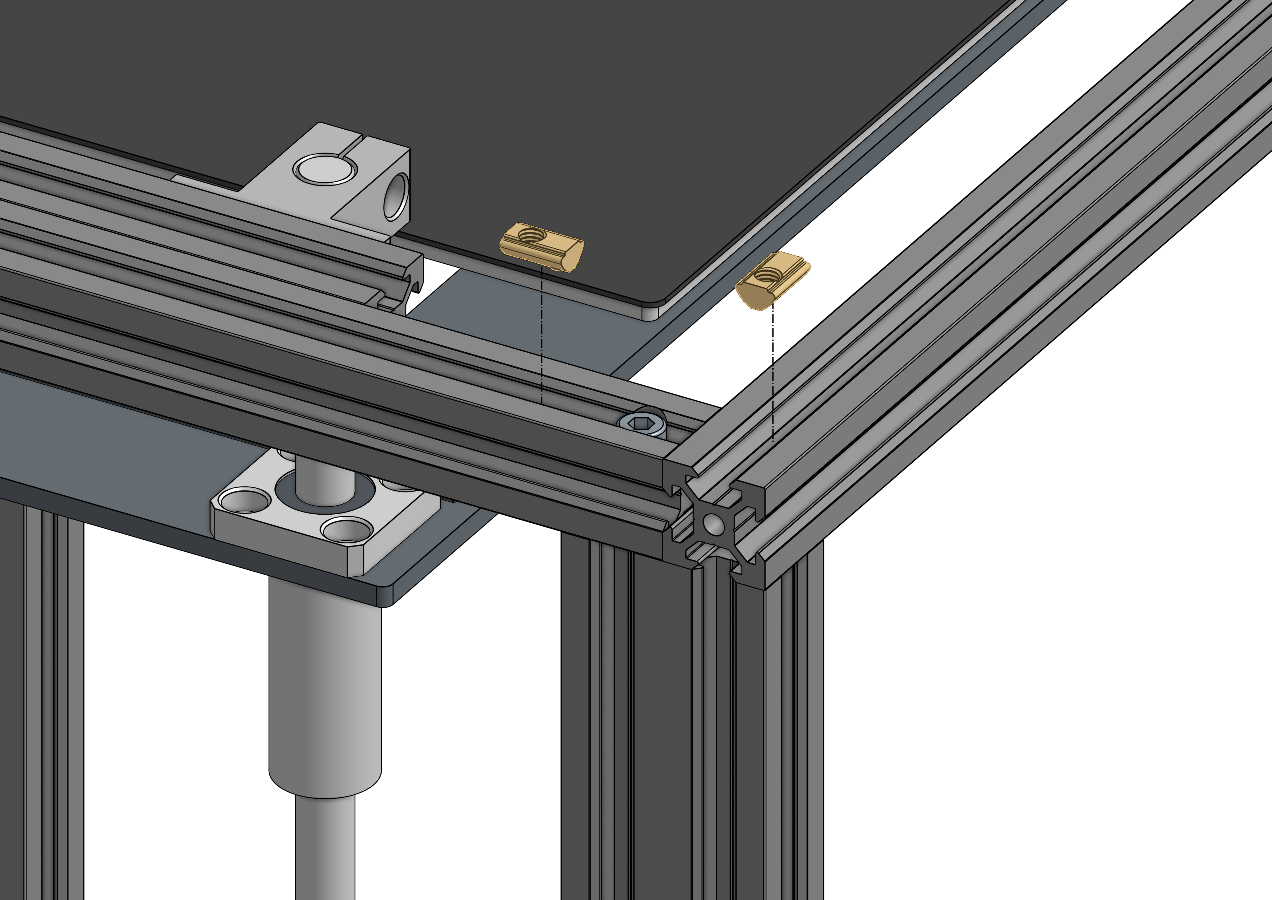
[picture p117: docs/assets/images/instructions/assembly/left_stepper/left_stepper_tnut_highlight.png]
Left stepper t-nut highlighted


The image below shows the correct placement of the T-nuts.

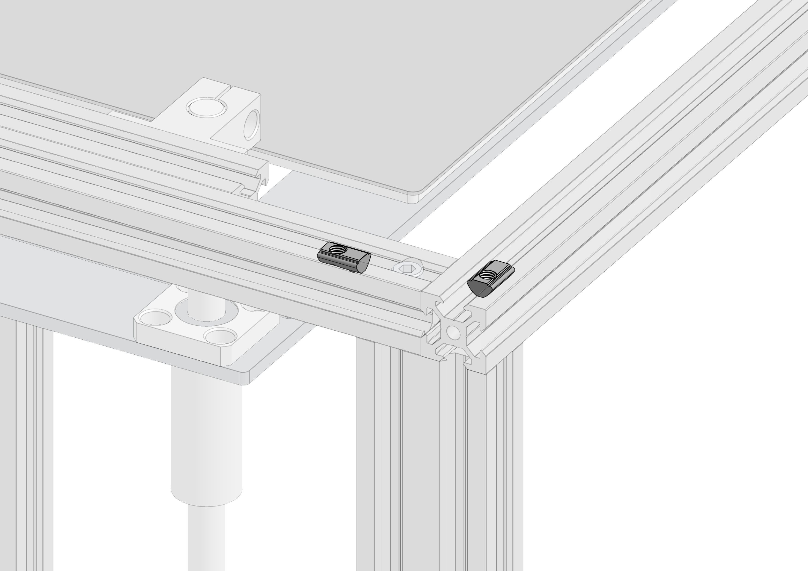
[picture p118: docs/assets/images/instructions/assembly/left_stepper/left_stepper_tnut_after.png]
Left stepper t-nut after insert


### Inserting dowel pins - LS

Take the bottom left stepper mount *printed part* and insert two 5x30 dowel pins as shown in the image below.

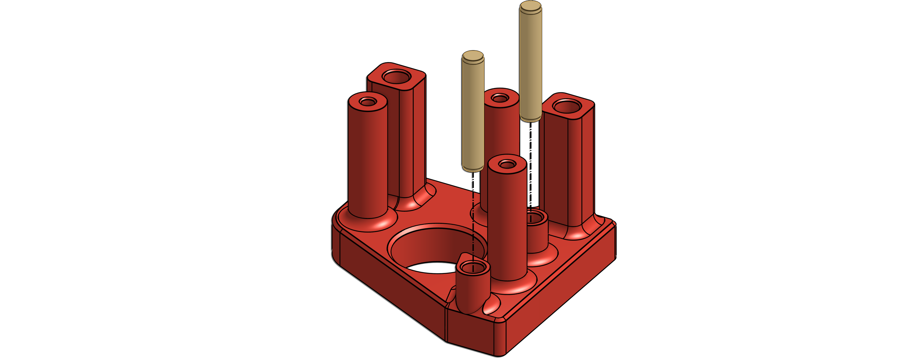
[picture p119: docs/assets/images/instructions/assembly/left_stepper/left_stepper_bottom_pins.png]
Left stepper bottom pins


The image below shows the correct placement of the dowel pins.

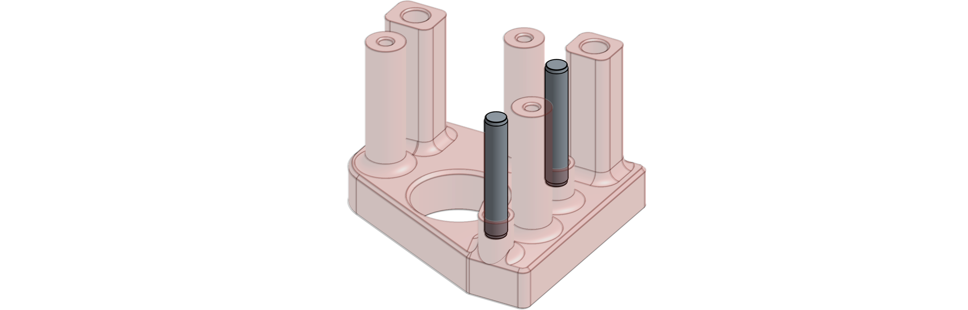
[picture p120: docs/assets/images/instructions/assembly/left_stepper/left_stepper_bottom_pins_after.png]
Left stepper bottom pins after


>>> ``On the bottom of the printed part you will find small M3 holes below the dowel pins. If your dowel pins are stuck you can use those to press them out using a small hex key.``

### Adding the flange stacks

It's time to add the [flange stack](#flange-stack)! Don't know what those are? [Click here](#flange-stack).

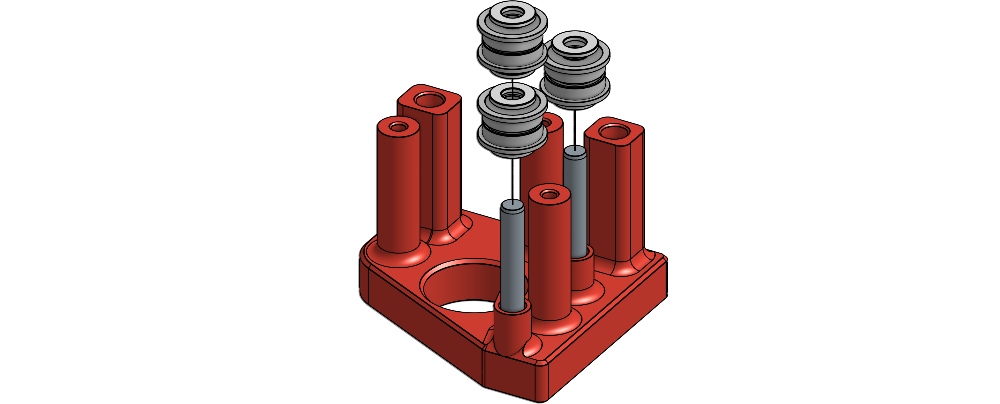
[picture p121: docs/assets/images/instructions/assembly/left_stepper/left_stepper_bottom_flange.png]
Left stepper bottom Flange stacks


The image below shows the correct placement of the [flange stack](#flange-stack).

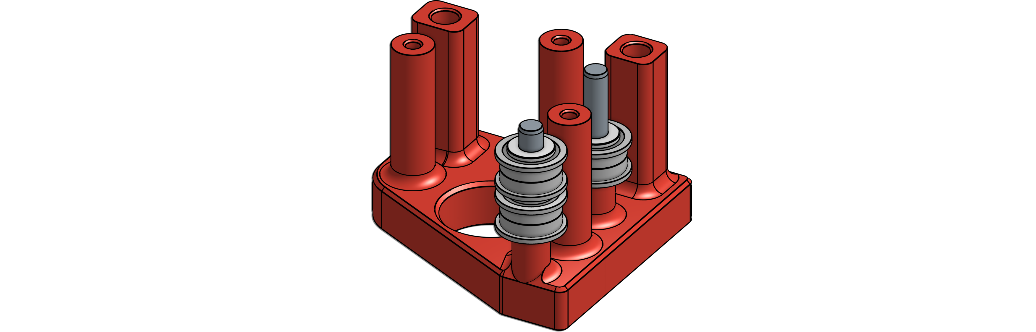
[picture p122: docs/assets/images/instructions/assembly/left_stepper/left_stepper_bottom_flange_after.png]
Left stepper bottom Flange stacks


When placing the double flange stacks, make sure you do not remove any shim rings, there will be two on top of each other as shown in the image below.

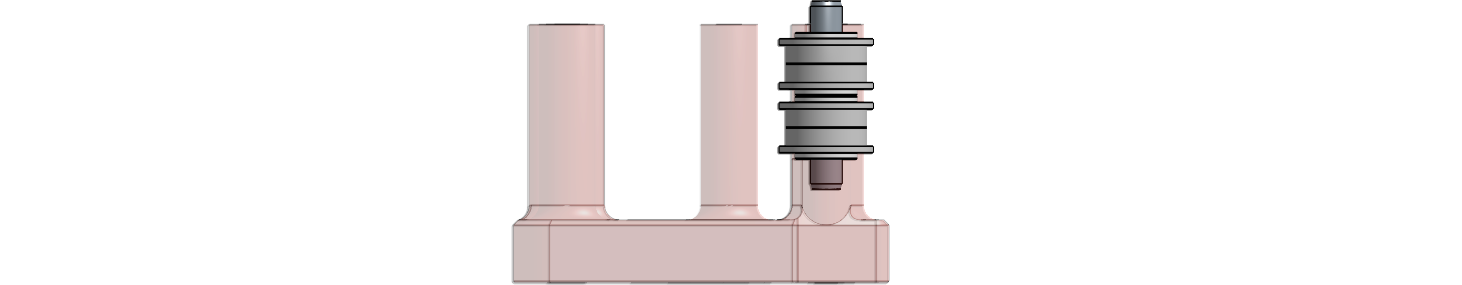
[picture p123: docs/assets/images/instructions/assembly/left_stepper/left_stepper_bottom_double_flange.png]
Left stepper bottom Flange stacks


### Lowering the top stepper mount

Take the top left motor mount *printed piece* and lower it into the bottom left motor mount.

| :-------------------------: | :--------------------       | -------------------------------------------------------------------------------: |
| Type: | Left stepper top        |     Left stepper top printed |
{: class="hardwaretable"}

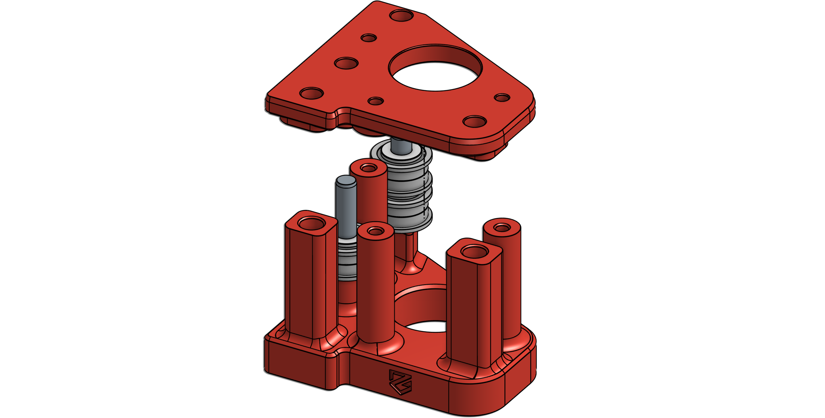
[picture p124: docs/assets/images/instructions/assembly/left_stepper/left_stepper_lower_top_print.png]
Left stepper top printed


The image below shows the top lowered on the bottom mount, top top will have an edge/guide where the bottom part will fit in.
There should be some play, this because it makes it easier to align.

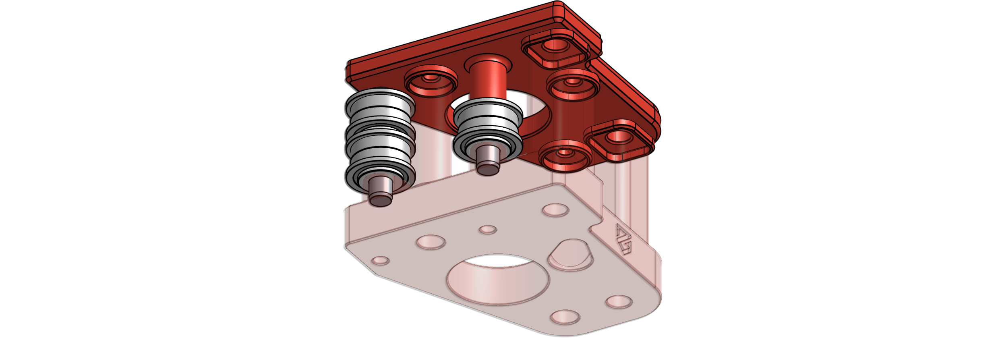
[picture p125: docs/assets/images/instructions/assembly/left_stepper/left_stepper_lower_top_print_after.png]
Left stepper top printed


# Definitions

## Flange stack

The following image represents a so called "flange stack".
It contains the following:

| :-------------------------: | :------------------------------------------------------------------------------- | |
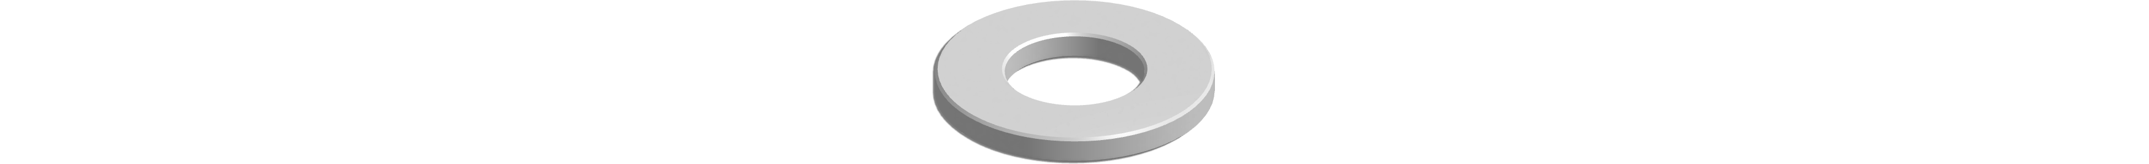
[picture p126: docs/assets/images/instructions/m5_10_1_shim.png]
| Type:<br>Amount: | 5x10x1 Shim ring<br>2       |      |
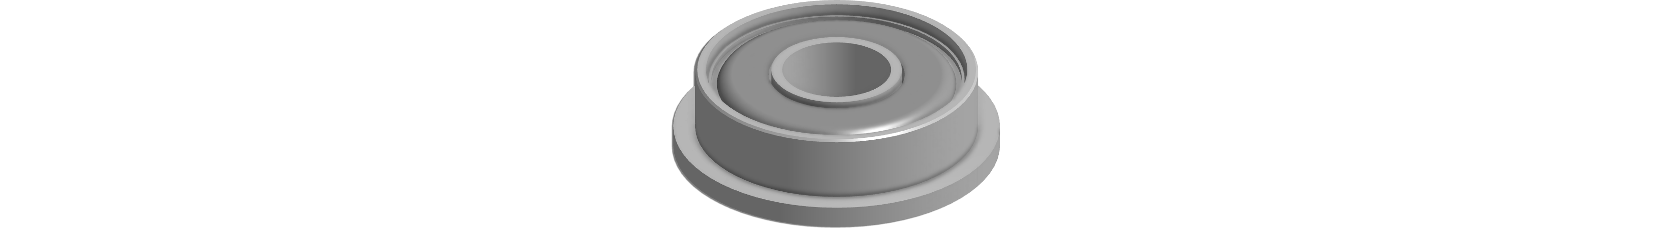
[picture p127: docs/assets/images/instructions/f695_flange_bearing.png]
| Type:<br>Amount: | F695-2RS 5\*13\*4 Mm<br>2       |      |
{: class="hardwaretable"}

1. Assemble the Flange Stack as per following image.

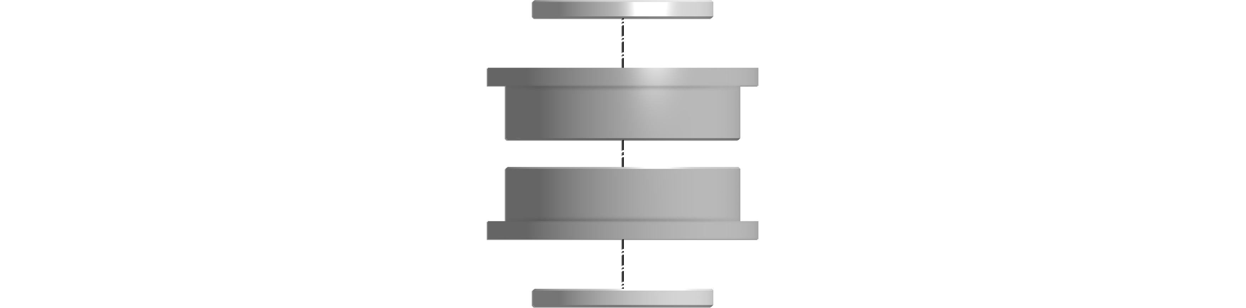
[picture p128: docs/assets/images/instructions/flange_stack_exploded.png]
Flange stack
