ZeroGDesign/docs/docs/pages/howto/build/Hydra/hydra.md

---
layout: default
title: Hydra
nav_order: 5
has_children: true
has_toc: true
parent: How To
permalink: /howto/build/printer/hydra
---

# ZeroG Hydra

No ETA! Hydra is in early development and available on our [Discord server](https://discord.com/invite/gzJP2s8).

WARNING
{: .label .label-red }
> Files might change and hardware might change.
