ZeroGDesign/docs/docs/pages/howto/build/mercury_one/merc1.md

---
layout: default
title: Mercury One (AB/SB)
nav_order: 3
has_children: true
has_toc: true
parent: How To
permalink: /howto/build/printer/mercury_absb
---

# Mercury One After/Stealth Burner
