ZeroGDesign/docs/docs/pages/howto/build/mercury_one/front_towers.md

---
layout: default
title: Front Tower Assembly
nav_order: 5
parent: Mercury One (AB/SB)
grand_parent: How To
permalink: /howto/build/printer/mercury_absb/front_towers
---

# M One (AB/SB) Front Tower Assembly
