ZeroGDesign/docs/docs/pages/howto/build/mercury_one/stepper_mounts.md

---
layout: default
title: Stepper Mounts
nav_order: 3
parent: Mercury One (AB/SB)
grand_parent: How To
permalink: /howto/build/printer/mercury_absb/stepper_mounts
---

# M One (AB/SB) Stepper Mount Assembly
