ZeroGDesign/docs/docs/pages/howto/build/mercury_one/x_joints.md

---
layout: default
title: X Joint Assembly
nav_order: 2
parent: Mercury One (AB/SB)
grand_parent: How To
permalink: /howto/build/printer/mercury_absb/x_joints
---

# M One (AB/SB) X Joint Assembly
