ZeroGDesign/docs/docs/pages/manual/build/mercury_one_1/empty_frame.md

---
layout: default
title: Empty Frame
nav_order: 40
has_toc: true
parent: Mercury One.1
grand_parent: Manual
permalink: /manual/build/mercury_eva/empty_frame
---

# Mercury One.1 - Empty Frame
{: .no_toc }

The first step of assembling your Mercury One.1 is all about disassembling.

1. Table of contents
{:toc}

# Section One: Frame

Empty Ender 5 Frame{: .lightbox_wrapper}

<div onclick="location.href='#section-one-frame';" id="lightbox__item_1"  class="lightbox__item" style="background-image: none;">
    <div class="lightbox__content">

        Birdseye overview
    </div>
</div>

## Empty Frame

For the Mercury One.1 EVA we want to start with the top motion system removed.

So your first step is removing the X and Y motion system.

{: .warn }
We're not going into depth on how to remove the X and Y motion system.
If you're having trouble or you would like some help please don't hesitate and ask for help in our [Discord server](https://discord.gg/zerog){:target="_blank"}.

{: style="text-align: center" .fs-8}
[Next step &rarr;](/manual/build/mercury_eva/build_instruction){: .btn .btn-red }
