ZeroGDesign/docs/docs/pages/manual/build/Electronics_enclosure/manual_overview.md

---
layout: default
title: Electronics Enclosure
nav_order: 1
has_children: true
has_toc: true
parent: Manual
permalink: /manual/build/electronics_enclosure
---

# Electronics enclosure table of content
{: .no_toc }

1. Table of content
{:toc}

{: style="text-align: center" .fs-8}
[Step One &rarr;](/manual/build/hydra/introduction){: .btn .btn-red }
