ZeroGDesign/docs/docs/pages/manual/build/Hydra/bed_drawings.md

---
layout: default
title: 4. Heated bed drawing
nav_order: 40
has_toc: false
parent: Hydra
grand_parent: Manual
permalink: /manual/build/hydra/heated_bed_drawing
---

# 4. Heated bed drawings
{: .no_toc }

Click the drawing to enlarge the image, this works best on a desktop monitor.
{: .fs-6 .fw-300 }

1. Table of content
{:toc}

## Heated bed drawing

You'll find 3 images, all 3 images contain different bed dimensions. The holes are relative to the corners and edges.

Something you wont find on these drawings is the thickness of the bed.
For thermal stability and proper bolt engagement we recommend a bed thickness anywhere from **8 to 10mm**.

### Ender 5 (Pro)

#### 255x255 Bed

##### Drawing

*<i class="bi bi-zoom-in"></i> Hover drawing and click image to enlarge*

Download: [255x255.dxf](../../../assets/dxf/hydra/255x255.dxf)

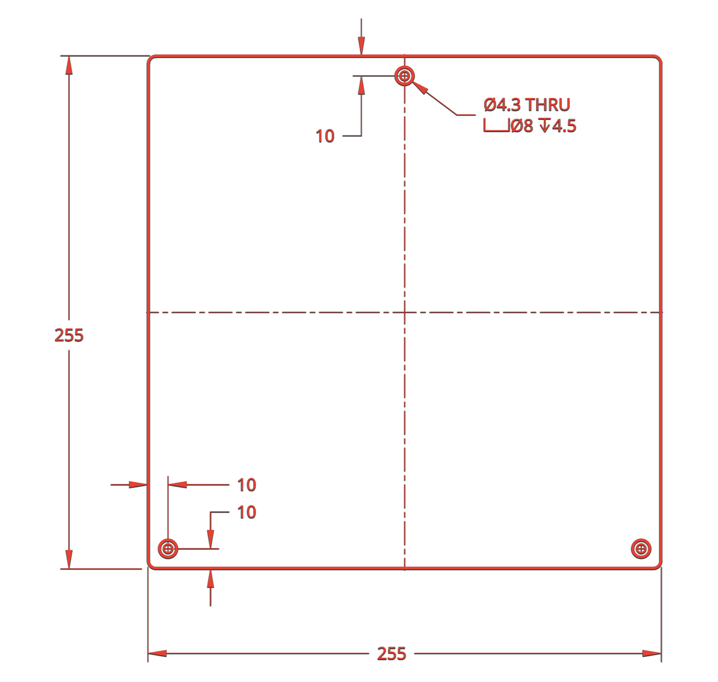
[picture p130: docs/assets/images/instructions/hydra/bed_drawing_255.png]
255x255 bed drawing
{: .lightbox_wrapper}

<div onclick="location.href='##';"  id="lightbox__item_1"  class="lightbox__item">
    <div class="lightbox__content">

        Left stepper top printed
    </div>
</div>

#### 275x275 Bed

Planning to use a [275x275 Bed](#275x275-bed) on the Mercury 1.1? **Must read** information for you.

1. A 275x275 bed requires 330mm rails on X and Y.
2. The Eva setup will cause you to *lose* a little travel *(3 to 8mm depending on installation)* on Y.

##### Drawing

*<i class="bi bi-zoom-in"></i> Hover drawing and click image to enlarge*
   
Download: [275x275.dxf](../../../assets/dxf/hydra/275x275.dxf)

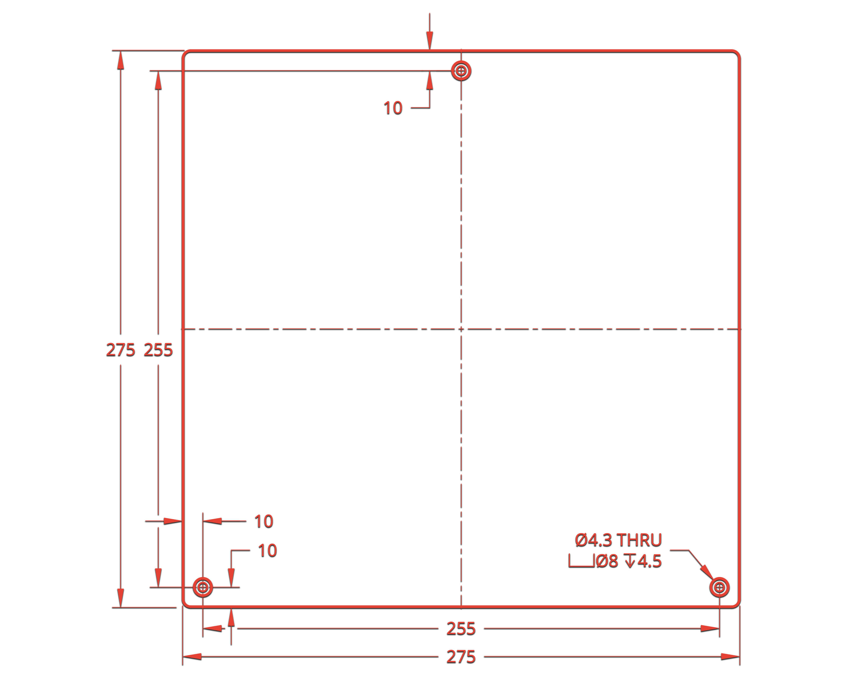
[picture p131: docs/assets/images/instructions/hydra/bed_drawing_275.png]
275x275 bed drawing
{: .lightbox_wrapper}

<div onclick="location.href='##';"  id="lightbox__item_2"  class="lightbox__item">
    <div class="lightbox__content">

        Left stepper top printed
    </div>
</div>

### Ender 5 plus

#### 377x370 Bed

##### Drawing

*<i class="bi bi-zoom-in"></i> Hover drawing and click image to enlarge*

Download: [377x370.dxf](../../../assets/dxf/hydra/377x370.dxf)
   
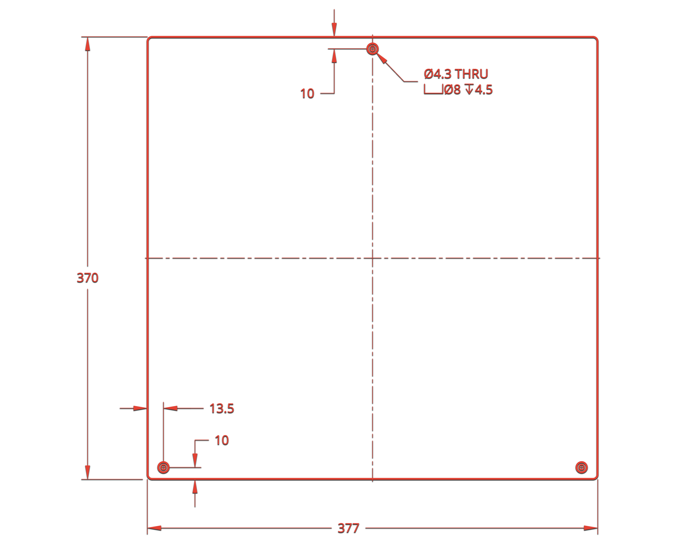
[picture p132: docs/assets/images/instructions/hydra/bed_drawing_377.png]
377x370 bed drawing
{: .lightbox_wrapper}

<div onclick="location.href='##';"  id="lightbox__item_3"  class="lightbox__item">
    <div class="lightbox__content">

        Left stepper top printed
    </div>
</div>

### Ender 5 plus

#### 410x410 Bed

##### Drawing

*<i class="bi bi-zoom-in"></i> Hover drawing and click image to enlarge*

Download: [410x410.dxf](../../../assets/dxf/hydra/410x410.dxf)

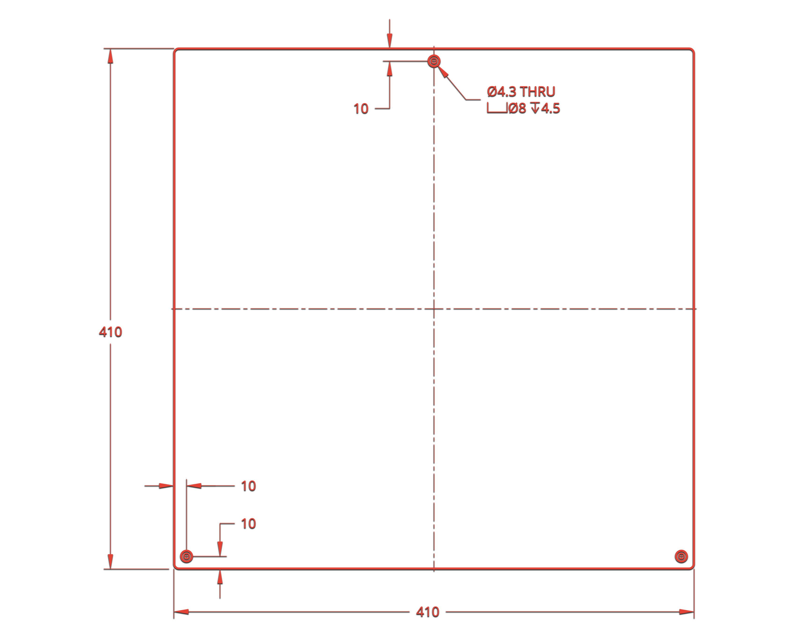
[picture p133: docs/assets/images/instructions/hydra/bed_drawing_410.png]
410x410 bed drawing
{: .lightbox_wrapper}

<div onclick="location.href='##';"  id="lightbox__item_4"  class="lightbox__item">
    <div class="lightbox__content">

        Left stepper top printed
    </div>
</div>

{: style="text-align: center" .fs-8}
[Next step &rarr;](/manual/build/hydra/left_arm){: .btn .btn-red }
