ZeroGDesign/docs/docs/pages/manual/build/Hydra/introduction.md

---
layout: default
title: 1. Introduction
nav_order: 0
has_toc: false
parent: Hydra
grand_parent: Manual
permalink: /manual/build/hydra/introduction
---

# 1. Introduction
{: .no_toc }

Building the Hydra
{: .fs-6 .fw-300 }

<dl>
  <dt>Difficulty</dt>
  <dd><span style="color:#d6c01a">Moderate to experienced</span></dd>
  <dt>Language</dt>
  <dd>English</dd>
</dl>

## Higher resolution image

Hovering an image with your mouse will show a zoom icon <i class="bi bi-zoom-in"></i> after opening the image you can either click 'CLOSE' or anywhere on the screen to close the pop-up.

## Tools required

| :-------------------------: | :--------------------       | -------------------------------------------------------------------------------: |
| Tool<br/>Description| Soldering iron<br/>Used for heat set inserts |     soldering iron{: .lightbox_wrapper} |
| Tool<br/>Description<br/>Sizes| Hex Keys<br/>Used to tighten and losen bolts<br/>2mm, 2.5mm, 3mm, 4mm|     soldering iron{: .lightbox_wrapper} |
{: class="hardwaretable"}

<div onclick="location.href='##';"  id="lightbox__item_1"  class="lightbox__item">
    <div class="lightbox__content">

        Soldering iron
    </div>
</div>

<div onclick="location.href='##';"  id="lightbox__item_2"  class="lightbox__item">
    <div class="lightbox__content">

        Hex keys
    </div>
</div>

<div onclick="location.href='##';"  id="lightbox__item_3"  class="lightbox__item">
    <div class="lightbox__content">

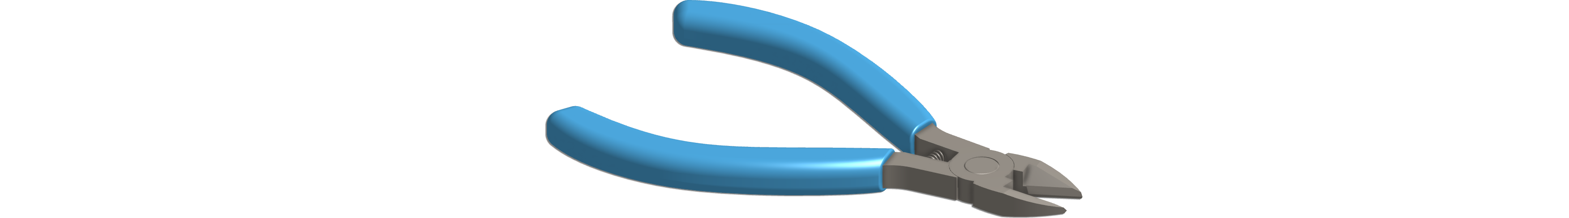
[picture p134: docs/assets/images/tools/flush_cutters.png]
Flush cutter
        
    </div>
</div>

<div onclick="location.href='##';"  id="lightbox__item_4"  class="lightbox__item">
    <div class="lightbox__content">

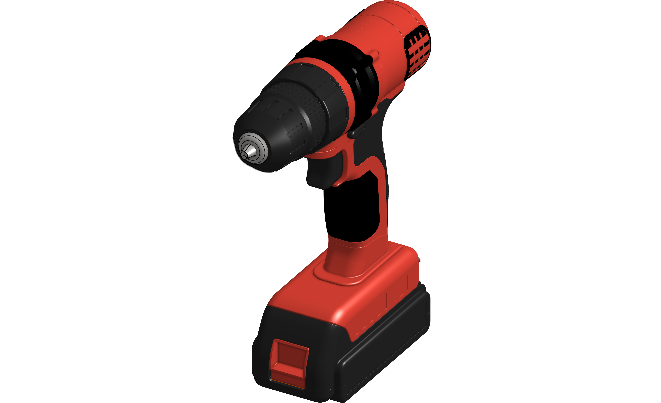
[picture p135: docs/assets/images/tools/drill.png]
Corless drill
        
    </div>
</div>

<div onclick="location.href='##';"  id="lightbox__item_5"  class="lightbox__item">
    <div class="lightbox__content">

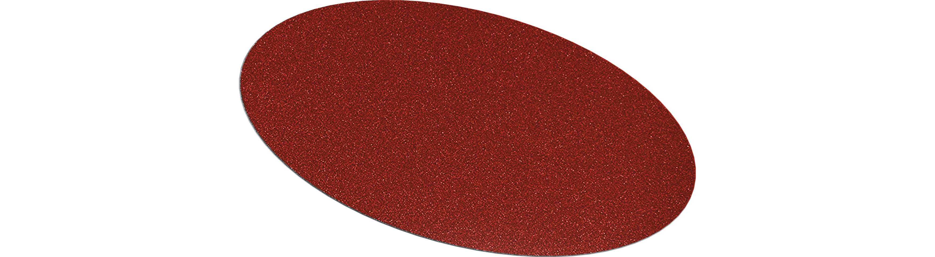
[picture p136: docs/assets/images/tools/sandpaper.png]
Sand paper
        
    </div>
</div>

## Do's and don'ts

1. **Read and execute the instructions.**
2. **Got questions?**
   1. Join our [Discord server <i class="bi bi-discord"></i>](https://discord.gg/zerog){:target="_blank"}.
3. **Don't just look at images.**
   1. An image doesn't explain the full story.
   2. There is text that will explain every step, read it carefully.
4. **Don't skip instructions.**
   1. Unless we tell you to.
5. **Don't use force, you shouldn't have too.**
   1. Make sure to not use a unreasonable amount of force.
   2. Plastic does break and flange bearings crack, would be a waste wouldn't it?

## Need more help?

Lost? Need help? Not sure? Join our [Discord server <i class="bi bi-discord"></i>](https://discord.gg/zerog){:target="_blank"}, we've got a big community ready to help you out

## Screenshots

Side view
{: .fs-3 .fw-300 }

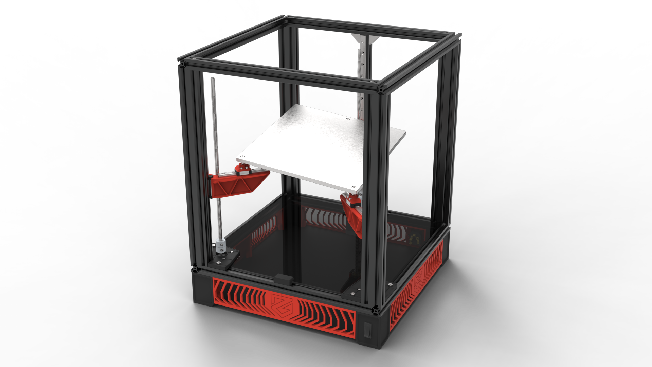
[picture p137: docs/assets/images/renders/hydra_bird.png]
Side overview
{: .lightbox_wrapper}

<div onclick="location.href='##';"  id="lightbox__item_6"  class="lightbox__item">
    <div class="lightbox__content">

        Side overview
    </div>
</div>

Front view
{: .fs-3 .fw-300 }

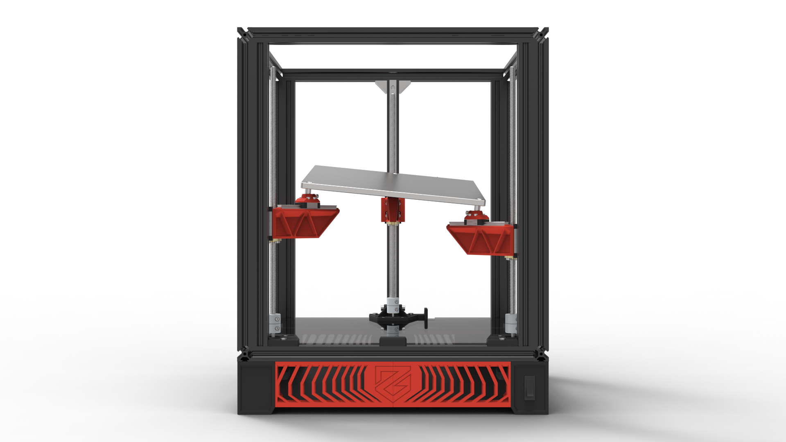
[picture p138: docs/assets/images/renders/hydra_front.png]
hydra_front
{: .lightbox_wrapper}

<div onclick="location.href='##';"  id="lightbox__item_7"  class="lightbox__item">
    <div class="lightbox__content">

        hydra_front
    </div>
</div>

Back view
{: .fs-3 .fw-300 }

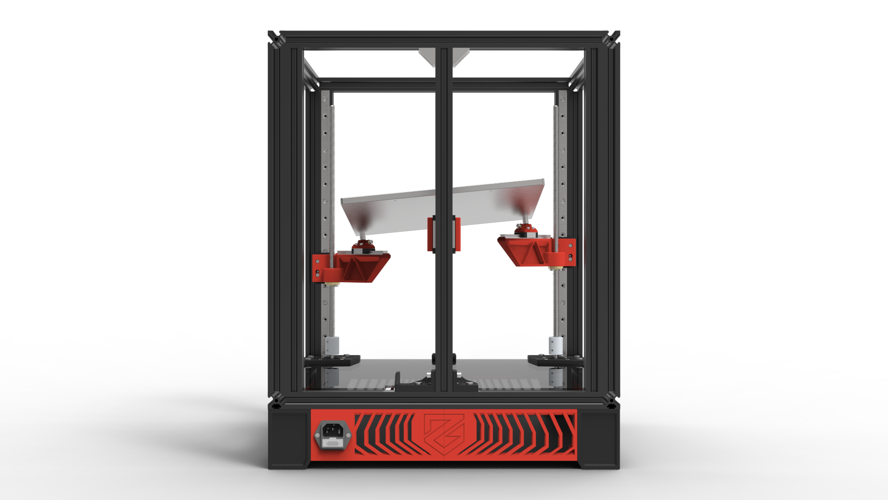
[picture p139: docs/assets/images/renders/hydra_back.png]
hydra_back
{: .lightbox_wrapper}

<div onclick="location.href='##';"  id="lightbox__item_8"  class="lightbox__item">
    <div class="lightbox__content">

        hydra_back
    </div>
</div>

Top view
{: .fs-3 .fw-300 }

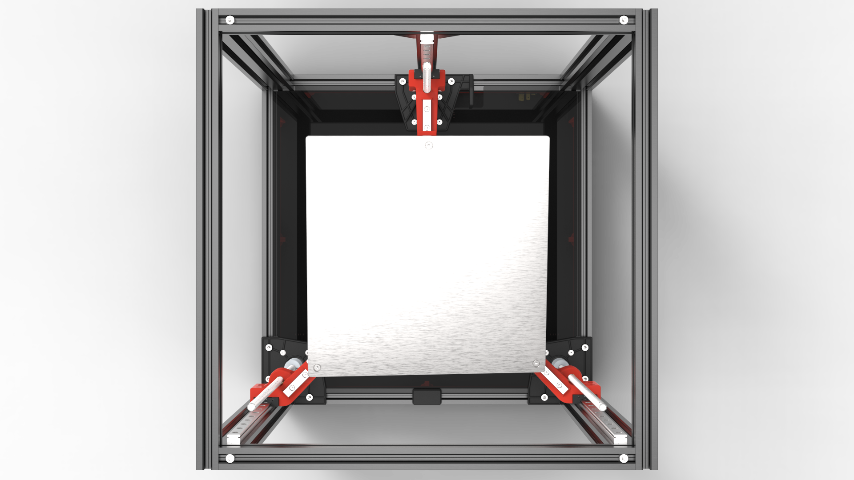
[picture p140: docs/assets/images/renders/hydra_top.png]
hydra_top
{: .lightbox_wrapper}

<div onclick="location.href='##';"  id="lightbox__item_9"  class="lightbox__item">
    <div class="lightbox__content">

        hydra_top
    </div>
</div>

Bare Hydra components
{: .fs-3 .fw-300 }

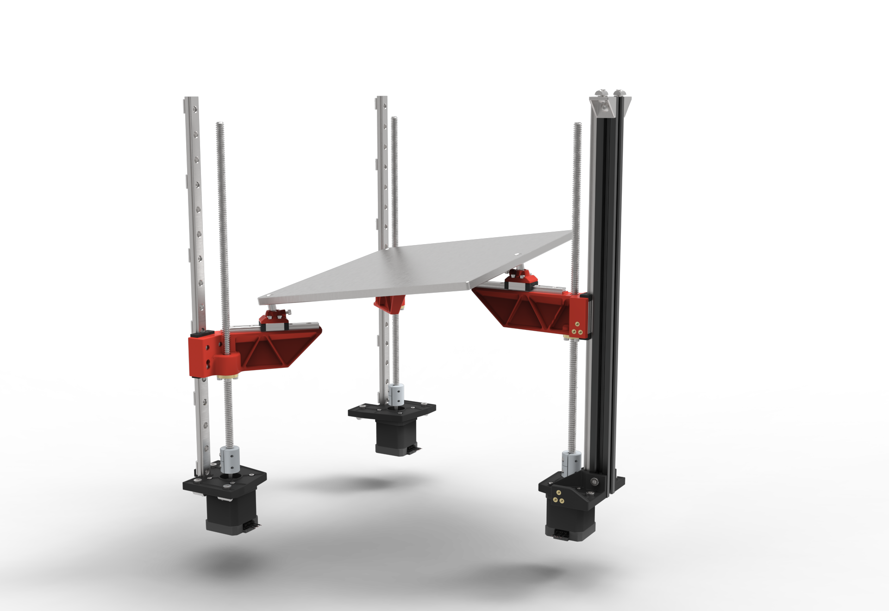
[picture p141: docs/assets/images/renders/hydra_bare.png]
hydra_bare
{: .lightbox_wrapper}

<div onclick="location.href='##';"  id="lightbox__item_10"  class="lightbox__item">
    <div class="lightbox__content">

        hydra_bare
    </div>
</div>

{: style="text-align: center" .fs-8 }
[Next step <i class="bi bi-arrow-return-right"></i>](/manual/build/hydra/bill_of_material){: .btn .btn-red }
