ZeroGDesign/docs/docs/pages/manual/build/Hydra/right_arm.md

---
layout: default
title: 7. Right arm
nav_order: 70
has_toc: true
parent: Hydra
grand_parent: Manual
permalink: /manual/build/hydra/right_arm
---

# 7. Assembling right arm
{: .no_toc }

1. Table of content
{:toc}

## Bed supporting arm

### Right arm

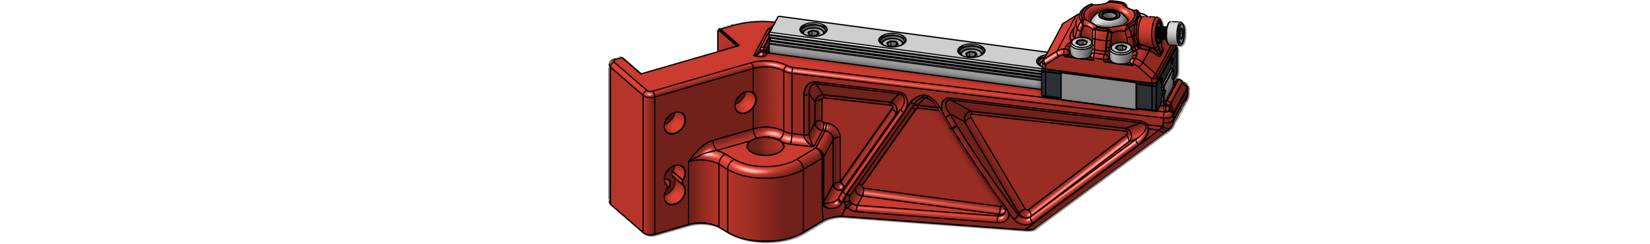
[picture p160: docs/assets/images/instructions/hydra/right_arm/right_arm_complete.png]
Right arm
{: .lightbox_wrapper}

<div onclick="location.href='##';"  id="lightbox__item_1"  class="lightbox__item">
    <div class="lightbox__content">

        Right arm full overview
    </div>
</div>

The hardware displayed below is for the right arm assembly.

#### Hardware

| :-------------------------: | :--------------------       | -------------------------------------------------------------------------------: |
| Type:<br/>Amount: | m3x8mm<br/>9                            |     m3x8 |
| Type:<br/>Amount: | m3x10mm<br/>1                            |     m3x10 |
| Type:<br/>Amount: | Heatset insert<br/>10                           |     heatset insert |
| Type:<br/>Amount: | 10mm Kossel ball<br/>1                           |     10mm Kossel ball |
| Type:<br/>Amount: | 12x5x4 countersunk magnet<br/>1     | 12x5x4 countersunk magnet |
| Type:<br/>Amount: | MGN9C Rail<br/>1                    |     MGN9C rail |
{: class="hardwaretable"}

#### Printed part

| :-------------------------: | :--------------------       | -------------------------------------------------------------------------------: |
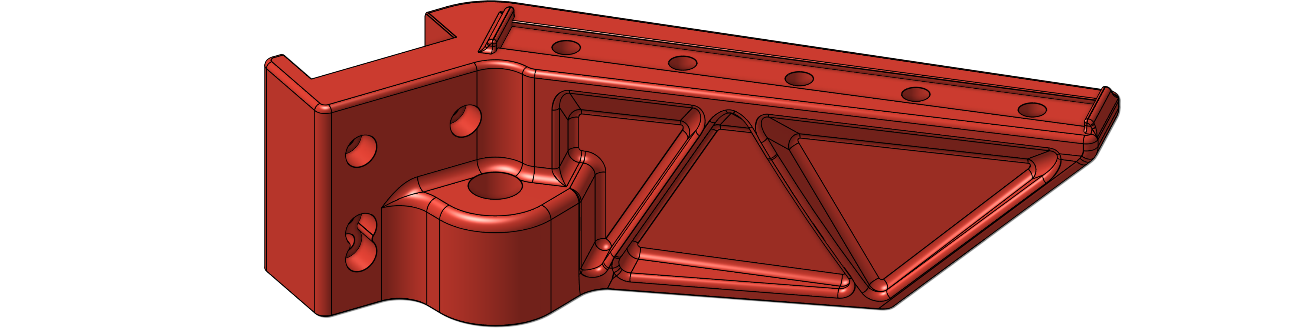
[picture p161: docs/assets/images/instructions/hydra/right_front_arm.png]
Right front arm
| File name<br/>Description<br/>Download | right_arm.stl<br/>Front right support arm for print bed<br/>[Here](/manual/build/hydra/printed_files#bed-supporting-arms)|     {: .lightbox_wrapper} 
| File name<br/>Description<br/>Amount<br/>Download | MGN9C_12x*#*Mag.stl<br/>Connects the bed to the rail carriage<br/>1<br/>[Here](/manual/build/hydra/printed_files#mini-tank)| Smoll tank{: .lightbox_wrapper} |
{: class="hardwaretable"}

<div onclick="location.href='##';"  id="lightbox__item_2"  class="lightbox__item">
    <div class="lightbox__content">

        Right front arm
    </div>
</div>

<div onclick="location.href='##';"  id="lightbox__item_3"  class="lightbox__item">
    <div class="lightbox__content">

        Right front arm
    </div>
</div>

We have very specific [settings](../../../standard/print/settings){:target="_blank"} you should print the parts with, they've been designed around these settings.

## Right arm assembly

### Inserting the heat inserts

Printed part required:

| :-------------------------: | :--------------------       | -------------------------------------------------------------------------------: |
| Filename : | right_arm.stl        |     Right front arm{: .lightbox_wrapper} |
{: class="hardwaretable"}

Hardware required:

| :-------------------------: | :------------------------------------------------------------------------------- | |
| Type:<br/>Amount: | Heatset insert<br/>9       |     heatset insert |
{: class="hardwaretable"}

#### Inserting heat inserts for bottom

Stand your Right arm down on the top surface.

We're starting our work with the bottom. If possible, clamp it between something, This way, it doesn't move...

{: .warn}
**Don't burn yourself!** We're going to work with a soldering iron, be careful. Heatsets inserts are still hot after melting them into the plastic, don't touch them!

If you do not know how to insert heatset inserts into printed parts, please watch the video by [EDGE OF 3D](https://www.youtube.com/embed/WtDyX8yIzC0){:target="_blank"}.

Place the small end of the heatset inserts into the hole. You can start with one heatset so they don't fall out when you insert the other once. Heatup the soldering iron to about 250&#8451;, you do not want to burn the plastic, you want to let the heatset melt into the plastic. These will be used to mount the leadscrew nut to the arm in a later step.

Insert heatset in bottom{: .lightbox_wrapper}

> ``Not sure if the heatset is in straight? Grab a longer M3 screw, and partially thread it in right after melting it in, this way you can turn it straight.``

<div onclick="location.href='##';"  id="lightbox__item_4"  class="lightbox__item">
    <div class="lightbox__content">

        Insert heatset in bottom
    </div>
</div>

#### Inserting heat inserts for top

Stand your Right arm down the bottom surface.

Place the small end of the heatset inserts into the holes. And start melting them in as shown in the image below. These will be used to attach the MGN9C rail in a later step.

Insert heatset in bottom{: .lightbox_wrapper}

<div onclick="location.href='##';"  id="lightbox__item_5"  class="lightbox__item">
    <div class="lightbox__content">

        Insert heatset in top
    </div>
</div>

### Installing MGN9 rail

Hardware required:

| :-------------------------: | :------------------------------------------------------------------------------- | |
| Type:<br/>Amount: | MGN9C 100mm<br/>1       |     MGN9C |
| Type:<br/>Amount: | M3X8mm bolt<br/>5       |     m3x8mm |
{: class="hardwaretable"}

Grab the right arm and align the MGN9C rail into the top as shown in the image below.

Right arm align rail{: .lightbox_wrapper}

<div onclick="location.href='##';"  id="lightbox__item_6"  class="lightbox__item">
    <div class="lightbox__content">

        Right arm align
    </div>
</div>

Lower the rail into the slot, there are two tabs that'll keep the MGN9C carriage from riding off the rail. The front tab is shown in the image below.

Right arm align rail{: .lightbox_wrapper}

<div onclick="location.href='##';"  id="lightbox__item_7"  class="lightbox__item">
    <div class="lightbox__content">

        Right arm align
    </div>
</div>

#### Inserting screws into MGN9C rail

Move the carriage to the back, and thread the first 3 M3x8mm screws into the heatset inserts using a 2.5mm hex driver.

Right arm align rail{: .lightbox_wrapper}

<div onclick="location.href='##';"  id="lightbox__item_8"  class="lightbox__item">
    <div class="lightbox__content">

        Right arm align
    </div>
</div>

Now move the carriage to the front and thread the last 2 M3X8mm screws into the heatset.

Right arm align rail{: .lightbox_wrapper}

<div onclick="location.href='##';"  id="lightbox__item_9"  class="lightbox__item">
    <div class="lightbox__content">

        Right arm align
    </div>
</div>

### Mini tank!

Printed part required:

| :-------------------------: | :--------------------       | -------------------------------------------------------------------------------: |
| Filename : | mini_tank.stl        |     mink tank{: .lightbox_wrapper} |
{: class="hardwaretable"}

Hardware required:

| :-------------------------: | :------------------------------------------------------------------------------- | |
| Type:<br/>Amount: | Heatset insert<br/>1       |     heatset insert |
{: class="hardwaretable"}

#### Inserting the heatset insert

We start by melting the heatset insert in into the so called 'barrel', this is the hole in the front as shown in the image below.

Right arm{: .lightbox_wrapper}

<div onclick="location.href='##';"  id="lightbox__item_10"  class="lightbox__item">
    <div class="lightbox__content">

        Right arm full overview
    </div>
</div>

### Installing Mini tank on carriage

Hardware required:

| Type:<br/>Amount: | m3x8mm<br/>9                            |     m3x8 |
| Type:<br/>Amount: | Heatset insert<br/>10                           |     heatset insert |
| Type:<br/>Amount: | 10mm Kossel ball<br/>1                           |     10mm Kossel ball |
| Type:<br/>Amount: | 12x5x4 countersunk magnet<br/>1     | 12x5x4 countersunk magnet |
{: class="hardwaretable"}

We've been working on the right arm and mini tank. It's time to install the Mini tank onto the carriage. Grab the right arm and mini tank you've prepared in the steps above.

#### Installing magnet assembly

Grab the right arm and lower the magnet into the middel of the MGN9C carriage as shown below.

Right arm{: .lightbox_wrapper}

<div onclick="location.href='##';"  id="lightbox__item_11"  class="lightbox__item">
    <div class="lightbox__content">

        Right arm full overview
    </div>
</div>

Now take the 10mm Kossel ball and center it on the countersunk magnet, note that the threads + hole should face the top.

Right arm{: .lightbox_wrapper}

<div onclick="location.href='##';"  id="lightbox__item_12"  class="lightbox__item">
    <div class="lightbox__content">

        Right arm full overview
    </div>
</div>

Take the Mini tank you've prepared, and lower it onto the magnet + Kossel ball.

Right arm{: .lightbox_wrapper}

<div onclick="location.href='##';"  id="lightbox__item_13"  class="lightbox__item">
    <div class="lightbox__content">

        Right arm full overview
    </div>
</div>

Your assembly should look something like this:

Right arm{: .lightbox_wrapper}

<div onclick="location.href='##';"  id="lightbox__item_14"  class="lightbox__item">
    <div class="lightbox__content">

        Right arm full overview
    </div>
</div>

#### Inserting the screws

Install all 4 M3x8mm screws into the top of the Mini tank and thread them into the MGN9C carriage as shown below.

Right arm{: .lightbox_wrapper}

<div onclick="location.href='##';"  id="lightbox__item_15"  class="lightbox__item">
    <div class="lightbox__content">

        Right arm full overview
    </div>
</div>

#### Installing locking system

{: .note}
This system is used to prevent the kossel ball from spinning when installing and uninstalling the bed. A **light snug fit** should be more than enough.

Hardware required:

| Type:<br/>Amount: | m3x10mm<br/>1                            |     m3x10 |
{: class="hardwaretable"}

{: .warn}
When you've installed everything, you need to make sure the M3x10mm bolts are lose. Locking them into place will stop your Z-system from trimming correctly and might actually damage parts.

Grab the assembly and your M3x10mm screw and lightly thread it into the barrel as shown below. **Light fit is enough!**

Right arm{: .lightbox_wrapper}

<div onclick="location.href='##';"  id="lightbox__item_16"  class="lightbox__item">
    <div class="lightbox__content">

        Right arm full overview
    </div>
</div>

The following image shows you how it will lock the kossel ball into place.

Right arm{: .lightbox_wrapper}

<div onclick="location.href='##';"  id="lightbox__item_17"  class="lightbox__item">
    <div class="lightbox__content">

        Right arm full overview
    </div>
</div>

{: style="text-align: center" .fs-8 }
[Next step &rarr;](/manual/build/hydra/rear_arm){: .btn .btn-red }
