ZeroGDesign/docs/docs/assets/images/instructions/m1_1/spacer_instruction.pdf

# DOCS.ZEROG.ONE

## PREPARATION

MEASURE YOUR TOOTHED IDLER

To find the right spacers, measure your pulley's height and check the next page for "Xmm," where X is the height. Print the corresponding spacers.

1

We've got support for multiple types of Toothed Idlers on board, and we understand that this might require a bit of clarification. So, without further ado, let's dive into the details!

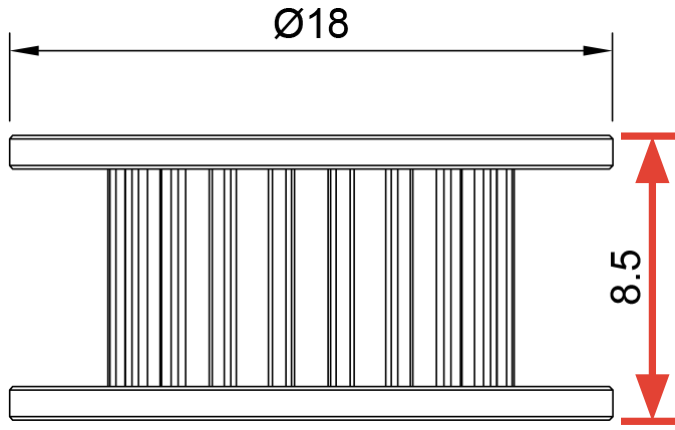
[picture p162: figure]
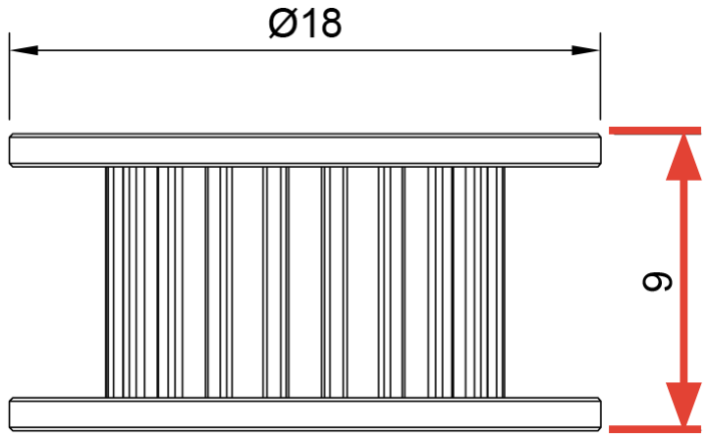
[picture p163: figure]
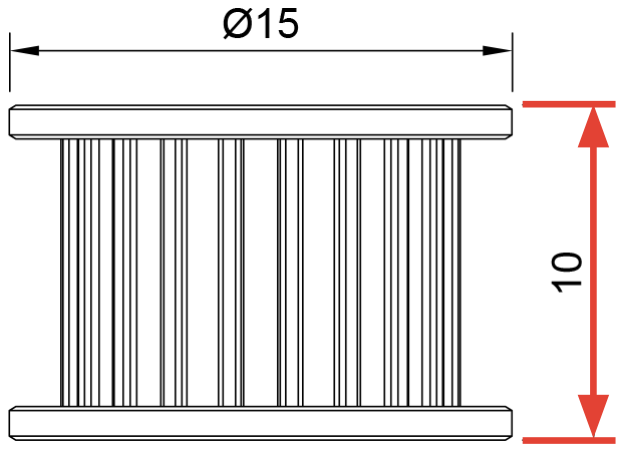
[picture p164: figure]
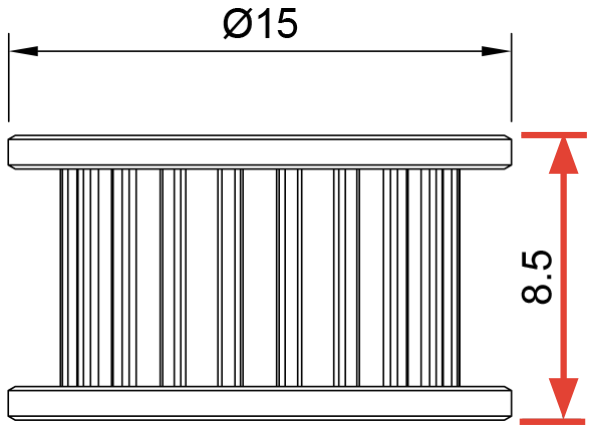
[picture p165: figure]

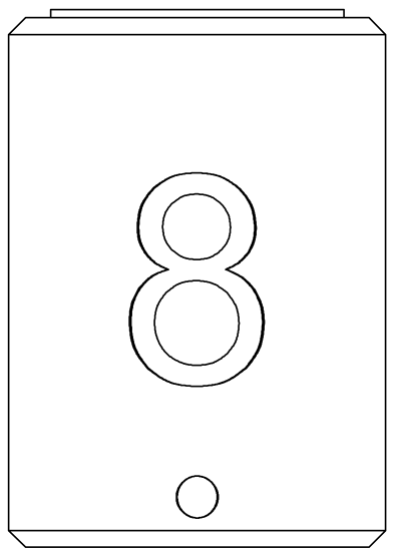
[picture p166: figure]
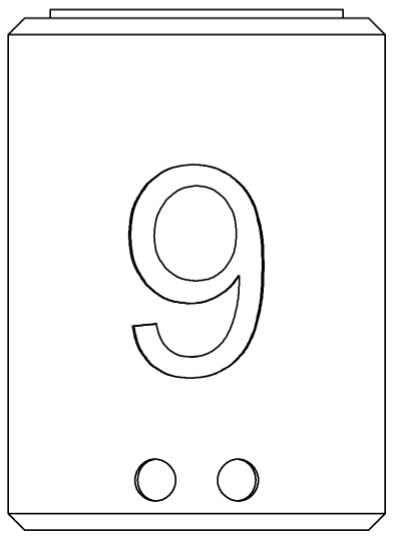
[picture p167: figure]
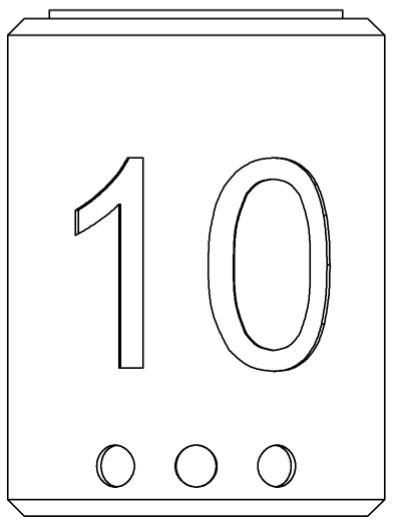
[picture p168: figure]

# DOCS.ZEROG.ONE

## PREPARATION

Printed the manual? Write down your Toothed Idler size on the line provided below to save yourself from measuring it repeatedly:

Toothed Idler Size: ________________________

On the website's configurator, there's a section for choosing your printed spacer. Make sure it matches the image provided below for accurate selection.

2

10MM | 9MM | 8.5MM

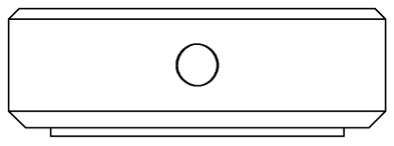
[picture p169: figure]
