ZeroGDesign/docs/docs/pages/menu/menu_manual.md

---
layout: default
title: Manual
nav_order: 30
has_toc: true
has_children: true
permalink: /manual/build
---

# Manuals
