ZeroGDesign/docs/docs/pages/menu/menu_howto.md

---
layout: default
title: How To
nav_order: 5
has_toc: true
has_children: true
permalink: /howto/build
---

# How to Build

SOON™
{: .label .label-red }

- [ ] Make the build instructions
- [ ] Make them faster
- [x] delay the build instructions
