ZeroGDesign/docs/docs/pages/manual/build/mercury_one_1/build_instruiction.md

---
layout: default
title: Build Instructions
nav_order: 50
has_toc: false
parent: Mercury One.1
grand_parent: Manual
permalink: /manual/build/mercury_eva/build_instruction
img_instr: ../../../assets/images/instructions
---

# Build Instructions
{: .no_toc }

It's time to roll up our sleeves and get building with the release of our long-awaited PDF build instructions for the Mercury One.1.

We owe a huge debt of gratitude to our incredible community member, <i class="bi bi-discord"> **jonspaceharper**, for their dedication in bringing these instructions to life.

But we couldn't have done it without you, our community! Your continuous feedback and support have been instrumental in refining both the build instructions and the project itself.

## <i class="bi bi-filetype-pdf"></i> PDF

### Download Link

Click [here](../../../assets/mercury_one_1_instruction_18-02-2024.pdf) to download the latest Build Manual.

If the link doesn't work, you can copy and paste this URL into your browser: [https://docs.zerog.one/assets/mercury_one_1_instruction_18-02-2024.pdf](https://docs.zerog.one/assets/mercury_one_1_instruction_18-02-2024.pdf).

Please note that the download may take a while, as the file size is quite large.

### Version

The current version is dated 2024-02-18, which is also indicated in the PDF file's bottom right corner.
