ZeroGDesign/docs/docs/pages/manual/build/mercury_one_1/introduction.md

---
layout: default
title: Need to know
nav_order: 0
has_toc: false
parent: Mercury One.1
grand_parent: Manual
permalink: /manual/build/mercury_eva/introduction
img_tool: ../../../../assets/images/tools
---

# **Need to know**
{: .no_toc }

Building the Mercury One.1
{: .fs-6 .fw-300 }

<dl>
  <dt>Build Difficulty</dt>
  <dd><span style="color:#a1c01a">Moderate</span></dd>
  <dt>Config/Electronics Difficulty</dt>
  <dd><span style="color:#d6c01a">intermediate (for beginners)</span></dd>
  <dt>Language</dt>
  <dd>English</dd>
</dl>

## Higher resolution image

Hovering an image with your mouse will show a zoom icon <i class="bi bi-zoom-in"></i> after opening the image you can either click 'CLOSE' or anywhere on the screen to close the pop-up.

<div onclick="location.href='##';"  id="lightbox__item_1"  class="lightbox__item">
    <div class="lightbox__content">

        Soldering iron
    </div>
</div>

<div onclick="location.href='##';"  id="lightbox__item_2"  class="lightbox__item">
    <div class="lightbox__content">

        Hex keys
    </div>
</div>

<div onclick="location.href='##';"  id="lightbox__item_3"  class="lightbox__item">
    <div class="lightbox__content">

        Flush cutter
    </div>
</div>

<div onclick="location.href='##';"  id="lightbox__item_4"  class="lightbox__item">
    <div class="lightbox__content">

        Corless drill
    </div>
</div>

<div onclick="location.href='##';"  id="lightbox__item_5"  class="lightbox__item">
    <div class="lightbox__content">

        Sand paper
    </div>
</div>

## Do's and dont's

1. **Read and execute the instructions.**
2. **Got questions?**
   1. Join our [Discord server <i class="bi bi-discord"></i>](https://discord.gg/zerog){:target="_blank"}.
3. **Don't just look at images.**
   1. An image doesn't explain the full story.
   2. There is text that will explain every step, read it carefully.
4. **Don't use force, you shouldn't have too.**
   1. Make sure to not use a unreasonable amount of force.
   2. Plastic does break and flange bearings crack, would be a waste wouldn't it?

## Need more help?

Lost? Need help? Not sure? Join our [Discord server <i class="bi bi-discord"></i>](https://discord.gg/zerog){:target="_blank"}, we've got a big community ready to help you out 

{: style="text-align: center" .fs-8}
[Next step &rarr;](/manual/build/mercury_eva/bill_of_material){: .btn .btn-red }
