ZeroGDesign/docs/docs/pages/manual/build/Hydra/manual_overview.md

---
layout: default
title: Hydra
nav_order: 2
has_children: true
has_toc: true
parent: Manual
permalink: /manual/build/hydra
---

# Hydra table of content
{: .no_toc }

1. Table of content
{:toc}

{: style="text-align: center" .fs-8 }
[Step One &rarr;](/manual/build/hydra/introduction){: .btn .btn-red }
