ZeroGDesign/docs/docs/assets/images/assembly/bearings/flange_stack.png

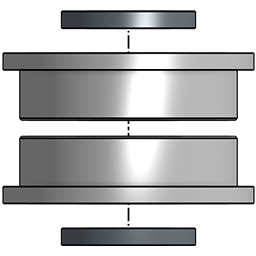
docs/assets/images/assembly/bearings/flange_stack.png
