ZeroGDesign/docs/docs/assets/images/assembly/front_towers/left_front_tower.png

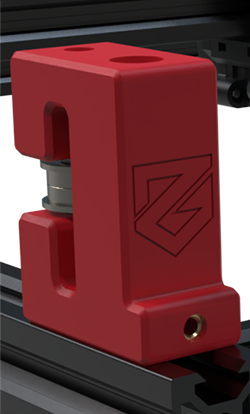
docs/assets/images/assembly/front_towers/left_front_tower.png
