ZeroGDesign/docs/docs/assets/images/assembly/front_towers/render_towers.png

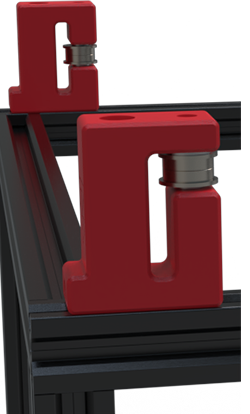
docs/assets/images/assembly/front_towers/render_towers.png
