ZeroGDesign/docs/docs/assets/images/assembly/front_towers/right_front_tower.png

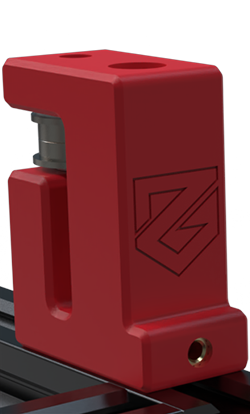
docs/assets/images/assembly/front_towers/right_front_tower.png
