ZeroGDesign/docs/docs/assets/images/assembly/insert/4mm_heat_set.png

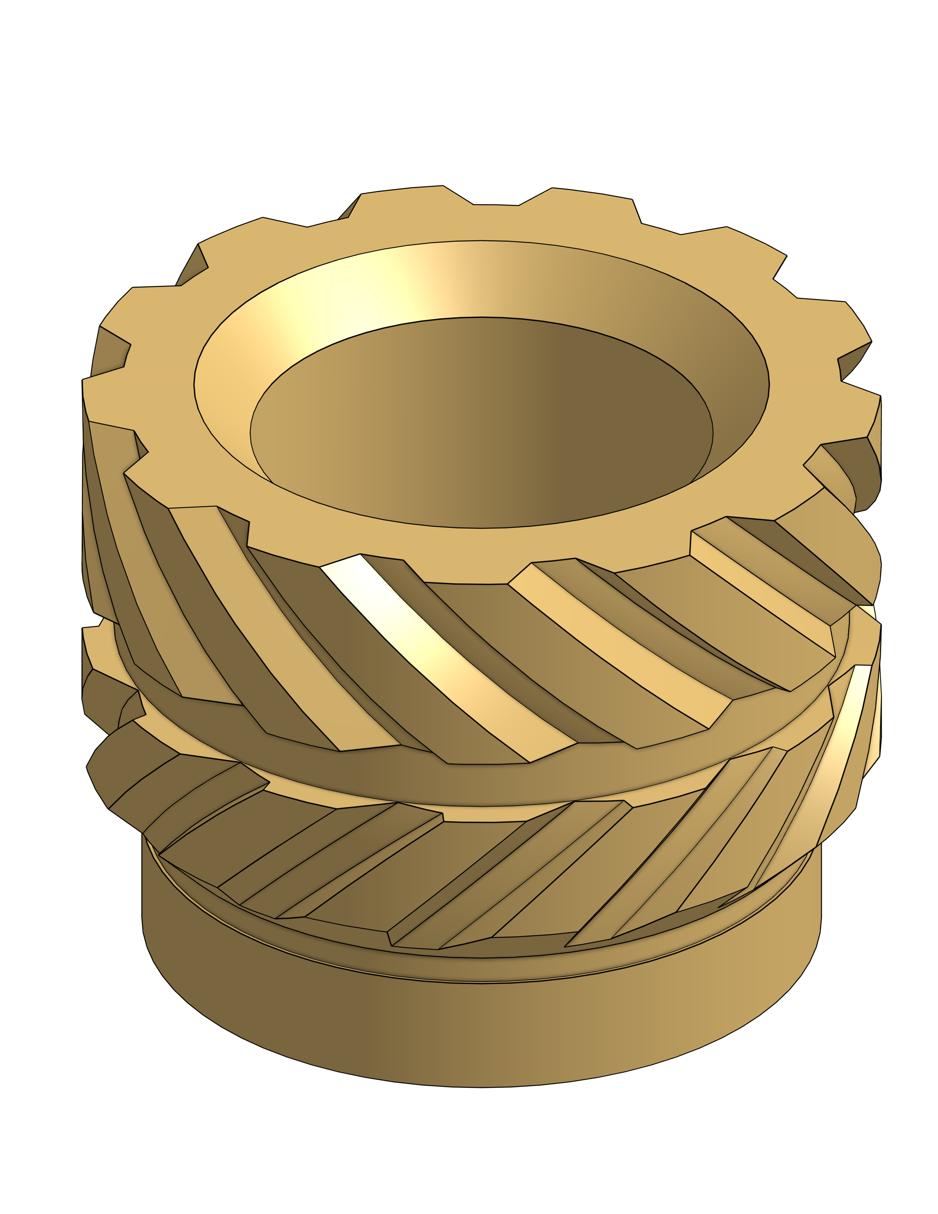
docs/assets/images/assembly/insert/4mm_heat_set.png
