ZeroGDesign/docs/docs/assets/images/assembly/nuts/m5_spring_tnut.png

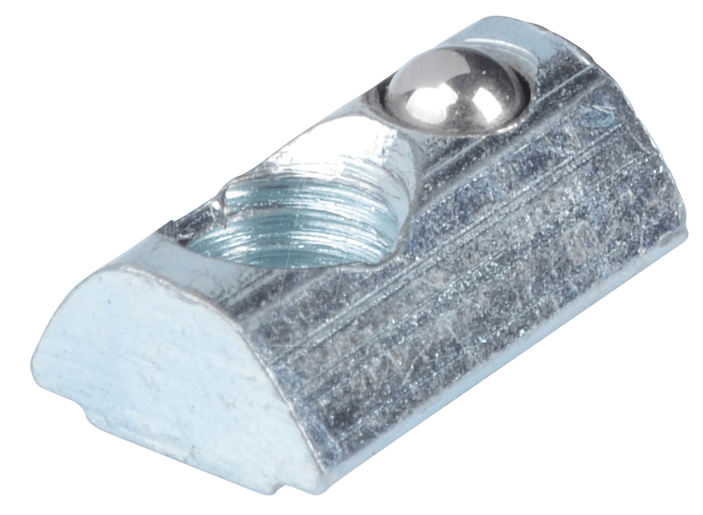
docs/assets/images/assembly/nuts/m5_spring_tnut.png
