ZeroGDesign/docs/docs/assets/images/assembly/screws/m3x30.png

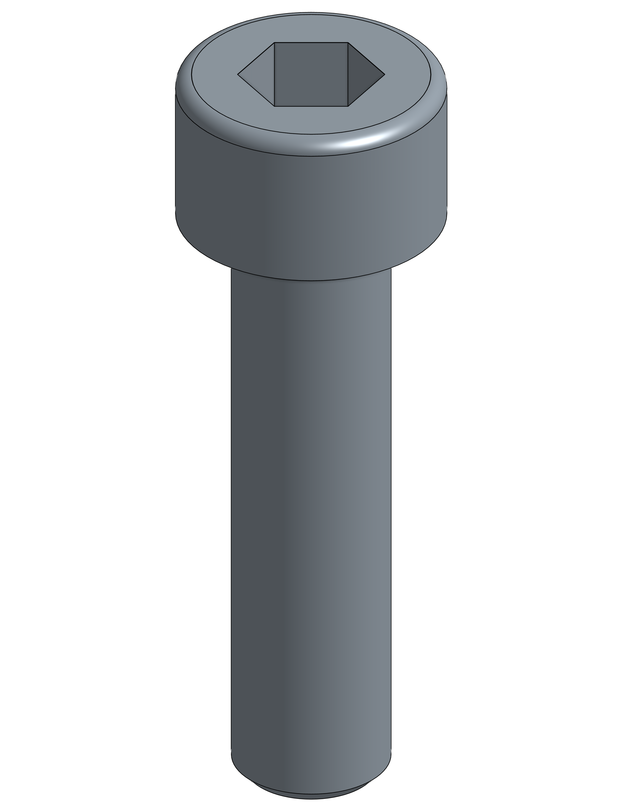
docs/assets/images/assembly/screws/m3x30.png
