ZeroGDesign/docs/docs/assets/images/instructions/assembly/left_stepper/fit_drill.jpg

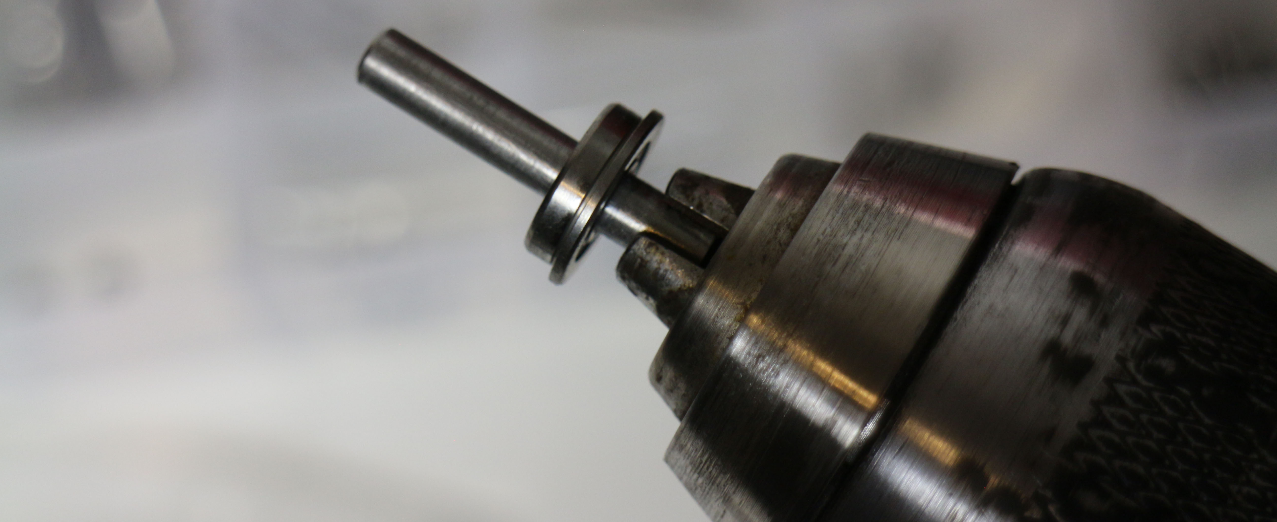
docs/assets/images/instructions/assembly/left_stepper/fit_drill.jpg
