ZeroGDesign/docs/docs/assets/images/instructions/assembly/left_stepper/left_stepper_one_screw_sit.png

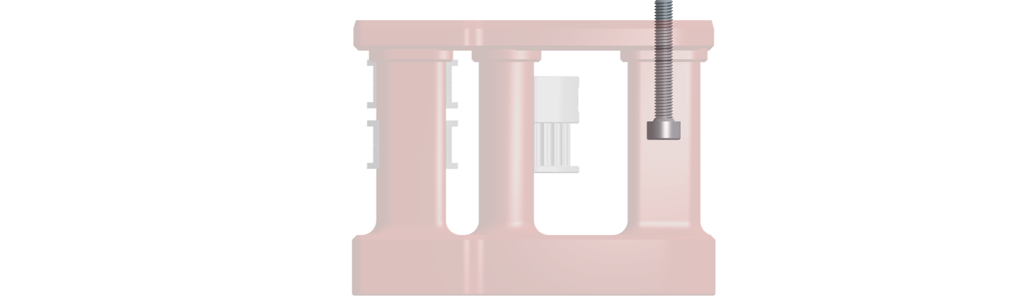
docs/assets/images/instructions/assembly/left_stepper/left_stepper_one_screw_sit.png
