ZeroGDesign/docs/docs/assets/images/instructions/gantry.png

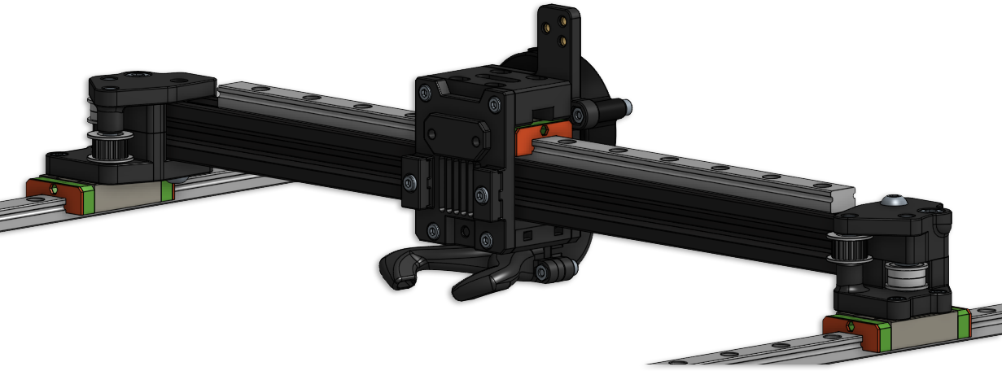
docs/assets/images/instructions/gantry.png
