ZeroGDesign/docs/docs/assets/images/instructions/hydra/left_arm/step3_place_rail.png

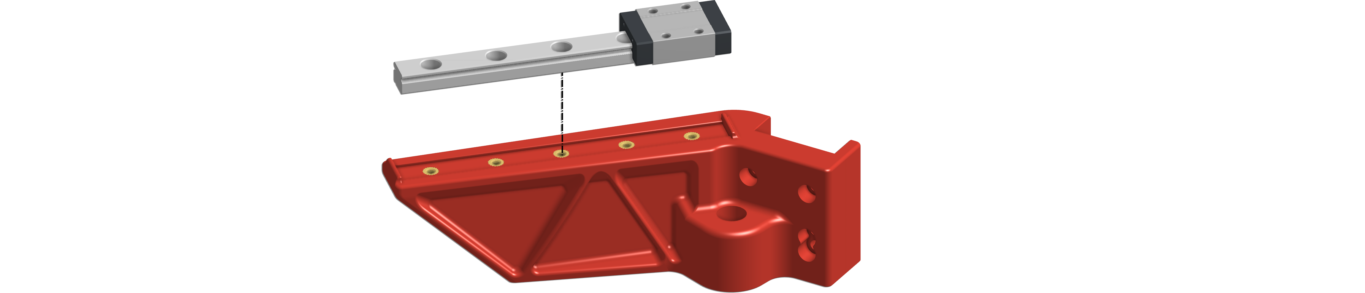
docs/assets/images/instructions/hydra/left_arm/step3_place_rail.png
