ZeroGDesign/docs/docs/assets/images/instructions/hydra/left_arm/step8_lower_center_magnet.png

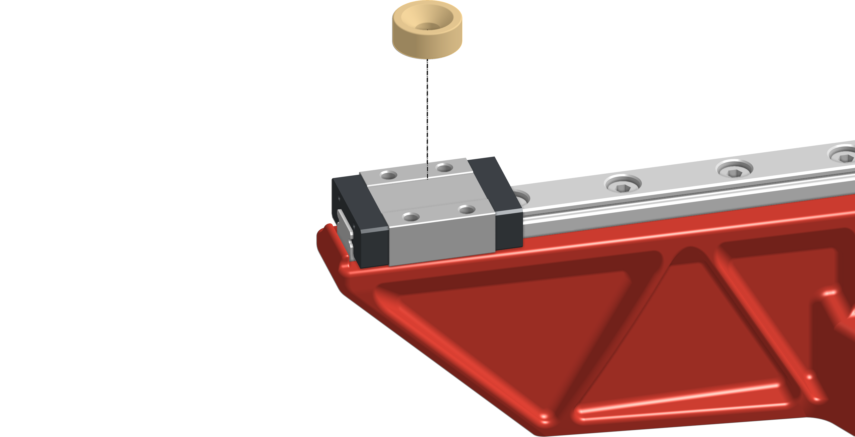
docs/assets/images/instructions/hydra/left_arm/step8_lower_center_magnet.png
