ZeroGDesign/docs/docs/assets/images/instructions/hydra/left_arm/step10_lower_tank.png

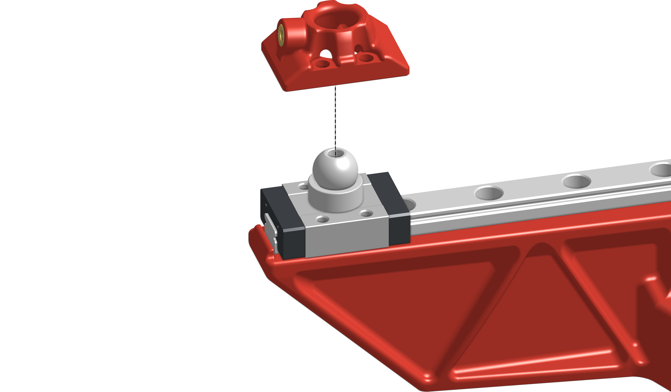
docs/assets/images/instructions/hydra/left_arm/step10_lower_tank.png
