ZeroGDesign/docs/docs/assets/images/instructions/hydra/left_arm/step11_lowered_tank.png

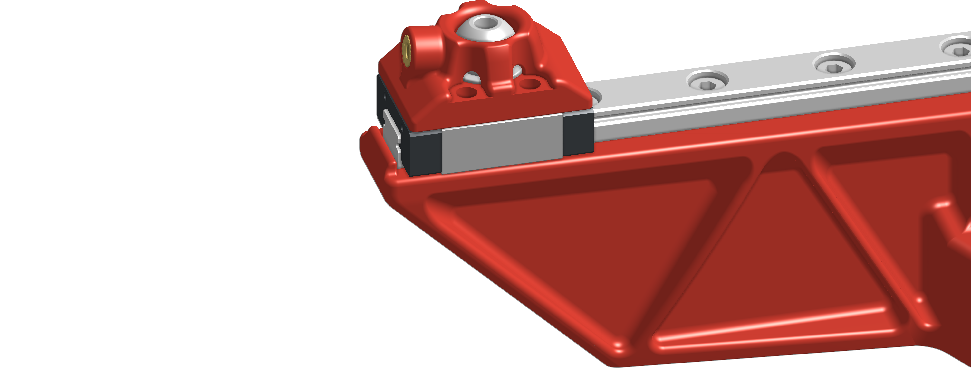
docs/assets/images/instructions/hydra/left_arm/step11_lowered_tank.png
