ZeroGDesign/docs/docs/assets/images/instructions/hydra/left_motor_mount.png

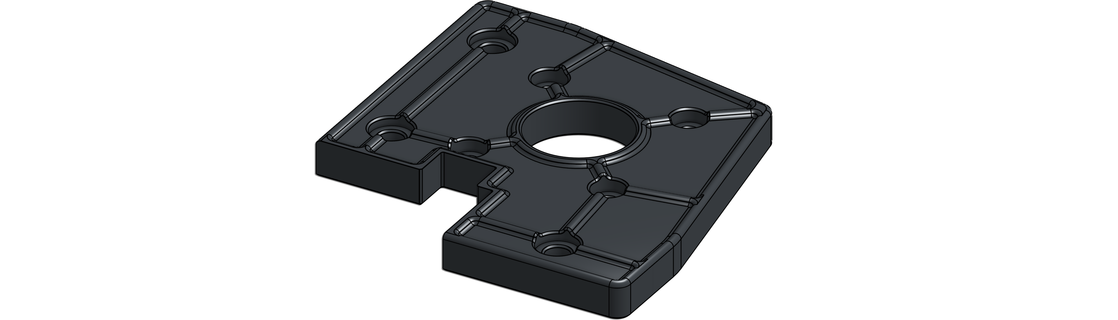
docs/assets/images/instructions/hydra/left_motor_mount.png
