ZeroGDesign/docs/docs/assets/images/instructions/hydra/rear_motor_mount.png

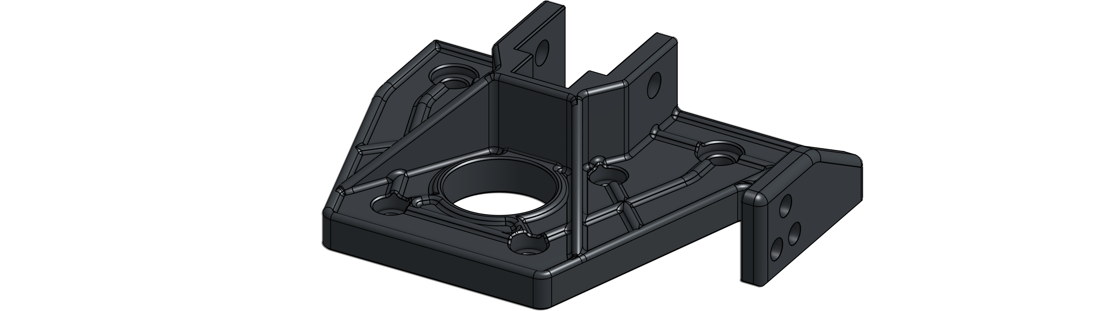
docs/assets/images/instructions/hydra/rear_motor_mount.png
