ZeroGDesign/docs/docs/assets/images/instructions/hydra/right_arm/step1_inserts_bottom.png

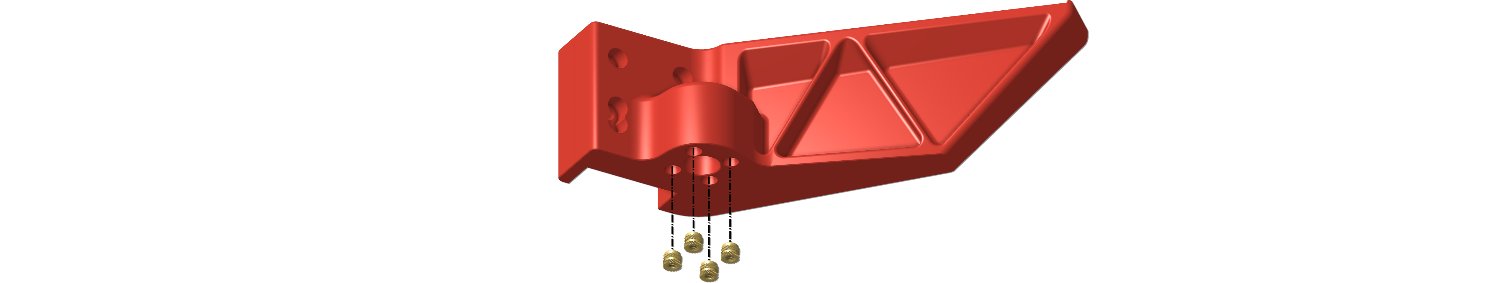
docs/assets/images/instructions/hydra/right_arm/step1_inserts_bottom.png
