ZeroGDesign/docs/docs/assets/images/instructions/hydra/right_arm/step2_inserts_top.png

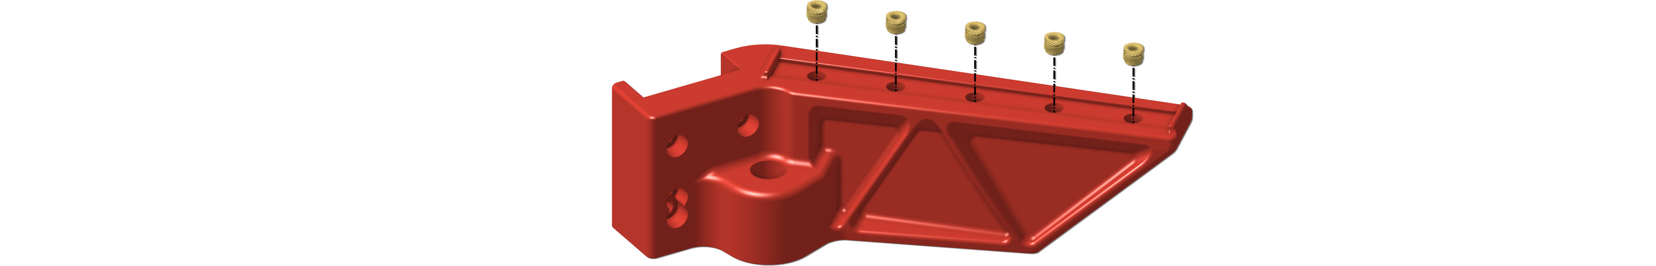
docs/assets/images/instructions/hydra/right_arm/step2_inserts_top.png
