ZeroGDesign/docs/docs/assets/images/instructions/hydra/right_arm/step3_place_rail.png

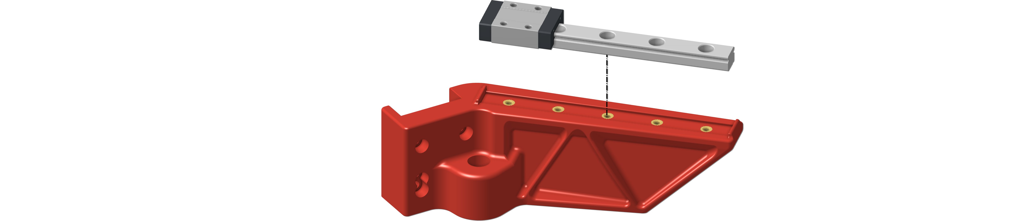
docs/assets/images/instructions/hydra/right_arm/step3_place_rail.png
