ZeroGDesign/docs/docs/assets/images/instructions/hydra/right_arm/step5_insert_front3.png

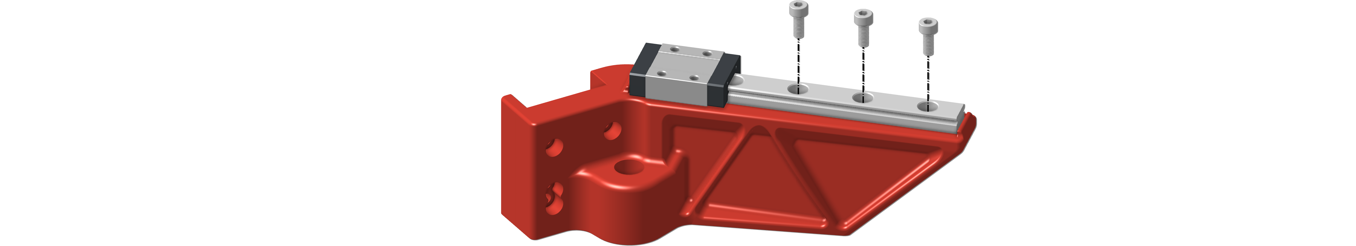
docs/assets/images/instructions/hydra/right_arm/step5_insert_front3.png
