ZeroGDesign/docs/docs/assets/images/instructions/hydra/right_arm/step6_forward_lastbolts.png

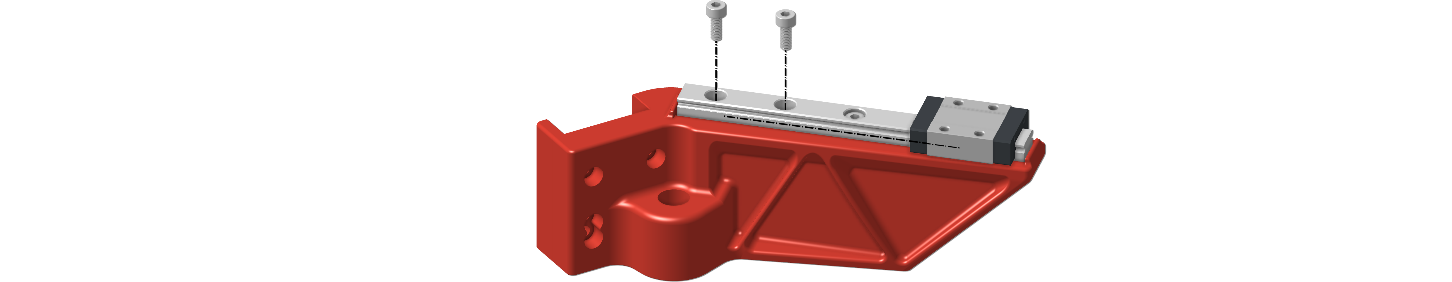
docs/assets/images/instructions/hydra/right_arm/step6_forward_lastbolts.png
