ZeroGDesign/docs/docs/assets/images/instructions/hydra/right_arm/step8_lower_center_magnet.png

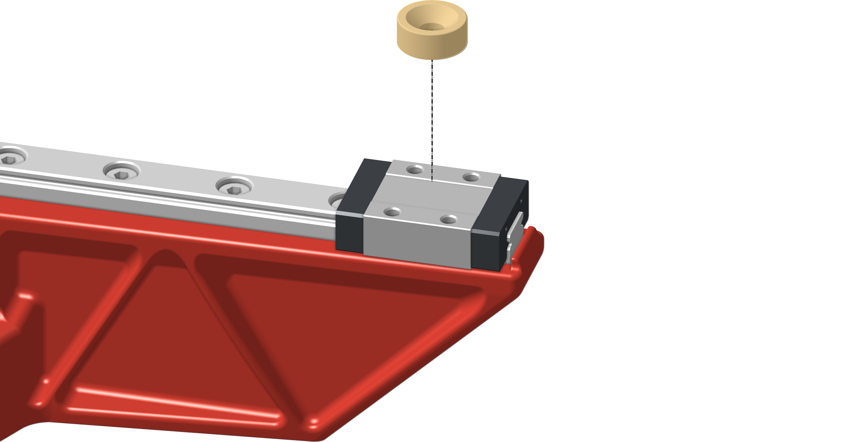
docs/assets/images/instructions/hydra/right_arm/step8_lower_center_magnet.png
