ZeroGDesign/docs/docs/assets/images/instructions/hydra/right_arm/step10_lower_tank.png

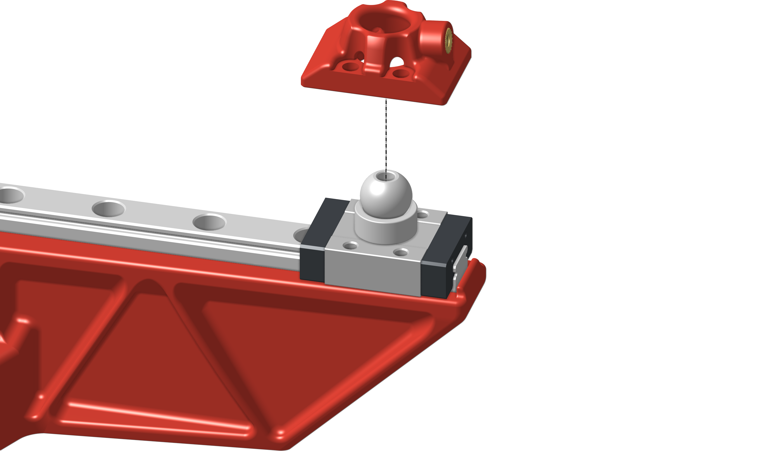
docs/assets/images/instructions/hydra/right_arm/step10_lower_tank.png
