ZeroGDesign/docs/docs/assets/images/instructions/hydra/right_arm/step11_lowered_tank.png

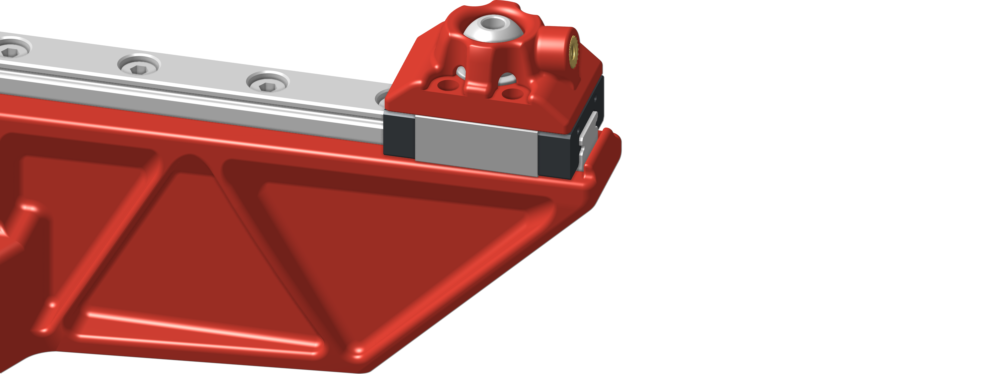
docs/assets/images/instructions/hydra/right_arm/step11_lowered_tank.png
