ZeroGDesign/docs/docs/assets/images/instructions/hydra/right_arm/step13_insert_tension_screw.png

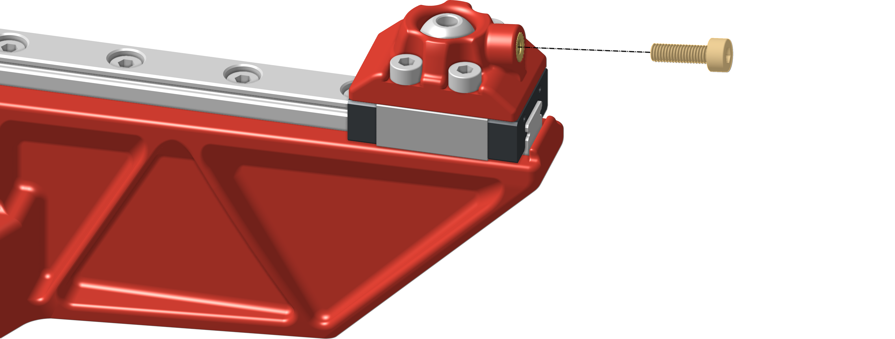
docs/assets/images/instructions/hydra/right_arm/step13_insert_tension_screw.png
