ZeroGDesign/docs/docs/assets/images/instructions/m1_1/left_front_tower/step_1.png

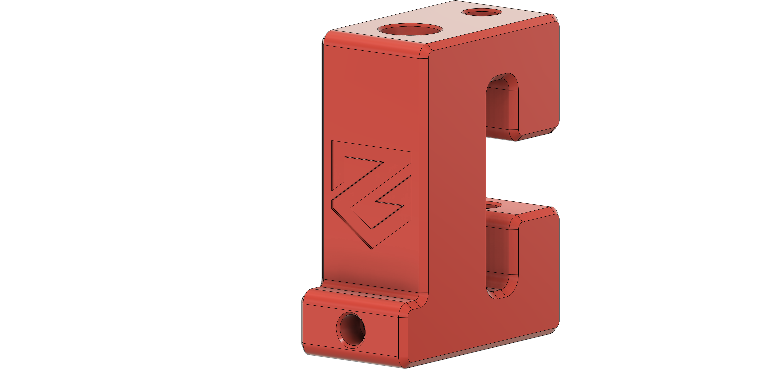
docs/assets/images/instructions/m1_1/left_front_tower/step_1.png
