ZeroGDesign/docs/docs/assets/images/instructions/m1_1/left_stepper_tower/show_guides.png

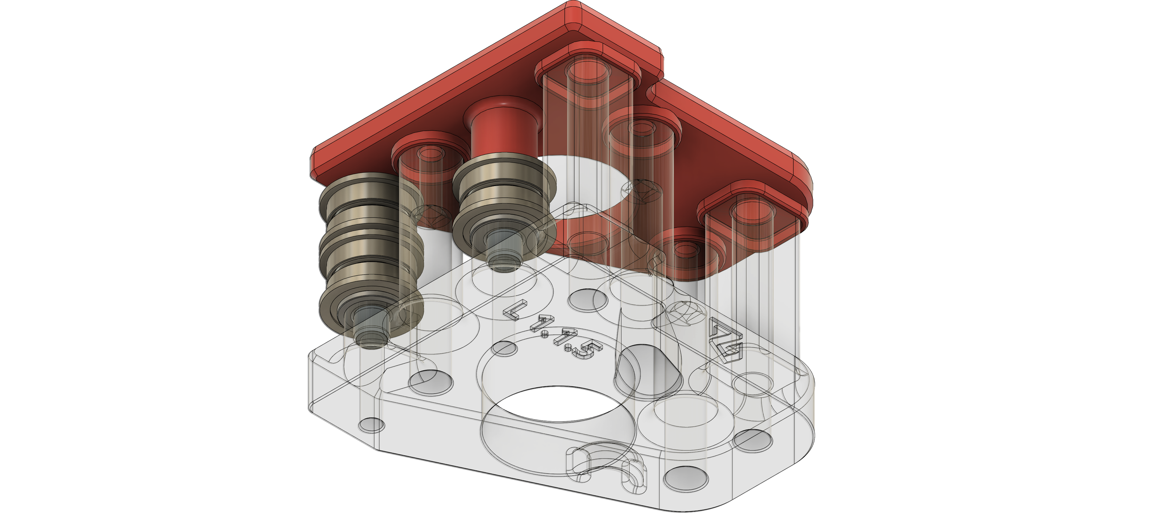
docs/assets/images/instructions/m1_1/left_stepper_tower/show_guides.png
