ZeroGDesign/docs/docs/assets/images/instructions/m1_1/right_stepper_tower/step_1.png

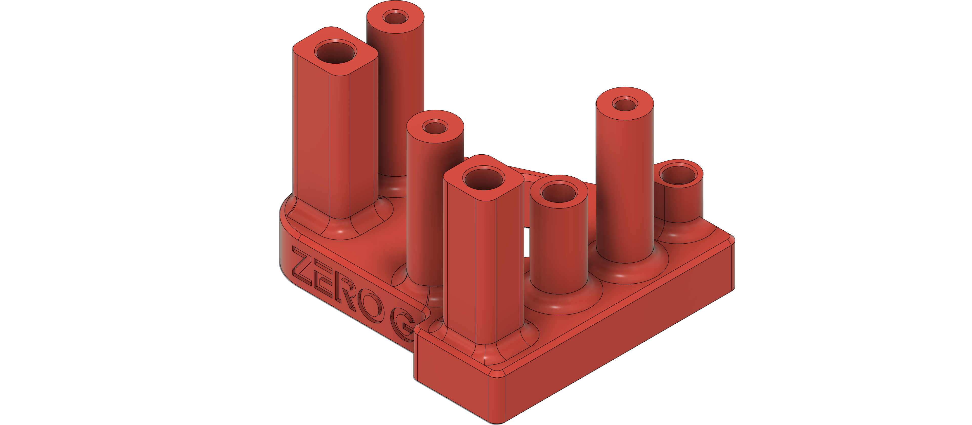
docs/assets/images/instructions/m1_1/right_stepper_tower/step_1.png
