ZeroGDesign/docs/docs/assets/images/instructions/printed_stepper_right_bottom.png

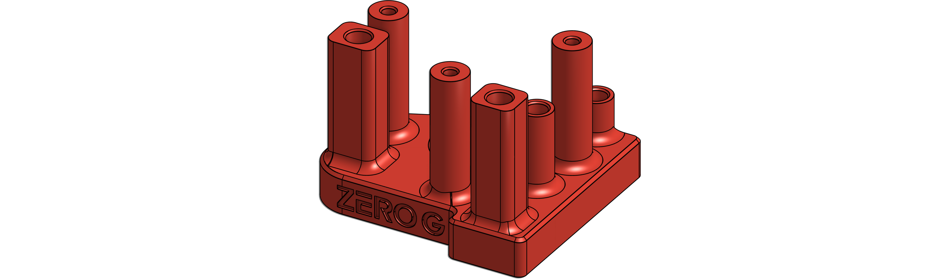
docs/assets/images/instructions/printed_stepper_right_bottom.png
