ZeroGDesign/docs/docs/assets/images/instructions/printer_stepper_right_top.png

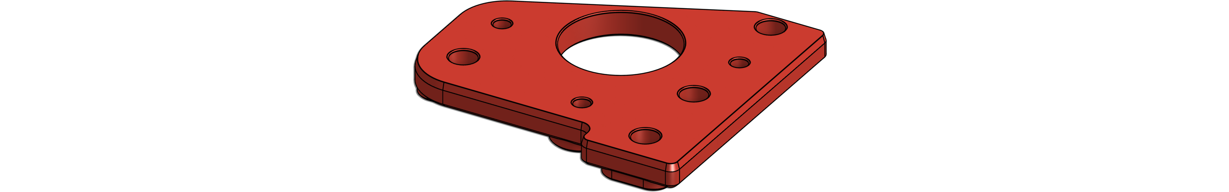
docs/assets/images/instructions/printer_stepper_right_top.png
