ZeroGDesign/docs/docs/pages/changelog/changelog_electronicsenclosure.md

---
layout: default
title: Electronics Enclosure
nav_order: 30
has_children: false
has_toc: true
parent: Changelog
permalink: /changelog/electronics_enclosure
img_instr: ../../../assets/images/examples
---

# Hydra changelog
{: .no_toc }

This page contains a list of updates that have been made to the Electronics Enclosure. It is a record of changes and improvements that have been made over time.
{: .fs-5 .fw-300 }

<div class="code-example" markdown="1">
#### 21Th February 2024
{: .no_toc }

Quality of life + printability!
1. Skirt Feet version 1.04.
   1. Added a V shape to the screw access holes in the bottom, which should make printing the part easier.
   2. The part has been adjusted to also fit M5 button screws.
   3. Check the screenshot [here](#lightbox_vshape_feet).
   4. These files can be found in the configurator or documentation GitHub.
2. 5 Pro / Plus bottom panel.
   1. Both bottom panels now support a cutout for the printed feet, making it easier to install after installation.
   2. These files can be found in the configurator or documentation GitHub.
3. Remove support stock ender feet.
   1. We've decided to remove the support of the stock feet, these are too thin and week to support the printer properly.

<div onclick="location.href='##';"  id="lightbox_vshape_feet"  class="lightbox__item">
    <div class="lightbox__content">

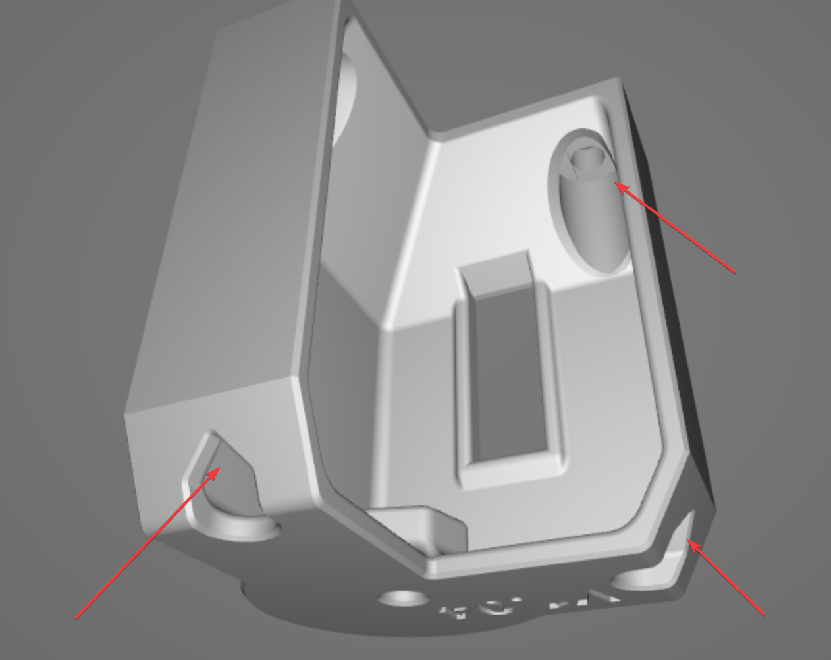
[picture p208: docs/assets/images/examples/v_shape_skirt_feet.png]
shows new V shape + button head screw support
        
    </div>
</div>

</div>

<div class="code-example" markdown="1">

#### 29th March 2023
{: .no_toc }

1. Setup Configurator

</div>
