ZeroGDesign/docs/docs/pages/changelog/changelog_mercury.md

---
layout: default
title: Mercury One.1
nav_order: 20
has_children: false
has_toc: true
parent: Changelog
permalink: /changelog/mercury
img_instr: ../../../assets/images/examples
---

# Mercury One.1 Changelog
{: .no_toc }

This page contains a list of updates that have been made to Mercury One.1. It is a record of changes and improvements that have been made over time.
{: .fs-5 .fw-300 }

1. Table of content
{:toc}

<div class="code-example" markdown="1">
#### 19Th February 2024
{: .no_toc }

Stronger fan ducts!
1. Intergrating the fan ducts into to the bottom plate
   1. We've merged two parts together to create one rigid part example [here](#lightbox_new_merged_parts).
   2. Find them in the [configurator](../../manual/build/mercury_eva/printed_files#eva-24-toolhead-configurator).

<div onclick="location.href='##';"  id="lightbox_new_merged_parts"  class="lightbox__item">
    <div class="lightbox__content">

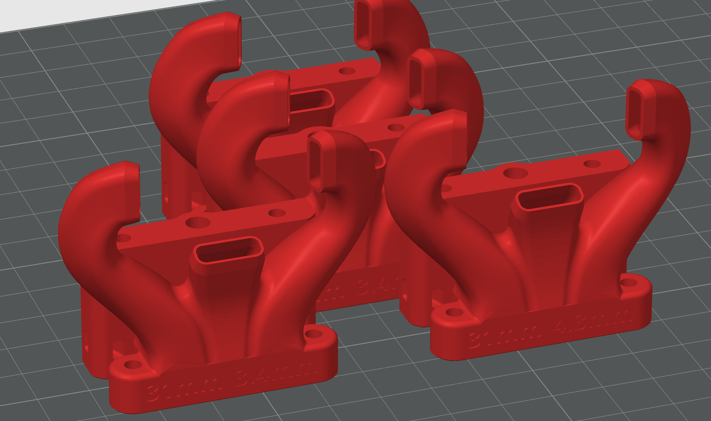
[picture p209: docs/assets/images/examples/example_duct_merged.png]
        
    </div>
</div>

</div>

<div class="code-example" markdown="1">
#### 18Th February 2024
{: .no_toc }

Release of the Mercury One.1 Build instructions!
1. The first version of the Build Instructions
   1. Find them [here](../../manual/build/mercury_eva/build_instruction).
2. X Joints Version 1.1.6!
   1. Spacer changes
      1. Removed the thin printed spacer on the flange stack (it was not visible as it was positioned below the printed surface of the Xjoint).
      2. Example [here](#lightbox_flange_stack_newfeb).
   2. Shaved off a minor 0.2 mm Z offset where the top and bottom X joints meet the 2020 extrusion.
3. Fixed rotation of Orbiter 2 top plate STL, exported at a 3 degree angle.
4. Included the Lightweight Fysetc extrusion Endstop block by default in the configurator.

<div onclick="location.href='##';"  id="lightbox_flange_stack_newfeb"  class="lightbox__item">
    <div class="lightbox__content">

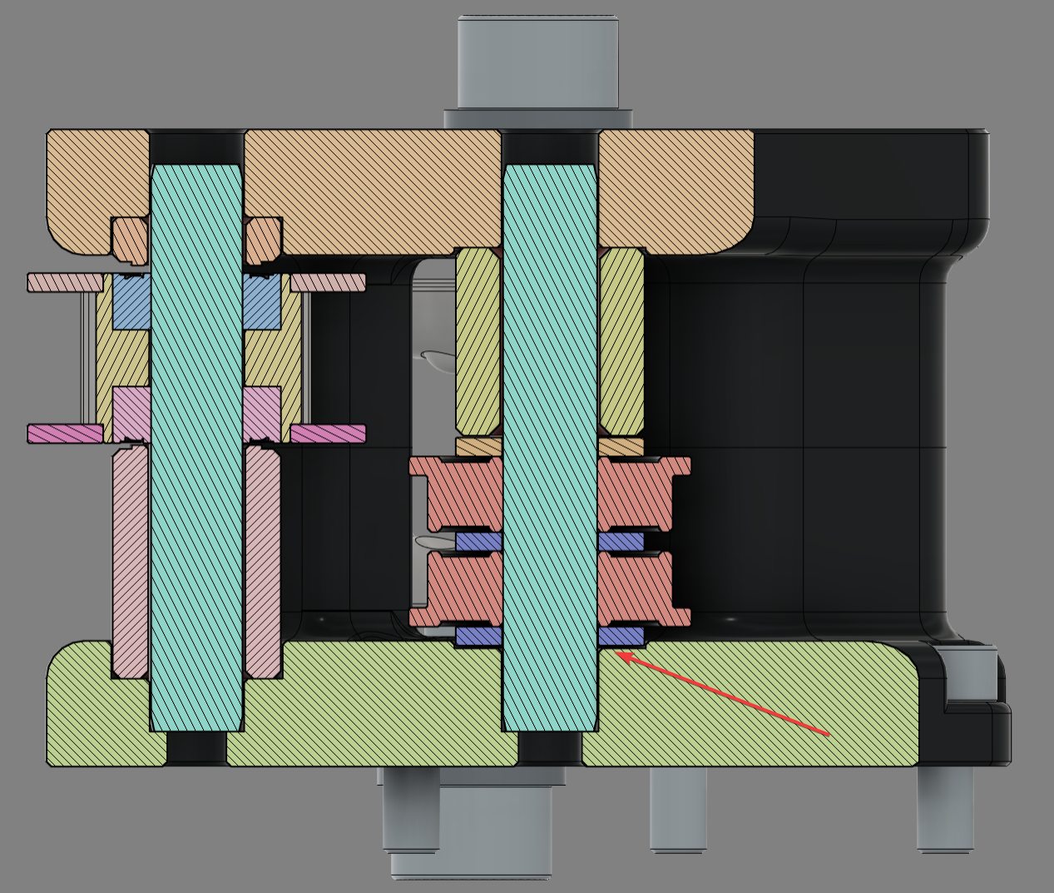
[picture p210: docs/assets/images/examples/xjoint_1_1_6.png]
        
    </div>
</div>

</div>

<div class="code-example" markdown="1">
#### 15Th August 2023
{: .no_toc }

Download the new files in our [Configurator](../../manual/build/mercury_eva/printed_files#eva-24-toolhead-configurator) or on [Github](https://github.com/ZeroGDesign/docs/tree/gh-pages/docs/assets/stl/m1_1){:target="_blank"}.
1. Stepper towers.
   1. [Rectangular pilars](#lightbox_new_steppertower_pilar) pilars for the dowel pins.
   2. [Different angle Chamfer](#lightbox_new_steppertower_fillet) on the bottom, increases printability.
   3. Changed hole size for [dowel pins from 5.3mm->5.2mm](#lightbox_new_steppertower_holesize).
   4. [Seam relieve features](#lightbox_new_steppertower_seamrelieve), make sure to check the [print standards](../../standard/print/settings#importing-zerog-files) for this!.
2. Belt Grinding.
   1. We've identified an issue in our earlier models where the dowel pin might be angled, leading to belt misalignment [here](#lightbox_old_angled_pin).
      1. Upon thorough research, this was linked to material shrinkage and differences in mass.
      2. We also identified that the seam's placement close to the hole reduced resistance around the dowel pin area to those same forces.
3. QOL - Front towers.
   1. Reduced the ZeroG logo depth to 0.25 for printability.
4. QOL - Front tension plate (T-Nut)
   1. Moved the m5 holes on the plate down 1.8mmm.

**It's important to note** that this update doesn’t completely resolve the belt grinding issues. Many of the persistent concerns can be traced back to the toothed idler on the stepper being misaligned. Additionally, the Creality frame's quality control might not be the most optimal, contributing to the problem.

<div onclick="location.href='##';"  id="lightbox_new_steppertower_pilar"  class="lightbox__item">
    <div class="lightbox__content">

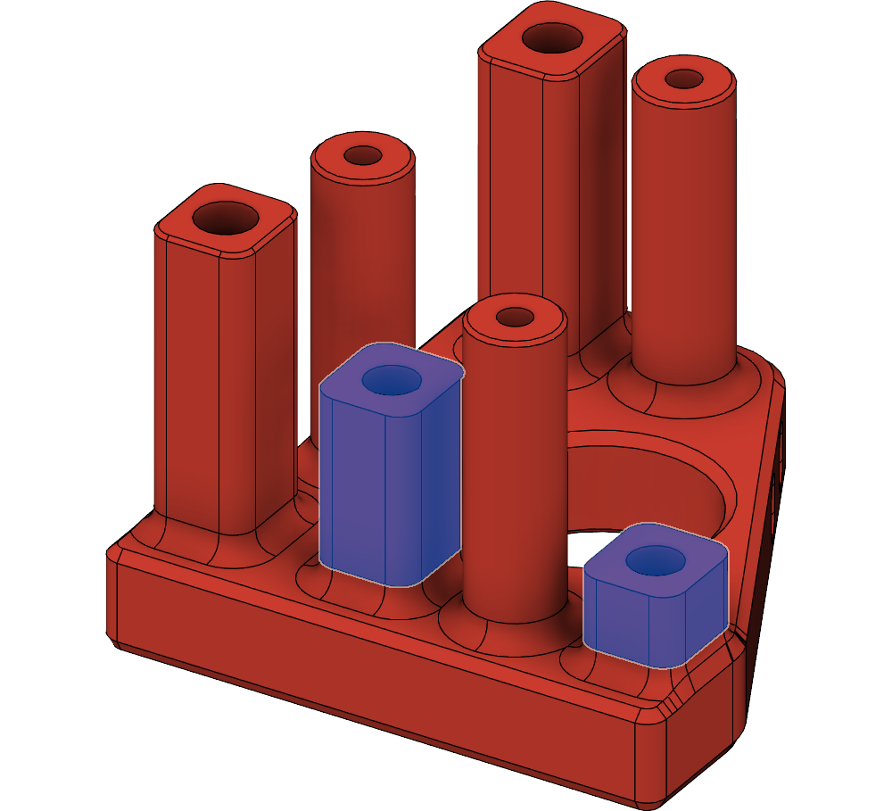
[picture p211: docs/assets/images/examples/stepper_tower_newpilar.png]
        
    </div>
</div>

<div onclick="location.href='##';"  id="lightbox_new_steppertower_fillet"  class="lightbox__item">
    <div class="lightbox__content">

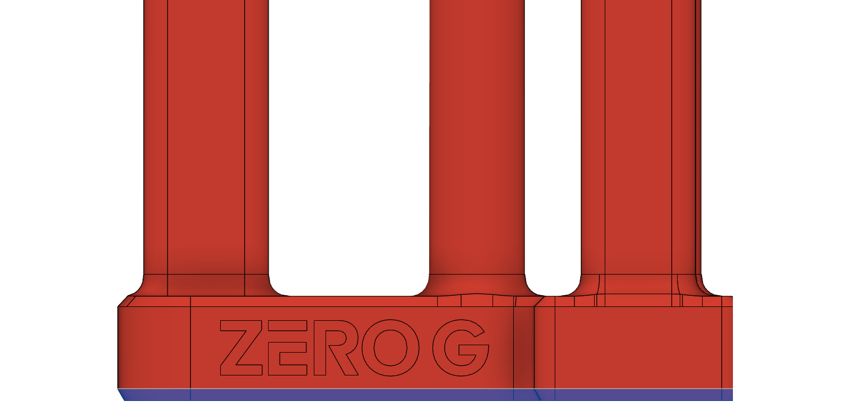
[picture p212: docs/assets/images/examples/stepper_towers_newfillet.png]
        
    </div>
</div>

<div onclick="location.href='##';"  id="lightbox_new_steppertower_holesize"  class="lightbox__item">
    <div class="lightbox__content">

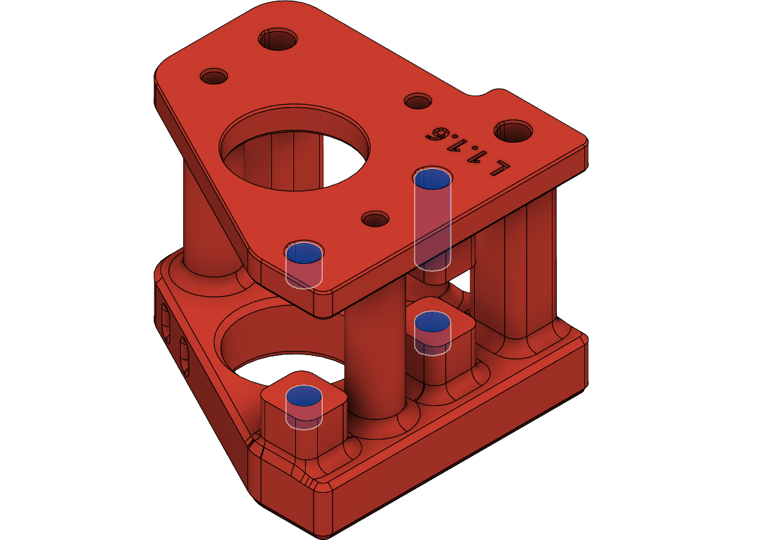
[picture p213: docs/assets/images/examples/stepper_tower_new_holesize.png]
        
    </div>
</div>

<div onclick="location.href='##';"  id="lightbox_new_steppertower_seamrelieve"  class="lightbox__item">
    <div class="lightbox__content">

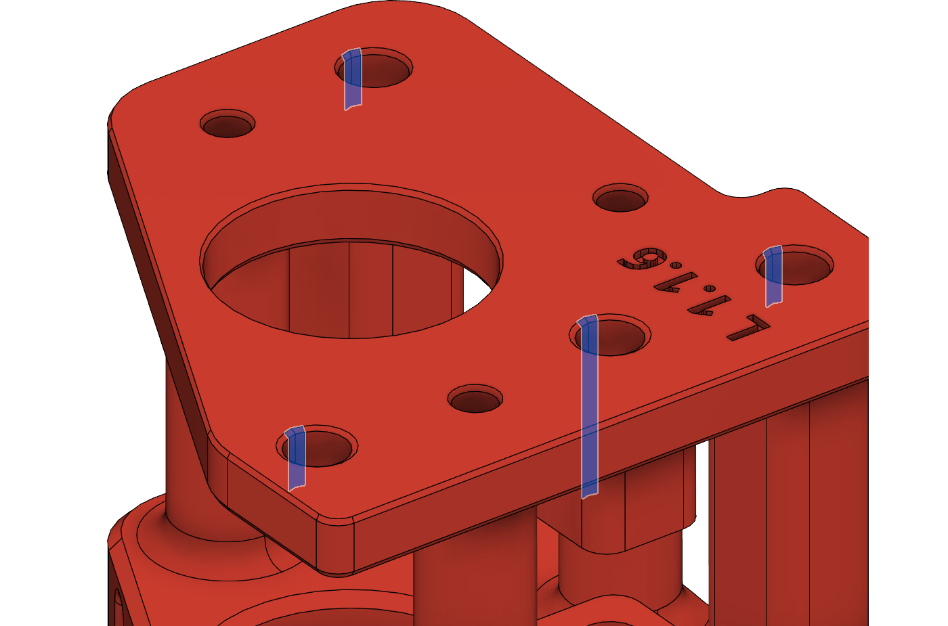
[picture p214: docs/assets/images/examples/stepper_tower_new_seamrelieve.png]
        
    </div>
</div>

<div onclick="location.href='##';"  id="lightbox_old_angled_pin"  class="lightbox__item">
    <div class="lightbox__content">

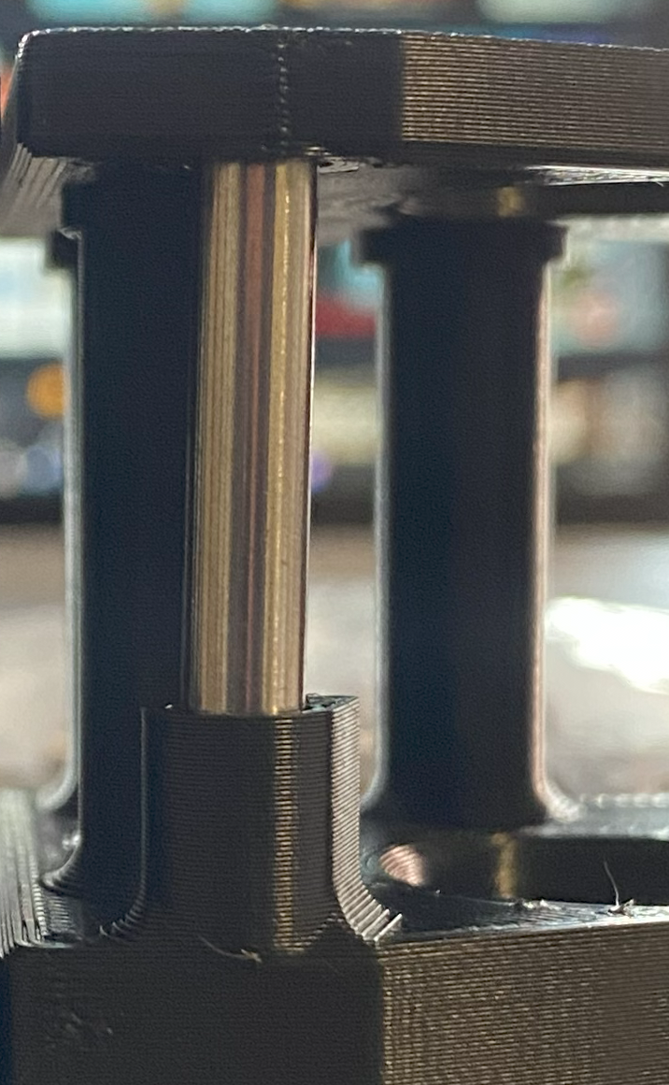
[picture p215: docs/assets/images/examples/oldtower_angledpin.png]
        
    </div>
</div>

</div>

<div class="code-example" markdown="1">
#### 5Th May 2023
{: .no_toc }

1. Modified the Configurator on the Mercury One.1 Files page.
   1. Toothed idlers are now named 8.5mm/ 9mm/ 10mm.
   2. A small PDF has been added to explain which to choose.

</div>

<div class="code-example" markdown="1">
#### 8Th April 2023
{: .no_toc }

This update brings improvements to many of the motion components, resolving some of the previous grinding problems.
1. Version numbers, an example [here](#lightbox_new_versionnumbers).
   1. Version numbers have been added to all the key motion files (**version 1.1.5**).
   2. Indicators '**L**' and '**R**' have been added to differentiate between the left and right components for easier instalation.
2. Front towers.
   1. Narrowed the v-slot guide to prevent it from sitting too high, improving the stability and precision of the motion.
3. Cable management ziptie holes have been added to the motor mounts
   1. Check out the image [here](#lightbox_cable_routing_stepper1_1_5).
4. **New flange stack!**
   1. To resolve the belt grinding issue, we have implemented a **new flange stack**.
      1.  **M5 Shim -> Bearing -> M5 Shim -> Bearing -> M5 Shim**.
   2. [Here](#lightbox_new_flange_stack) is a screenshot of the new flange stack.
5. **A new tool** has been introduced to help you align the flange stack with the front idlers.
      1. We've listened to your feedback and have created a simple and effective solution. [Check out the video](https://www.youtube.com/watch?v=abdkMgndM9Y) to see it in action!

<div onclick="location.href='##';"  id="lightbox_new_versionnumbers"  class="lightbox__item">
    <div class="lightbox__content">

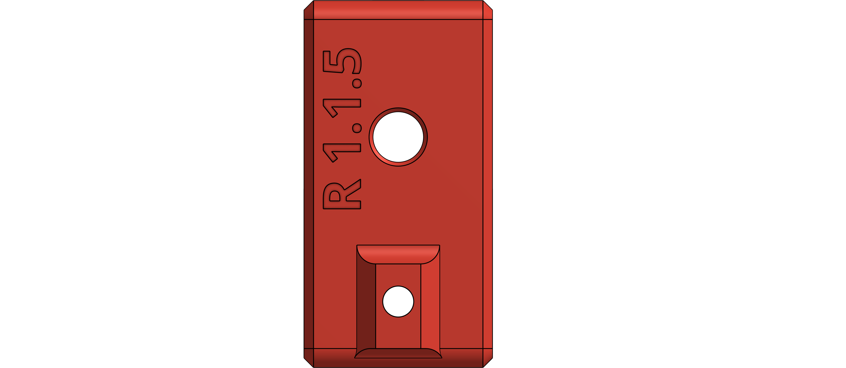
[picture p216: docs/assets/images/examples/version_numbers.png]
shows the version numbers
        
    </div>
</div>

<div onclick="location.href='##';"  id="lightbox_cable_routing_stepper1_1_5"  class="lightbox__item">
    <div class="lightbox__content">

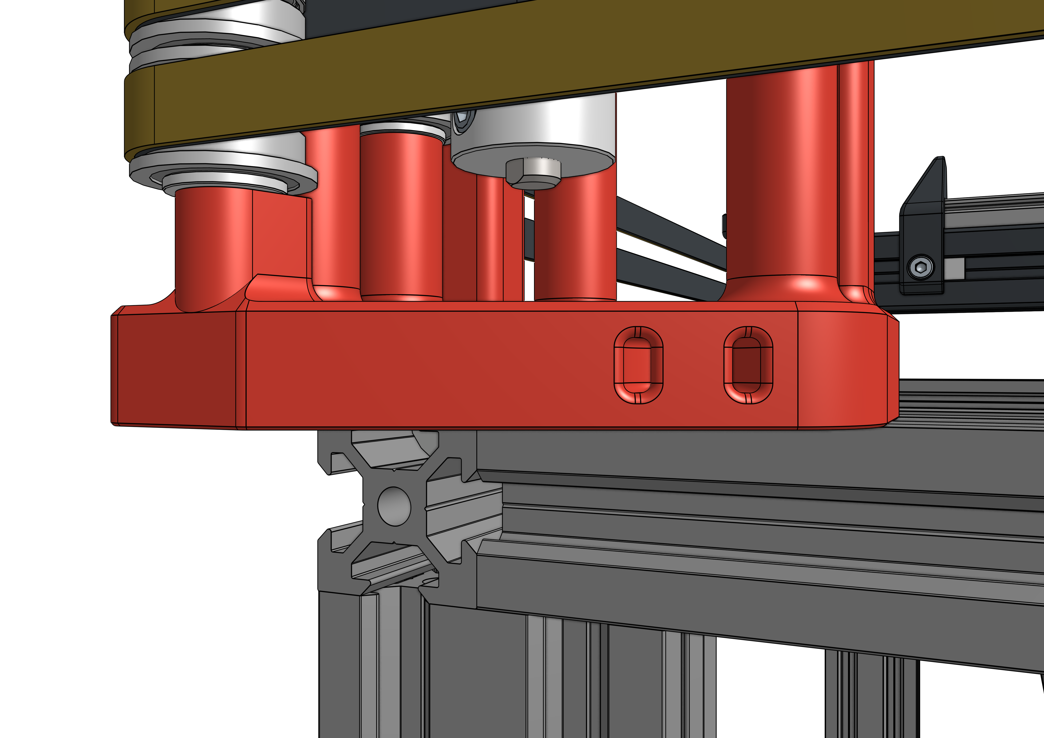
[picture p217: docs/assets/images/examples/cable_management_m1_1_5_steppers.png]
Cable routing
        
    </div>
</div>

<div onclick="location.href='##';"  id="lightbox_new_flange_stack"  class="lightbox__item">
    <div class="lightbox__content">

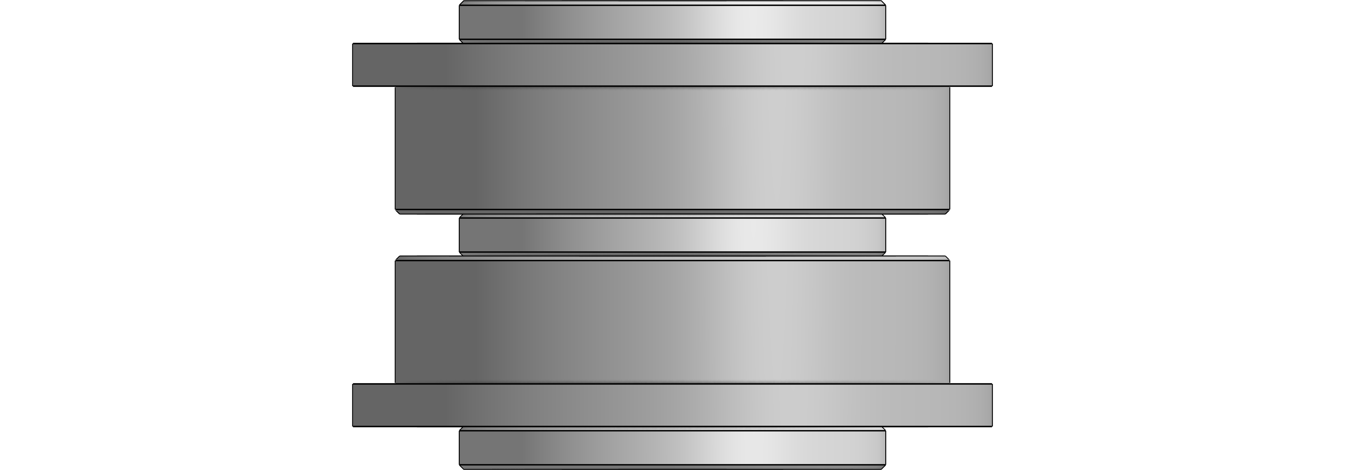
[picture p218: docs/assets/images/examples/new_flange_stack.png]
New flange stack
        
    </div>
</div>

</div>

<div class="code-example" markdown="1">
#### 26th December 2022
{: .no_toc }

This update brings significant improvements to the extruder mounts.
1. Replaced **ALL** M3 Nuts with Heatsets.
   1. The fanducts now utilize heatsets.
   2. The BLTouch and CRTouch mounts now also use heatsets.
2. Standardized the lenght of the M3 bolts.
   1. [Here](#lightbox_new_eva_hardware) is a screenshot of all the bolts required for the new EVA files.
3. Increased the counterbore size for all M3 bolts.
4. **Printability**
   1. Thin walls were corrected or removed to optimize printing.
   2. Changed some angles to make it easier to print overhangs.
5. We modified the Sherpa mini mount to be top-mounted.
   1. Take a look at these changes [here](#lightbox_sherpatopmount).
6. The introduction of color coding for hardware.
   1. The CAD file now includes color-coded representations of hardware, such as bolts.
      1. Take a look at these changes [here](#lightbox_m3_colorcoding) and [here](#lightbox_colorcoding).

<div onclick="location.href='##';"  id="lightbox_new_eva_hardware"  class="lightbox__item">
    <div class="lightbox__content">

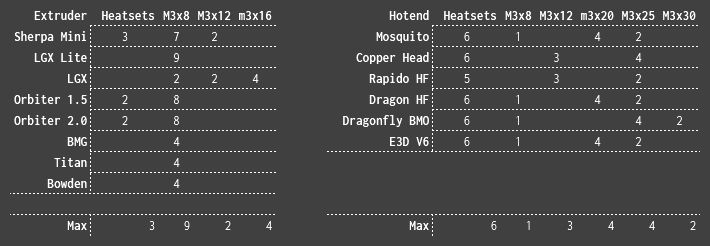
[picture p219: docs/assets/images/examples/new_bom_EVA.png]
List of hardware for EVA
        
    </div>
</div>

<div onclick="location.href='##';"  id="lightbox_m3_colorcoding"  class="lightbox__item">
    <div class="lightbox__content">

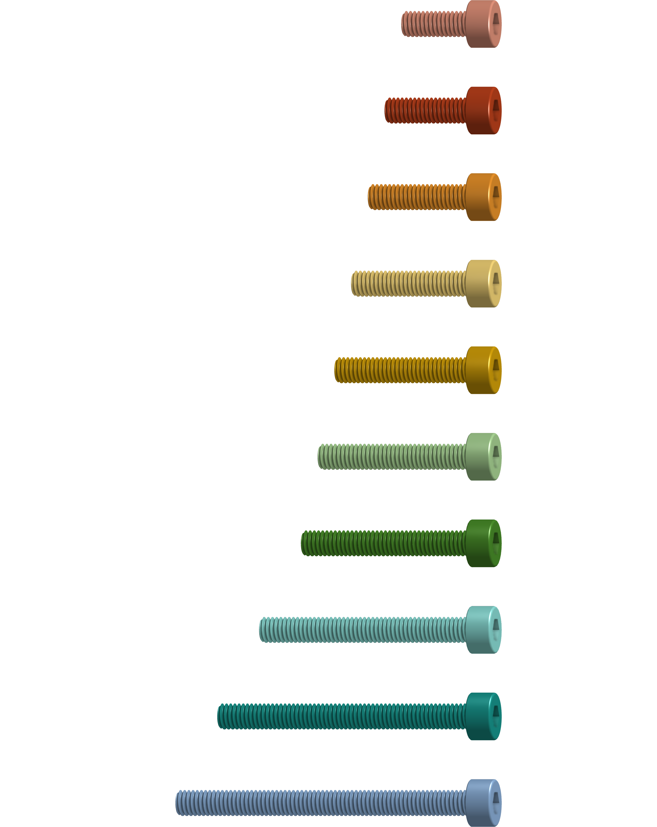
[picture p220: docs/assets/images/examples/m3_hardware_colorcoding.png]
Color coded hardware example
        
    </div>
</div>

<div onclick="location.href='##';"  id="lightbox_sherpatopmount"  class="lightbox__item">
    <div class="lightbox__content">

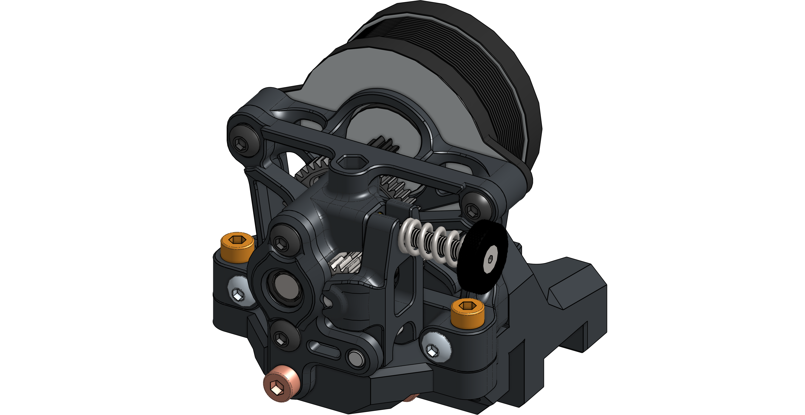
[picture p221: docs/assets/images/examples/top_mount_sherpa.png]
Color coded hardware example
        
    </div>
</div>

<div onclick="location.href='##';"  id="lightbox_colorcoding"  class="lightbox__item">
    <div class="lightbox__content">

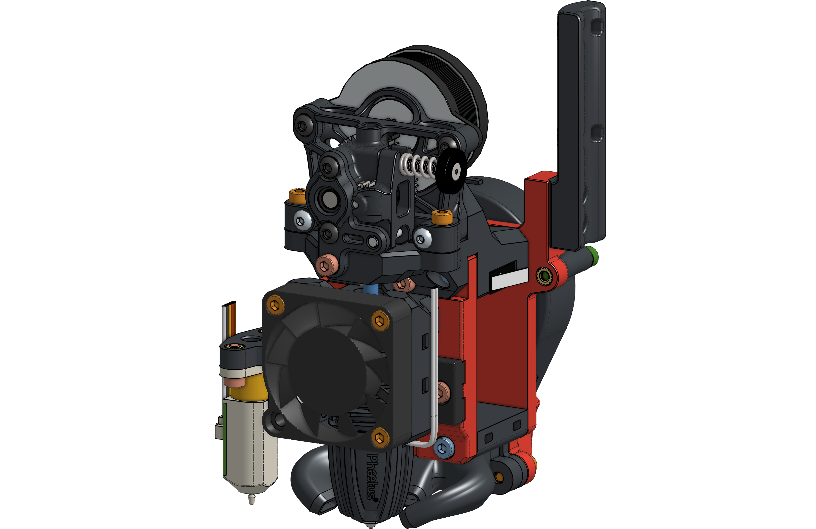
[picture p222: docs/assets/images/examples/colored_hardware.png]
Color coded toolhead example
        
    </div>
</div>

You can find the above changes in the Mercury One.1 manual.

Unknown secret - AI Helped us write this changelog
{: .fs-1 .fw-300 }
</div>
