ZeroGDesign/docs/docs/pages/menu/menu_changelog.md

---
layout: default
title: Changelog
nav_order: 60
has_children: true
has_toc: true
permalink: /changelog
---

# Changelog
{: .no_toc }

The changelog can be found on this page. It contains a list of updates and changes made to the documentation and projects.

Please check the table of contents below for more information.

1. Table of content
{:toc}
