ZeroGDesign/docs/(threads)

Thread 19 (2023-12-19):

PA calibration tool doesn't change extruder to realtive

Habag111, 2023-12-19:
The gcode that the PA calibration tool generates doesn't include a M83 command to set the extruder to relative mode. I'm including the .Gcode file I generated and a screenshot of my settings in a .zip because github doesn't allow me to upload .gcode files. Also, a dedicated field to set the temperature in would be appreciated.
[PA_zerog_gcode.zip](https://github.com/ZeroGDesign/docs/files/13710972/PA_zerog_gcode.zip)
