ZeroGDesign/docs/docs/database/bom.yml

bolt:
  - partname: m3x6
    image: urltoimage
    identifier: m3x6_7991
    type:
      din: '7991'
      iso: '10642'
      description: FHCS
    source:
      - region: CN
        name: AliExpress - Nindejin
        url: 'https://s.click.aliexpress.com/e/_AEXIMh'
        verified: true
      - region: US
        name: Boltdepot
        url: 'https://www.boltdepot.com/Product-Details.aspx?product=7212'
        verified: true
      - region: CA
        name: Boltsplus
        url: 'https://boltsplus.ca/productInfo.php?prodID=4103-0001'
        verified: true
  - partname: m3x8
    image: urltoimage
    identifier: m3x8_912
    type:
      din: '912'
      iso: '4762 '
      description: SHCS
    source:
      - region: CN
        name: AliExpress - Nindejin
        url: 'https://s.click.aliexpress.com/e/_9yeIIO'
        verified: true
      - region: US
        name: Boltdepot
        url: 'https://www.boltdepot.com/Product-Details.aspx?product=6379'
        verified: true
      - region: CA
        name: Boltsplus
        url: 'https://boltsplus.ca/productInfo.php?prodID=4101-0037'
        verified: true
  - partname: m3x10
    image: urltoimage
    identifier: m3x10_912
    type:
      din: '912'
      iso: '4762 '
      description: SHCS
    source:
      - region: CN
        name: AliExpress - Nindejin
        url: 'https://s.click.aliexpress.com/e/_9yeIIO'
        verified: true
      - region: US
        name: Boltdepot
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
        verified: true
      - region: CA
        name: Boltsplus
        url: 'https://boltsplus.ca/productInfo.php?prodID=4104-0049'
        verified: true
  - partname: m5x8
    image: urltoimage
    identifier: m5x8_912_SHCS
    type:
      din: '912'
      iso: '4762 '
      description: SHCS
    source:
      - region: CN
        name: AliExpress - Nindejin
        url: 'https://s.click.aliexpress.com/e/_9yeIIO'
        verified: true
      - region: US
        name: Boltdepot
        url: 'https://www.boltdepot.com/Product-Details.aspx?product=6406'
        verified: true
  - partname: m5x10
    image: urltoimage
    identifier: m5x10_912
    type:
      din: '912'
      iso: '4762 '
      description: SHCS
    source:
      - region: CN
        name: AliExpress - Nindejin
        url: 'https://s.click.aliexpress.com/e/_9yeIIO'
        verified: true
      - region: US
        name: Boltdepot
        url: 'https://www.boltdepot.com/Product-Details.aspx?product=6407'
        verified: true
      - region: CA
        name: Boltsplus
        url: 'https://boltsplus.ca/productInfo.php?prodID=4101-0127'
        verified: true
  - partname: m5x12
    image: urltoimage
    identifier: m5x12_912
    type:
      din: '912'
      iso: '4762 '
      description: SHCS
    source:
      - region: CN
        name: AliExpress - Nindejin
        url: 'https://s.click.aliexpress.com/e/_9yeIIO'
        verified: true
      - region: US
        name: Boltdepot
        url: 'https://www.boltdepot.com/Product-Details.aspx?product=6408'
        verified: true
  - partname: m5x20
    image: urltoimage
    identifier: m5x20_912
    type:
      din: '912'
      iso: '4762 '
      description: SHCS
    source:
      - region: CN
        name: AliExpress - Nindejin
        url: 'https://s.click.aliexpress.com/e/_9yeIIO'
        verified: true
      - region: US
        name: Boltdepot
        url: 'https://www.boltdepot.com/Product-Details.aspx?product=6410'
        verified: true
  - partname: m5x50
    image: urltoimage
    identifier: m5x50_912
    type:
      din: '912'
      iso: '4762 '
      description: SHCS
    source:
      - region: CN
        name: AliExpress - Nindejin
        url: 'https://s.click.aliexpress.com/e/_9yeIIO'
        verified: true
      - region: US
        name: Boltdepot
        url: 'https://www.boltdepot.com/Product-Details.aspx?product=6453'
        verified: true
nuts:
  - partname: M3 T-nut
    image: urltoimage
    identifier: m3_rollin_tnut
    type:
      description: M3 Roll in T-Nuts
    source:
      - region: CN
        name: Aliexpress - Link CNC
        url: 'https://s.click.aliexpress.com/e/_9JpX52'
        verified: true
      - region: GB
        name: Printyplease
        url: 'https://www.printyplease.uk/M3TNUT'
        verified: false
      - region: US
        name: Deepfriedhero
        url: >-
          https://deepfriedhero.in/products/roll-in-spring-nuts?variant=39612700393641
        verified: false
      - region: US
        name: KB-3D
        url: >-
          https://kb-3d.com/store/extrusion-framing/251-t-nut-drop-inroll-in-20-series-6mm-slot-width-m3-threads-1657989324345.html
        verified: false
      - region: CA
        name: Sparta3D
        url: >-
          https://sparta3d.ca/products/3d-sidekick-roll-in-t-nuts-tnuts-tnuts-t-nuts?_pos=3&_sid=916827c77&_ss=r
        verified: false
      - region: CA
        name: Spool3D
        url: 'https://spool3d.ca/m3-roll-in-spring-t-nut-2020'
        verified: false
  - partname: M5 T-nut
    image: urltoimage
    identifier: m5_rollin_tnut
    type:
      description: M5 Roll in T-Nuts
    source:
      - region: CN
        name: Aliexpress - Link CNC
        url: 'https://s.click.aliexpress.com/e/_9JpX52'
        verified: true
      - region: US
        name: KB-3D
        url: >-
          https://kb-3d.com/store/extrusion-framing/252-t-nut-drop-inroll-in-20-series-6mm-slot-width-m5-threads-1657989339400.html
        verified: false
      - region: CA
        name: Sparta3D
        url: >-
          https://sparta3d.ca/products/3d-sidekick-roll-in-t-nuts-tnuts-tnuts-t-nuts?variant=42096937337088
        verified: false
      - region: CA
        name: Spool3D
        url: 'https://spool3d.ca/m5-roll-in-spring-t-nut-2020'
        verified: false
  - partname: M3 hexnut
    image: urltoimage
    identifier: m3_hex_nut
    type:
      description: M3 Hex Nut
    source:
      - region: CN
        name: Aliexpress - Nindejin
        url: 'https://s.click.aliexpress.com/e/_A1EFzK'
        verified: true
      - region: US
        name: Boltdepot
        url: 'https://www.boltdepot.com/Product-Details.aspx?product=4773'
        verified: false
extrusions:
  - partname: '2020'
    image: urltoimage
    identifier: extrusion_2020
    type:
      description: Extrusion
    source:
      - region: NL
        name: Aluxprofiel
        url: >-
          https://www.aluxprofiel.nl/aluminium-constructieprofiel-2020-zwart/a3957?c=3470
        verified: true
      - region: US
        name: Misumi
        url: 'https://us.misumi-ec.com/vona2/detail/110302683830/?Inch=0'
        verified: true
lightweight_extrusion:
  - partname: '2020'
    image: urltoimage
    identifier: merc_light
    type:
      description: Lightweight Extrusion
      note: >-
        Compatible with (5/pro) - 370mm, only works with the rail on
        top.<br/>You need a <b>330mm MGN12H rail!</b>
    source:
      - region: CN
        name: AliExpress - FYSETC Official Store
        url: 'https://s.click.aliexpress.com/e/_DlBXW33'
        verified: true
rails:
  - partname: MGN9C 100mm
    image: urltoimage
    identifier: MGN9C_100mm
    type:
      description: Linear Rail
    source:
      - region: CN
        name: AliExpress - YOUMETONG Factory Store
        url: 'https://aliexpress.com/item/1005001431325586.html'
        verified: true
      - region: US
        name: Fabreeko
        url: >-
          https://www.fabreeko.com/products/honeybadger-mgn9c-stainless-steel-rails?_pos=1&_sid=dce3b231d&_ss=r
        verified: true
  - partname: MGN12C/H 400mm
    image: urltoimage
    identifier: MGN12_400mm
    type:
      description: Linear Rail
    source:
      - region: CN
        name: AliExpress - Usongshine
        url: 'https://s.click.aliexpress.com/e/_AaYWjs'
        verified: true
      - region: US
        name: Fabreeko
        url: >-
          https://www.fabreeko.com/products/honeybadger-mgn12c-stainless-steel-rails?variant=42106265895167
        verified: true
      - region: US
        name: West3D
        url: 'https://collabs.shop/csr2m8'
        verified: true
      - region: CA
        name: Sparta3D
        url: >-
          https://sparta3d.ca/products/ldo-mgn12h-linear-rail-carriage?variant=37783504519322
        verified: false
  - partname: MGN12C/H 500mm
    image: urltoimage
    identifier: MGN12_500mm
    type:
      description: Linear Rail
    source:
      - region: CN
        name: AliExpress - Usongshine
        url: 'https://s.click.aliexpress.com/e/_AaYWjs'
        verified: true
      - region: US
        name: Fabreeko
        url: >-
          https://www.fabreeko.com/products/honeybadger-mgn12c-stainless-steel-rails?variant=42106265895167
        verified: true
  - partname: MGN12H
    image: urltoimage
    identifier: MGN12mm
    type:
      description: Linear Rail
      note: Ender 5/Pro 330mm (300mm works)<br/>Ender 5 Plus 450mm
    source:
      - region: CN
        name: AliExpress - Usongshine
        url: 'https://s.click.aliexpress.com/e/_AaYWjs'
        verified: true
      - region: US
        name: Fabreeko
        url: >-
          https://www.fabreeko.com/products/honeybadger-mgn12c-stainless-steel-rails?variant=42106265895167
        verified: true
Leadscrew:
  - partname: TR8
    image: urltoimage
    identifier: TR8_Leadscrew
    type:
      description: Lead Screw
      note: You want 2mm lead<br/>8mm lead is untested
    source:
      - region: CN
        name: AliExpress - FYSETC Official Store
        url: 'https://s.click.aliexpress.com/e/_Ddfzih5'
        verified: true
      - region: CN
        name: AliExpress - FYSETC 1th Store
        url: 'https://s.click.aliexpress.com/e/_A1f2Gb'
        verified: true
      - region: US
        name: Fabreeko
        url: >-
          https://www.fabreeko.com/products/tr8x2mm-lead-screws-for-ender-5-pro-and-ender-5-plus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
        verified: true
Manget:
  - partname: Countersunk Ring Magnet
    image: urltoimage
    identifier: 12x5_cs_magnet
    type:
      description: 12x5x4
    source:
      - region: CN
        name: AliExpress - YCHEN Store
        url: 'https://s.click.aliexpress.com/e/_ABC6Cb'
        verified: false
      - region: EU
        name: Kris3D
        url: >-
          https://www.kris3d.de/products/3x-neodymium-magnet-12x5x4?_pos=1&_sid=e0cc59c65&_ss=r&variant=41498934477006
        verified: true
      - region: NL
        name: Supermagnete
        url: >-
          https://www.supermagnete.nl/magneten-om-te-schroeven/schijfmagneet-12mm-hoogte-4mm_CS-S-12-04-N
        verified: false
      - region: DE
        name: Supermagnete
        url: >-
          https://www.supermagnete.de/magnete-zum-anschrauben/scheibenmagnet-12mm-hoehe-4mm_CS-S-12-04-N
        verified: false
SSR:
  - partname: Solid State Relay
    image: urltoimage
    identifier: ssr
    type:
      description: ''
    source:
      - region: US
        name: West3D
        url: 'https://collabs.shop/exefto'
        verified: true
      - region: NL
        name: DigiKey
        url: >-
          https://www.digikey.nl/en/products/detail/omron-automation-and-safety/G3NA-210B-UTU-DC5-24/634443?
        verified: true
hydra_bed:
  - partname: Bed heater
    image: urltoimage
    identifier: bed_heater
    type:
      description: For Hydra
    source:
      - region: US
        name: Fabreeko<br/>(275/377mm heater)
        url: >-
          https://www.fabreeko.com/collections/zero-g/products/fabreeko-edge-to-edge-heaters-for-zero-g
        verified: true
      - region: CN
        name: 'Fysetc<br/>(Heater, 255x255x8mm bed, surface, magnet)'
        url: 'https://s.click.aliexpress.com/e/_DnKgYY3'
        verified: true
      - region: CN
        name: 'Fysetc<br/>(Heater, 377x370x8mm bed, surface, magnet)'
        url: 'https://s.click.aliexpress.com/e/_Deflc7X'
        verified: true
  - partname: Hydra Aluminum bed
    image: urltoimage
    identifier: hydra_bed
    type:
      description: ''
    source:
      - region: US
        name: Fabreeko<br/>(275x275x8mm/ 377x370x8mm bed)
        url: >-
          https://www.fabreeko.com/products/zero-g-atp5-aluminum-beds-for-ender-5-pro-plus-hydra-conversion
        verified: true
      - region: EU
        name: Kris3D<br/>(254x254x8mm/ 377x370x8mm bed)
        url: 'https://www.kris3d.de/products/zerog-hydra'
        verified: true
      - region: CN
        name: 'Fysetc<br/>(Heater, 255x255x8mm bed, surface, magnet)'
        url: 'https://s.click.aliexpress.com/e/_DnKgYY3'
        verified: true
      - region: CN
        name: 'Fysetc<br/>(Heater, 377x370x8mm bed, surface, magnet)'
        url: 'https://s.click.aliexpress.com/e/_Deflc7X'
        verified: true
other:
  - partname: corner_bracket
    image: urltoimage
    identifier: 2020_corner_bracket
    type:
      description: '2020'
    source:
      - region: CN
        name: AliExpress - HPCLE Store
        url: 'https://aliexpress.com/item/4000190579760.html'
        verified: false
      - region: NL
        name: Aluxprofiel
        url: 'https://www.aluxprofiel.nl/verbindingshoek-2020/a3982?c=3484'
        verified: true
  - partname: Heatset insert
    image: urltoimage
    identifier: heatset_insert
    type:
      description: M3 X D5.0 X L4.0
    source:
      - region: CN
        name: AliExpress - HotXYZ Official Store
        url: 'https://s.click.aliexpress.com/e/_A8Gh7z'
        verified: true
      - region: GB
        name: Printyplease
        url: 'https://www.printyplease.uk/M3Heatsets'
        verified: true
      - region: US
        name: Fabreeko
        url: >-
          https://www.fabreeko.com/products/threaded-heat-inserts-m3x5x4-100pc-per-bag
        verified: true
      - region: US
        name: West3D
        url: 'https://collabs.shop/jgns0m'
        verified: true
      - region: eu
        name: kris3D
        url: 'https://www.kris3d.de/products/heatinserts-m3x5x4'
        verified: true
  - partname: M3 Washer
    image: urltoimage
    identifier: plain_m3_washer
    type:
      description: M3 Stainless Steel
    source:
      - region: CN
        name: AliExpress - Nindejin
        url: 'https://s.click.aliexpress.com/e/_A9rXO4'
        verified: false
      - region: CA
        name: Boltsplus
        url: 'https://boltsplus.ca/productInfo.php?prodID=5301-0001'
        verified: true
      - region: US
        name: Boltsplus
        url: 'https://www.boltdepot.com/Product-Details.aspx?product=4513'
        verified: true
  - partname: M5 Washer/Shim
    image: urltoimage
    identifier: plain_m5_washer
    type:
      description: M5 Stainless Steel
    source:
      - region: CN
        name: AliExpress - Nindejin
        url: 'https://s.click.aliexpress.com/e/_A9rXO4'
        verified: false
      - region: US
        name: Boltsplus
        url: 'https://www.boltdepot.com/Product-Details.aspx?product=4515'
        verified: true
  - partname: Spacer
    image: urltoimage
    identifier: 8mm_spacers
    type:
      description: M4 X 8 X L8
      note: Included in stock v-rollers
    source:
      - region: CN
        name: AliExpress - Nindejin
        url: 'https://s.click.aliexpress.com/e/_974ext'
        verified: false
  - partname: Kossel ball
    image: urltoimage
    identifier: m4_kossel_balls
    type:
      description: 10mm M4
    source:
      - region: CN
        name: AliExpress - Kee Pang
        url: 'https://s.click.aliexpress.com/e/_9IX7uJ'
        verified: false
      - region: CN
        name: AliExpress - Mellow Store
        url: 'https://s.click.aliexpress.com/e/_AmmWtd'
        verified: true
      - region: US
        name: Robotdigg
        url: 'https://www.robotdigg.com/product/747/Steel-ball-with-M4-screw-hole'
        verified: true
  - partname: Precision dowel pin
    image: urltoimage
    identifier: m5_30_Precision_dowel_pin
    type:
      description: 5x30mm
    source:
      - region: CN
        name: AliExpress - Nindejin
        url: 'https://s.click.aliexpress.com/e/_ATn62e'
        verified: true
      - region: US
        name: West3D
        url: 'https://collabs.shop/gux2gc'
        verified: false
  - partname: Drag chain
    image: urltoimage
    identifier: 10x11_drag_chain
    type:
      description: R18 10x11_drag_chain
    source:
      - region: CN
        name: AliExpress - Veekaft FA Store
        url: 'https://s.click.aliexpress.com/e/_DB2Dier'
        verified: true
  - partname: F695-2RS
    image: urltoimage
    identifier: f695_2rs_flangebearing
    type:
      description: 5*13*4 Mm
    source:
      - region: CN
        name: AliExpress - raindew Official Store
        url: 'https://s.click.aliexpress.com/e/_AS0Kjs'
        verified: true
      - region: US
        name: West3D
        url: 'https://collabs.shop/yfhmui'
        verified: false
      - region: US
        name: Fabreeko
        url: >-
          https://www.fabreeko.com/products/honeybadger-bearings-for-voron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
        verified: true
  - partname: 2GT toothed idler
    image: urltoimage
    identifier: 2gt_teeth_idler
    type:
      description: With teeth
    source:
      - region: CN
        name: AliExpress - POWGE Official Store
        url: 'https://s.click.aliexpress.com/e/_A83Ezk'
        verified: true
      - region: CN
        name: AliExpress - Mellow 3D Official Store
        url: 'https://s.click.aliexpress.com/e/_AKa3Ea'
        verified: true
  - partname: 2GT toothed pulley
    image: urltoimage
    identifier: 2gt_teeth_pulley
    type:
      description: With teeth
    source:
      - region: CN
        name: AliExpress - POWGE Official Store
        url: 'https://s.click.aliexpress.com/e/_A0lAqA'
        verified: true
      - region: CN
        name: AliExpress - Mellow 3D Official Store
        url: 'https://s.click.aliexpress.com/e/_Ad3wTo'
        verified: true
  - partname: GATES-LL-2GT
    image: urltoimage
    identifier: gates_belts_6mm
    type:
      description: 6MM-2GT
      note: Ender 5(PRO) 5 Meter<br/>Ender 5 Plus 6 meter.
    source:
      - region: CN
        name: AliExpress - POWGE Official Store
        url: 'https://s.click.aliexpress.com/e/_9GvtNo'
        verified: true
      - region: CN
        name: AliExpress - Mellow 3D Official Store
        url: 'https://s.click.aliexpress.com/e/_AYPi4a'
        verified: true
      - region: CN
        name: AliExpress - DFORCE Trianglelab Store
        url: 'https://s.click.aliexpress.com/e/_AlTIwO'
        verified: true
  - partname: Nema17
    image: urltoimage
    identifier: nema17_zaxis
    type:
      description: Stepper motor
    source:
      - region: CN
        name: AliExpress - Stepperonline
        url: 'https://s.click.aliexpress.com/e/_AaM1bN'
        verified: false
      - region: US
        name: Amazon - Stepperonline
        url: 'https://www.amazon.com/gp/product/B07LCK19D5'
        verified: false
      - region: US
        name: Fabreeko (5 plus)
        url: >-
          https://www.fabreeko.com/collections/zero-g/products/ender-5-plus-integrated-lead-screw-motor-by-ldo
        verified: false
  - partname: Shaft Coupling
    image: urltoimage
    identifier: stepper_coupler
    type:
      description: Z-Axis
      note: Included with Y and Z assembly
    source:
      - region: CN
        name: Amazon - Stepperonline
        url: 'https://s.click.aliexpress.com/e/_ATsnwT'
        verified: false
  - partname: Oldham Coupling
    image: urltoimage
    identifier: oldham_coupler
    type:
      description: Z-Axis
      note: You will lose some Z travel
    source:
      - region: CN
        name: AliExpress - Mellow 3D Official Store
        url: 'https://s.click.aliexpress.com/e/_DE4NPCB'
        verified: true
hydra_kits:
  - partname: Kit
    image: urltoimage
    identifier: hydra_kits
    type:
      description: ZeroG Hydra
      note: Double check what you're getting!
    source:
      - region: US
        name: West3D
        url: 'https://collabs.shop/bhids5'
        verified: false
      - region: US
        name: Fabreeko
        url: >-
          https://www.fabreeko.com/collections/zero-g/products/zero-g-hydra-3-point-conversion-for-ender-5-pro-plus
        verified: false
      - region: CN
        name: 'Fysetc<br/>(Heater, 255x255x8mm bed, surface, magnet)'
        url: 'https://s.click.aliexpress.com/e/_DnKgYY3'
        verified: true
      - region: CN
        name: 'Fysetc<br/>(Heater, 377x370x8mm bed, surface, magnet)'
        url: 'https://s.click.aliexpress.com/e/_Deflc7X'
        verified: true
electronics:
  - partname: Stepper motor
    image: urltoimage
    identifier: nema17_stepper_motor
    type:
      description: Nema17
    source:
      - region: CN
        name: AliExpress - STEPPERONLINE Official Store
        url: 'https://s.click.aliexpress.com/e/_Aq98MK'
        verified: true
      - region: US
        name: Fabreeko
        url: >-
          https://www.fabreeko.com/products/ldo-42sth48-2504ah-high-temp?_pos=1&_sid=96cdb4e16&_ss=r
        verified: true
      - region: EU
        name: Ratrig
        url: >-
          https://www.ratrig.com/hardware2/electronics/nema-17-stepper-motor.html
        verified: true
  - partname: Motherboard
    image: urltoimage
    identifier: printer_motherboard
    type:
      description: Brains
    source:
      - region: CN
        name: Spider 2.3 - FYSETC Official Store
        url: 'https://s.click.aliexpress.com/e/_Dmdz8kb'
        verified: false
      - region: US
        name: Spider 2.3 - Fabreeko
        url: >-
          https://www.fabreeko.com/products/fystec-spider-voron-design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
        verified: false
      - region: CN
        name: Octopus 1.1 - DFORCE Trianglelab Store
        url: 'https://s.click.aliexpress.com/e/_DFmc7kn'
        verified: true
  - partname: Hotend
    image: urltoimage
    identifier: rapido_hotend
    type:
      description: HF
      note: We recommend HF not UHF!
    source:
      - region: CN
        name: AliExpress - DFORCE Trianglelab Store
        url: 'https://s.click.aliexpress.com/e/_DFiSp8X'
        verified: false
      - region: US
        name: Fabreeko
        url: >-
          https://www.fabreeko.com/products/phaetus-rapido-high-flow-hotend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
        verified: false
  - partname: Gdstime 40x40x10
    image: urltoimage
    identifier: Gdstime_4010
    type:
      description: Cooling Fan
    source:
      - region: CN
        name: 'AliExpress - Shenzhen Gdstime Technology Co., Ltd'
        url: 'https://s.click.aliexpress.com/e/_DlwY6dV'
        verified: false
      - region: US
        name: West3D
        url: 'https://collabs.shop/do8szs'
        verified: false
