ZeroGDesign/docs/(commit log)

2022-01-02 adding CAD standards
2022-04-16 Adding new Next step button
2022-04-16 Removed Skill required button + moving sanding pin
2022-04-16 Floating back to top button
2022-04-16 Floating back to top button + lightbox_wrapper changes
2022-04-19 Right stepper images
2022-04-19 Stl files for new stepper mounts
    [stepper_mount_top_left.stl, stepper_mount_top_right.stl]
2022-04-19 Adding stl download info
2022-04-19 Tension tower stls
    [front_tower_left.stl, front_tower_right.stl]
2022-04-19 Adding parts for tension towers
2022-04-19 Adding 1mm to t-nut engagement lowering m5 bolt
    [front_tower_left.stl, front_tower_right.stl]
2022-04-30 Adding icon to back to top button for all systems
2022-05-01 Adding front tension plates to print page
    [front_tension_plate_t-nut_x2.stl, front_tension_plate_tapped_x2.stl]
2022-05-01 Adding text amount printed front tension plates
2022-05-21 Hydra stl
2022-05-22 Missing files + removal of old hydra page
    [MGN9C_12x3Mag.stl, MGN9C_12x4Mag.stl]
2022-05-22 Changed url + text next step button
2022-05-22 Added version numbers to print files page for stls
2022-05-23 Added Bed section + Fabreeko + Printyplease to BOM
2022-05-26 Added more sources for heatsets & ssr
2022-05-29 Images for installing left & right arm
2022-05-29 Adding left + right arm instructions
2022-05-29 Typo fix in heatset amount
2022-05-29 Temp next step button added
2022-06-14 Rear arm instructions
2022-06-14 Rear arm typo fix
2022-06-14 Adding next step button top right arm
2022-06-14 Added calculator for stepper current
2022-06-15 Added klipper calculation page
2022-06-21 Renders added for hydra + electroncs enclosure
2022-07-12 Configurator setup
    [Belt_clamp_x2.stl, D2F-L_X_Limit_Stop_Block.stl, EVA_M1-1_FrontPlate_HD_v0-1.stl, EVA_M1-1_bottom_mgn12_short_duct.stl, EVA_M1-1_generic_chain_holder.stl, Extruder_X_Limit_Stop_Block.stl, Extruder_X_Limit_Top_BMG_MGN12.stl, Extruder_X_Limit_Top_LGX_Lite_MGN12.stl]
2022-07-12 Added rapido HF to configurator
    [face_rapido.stl]
2022-07-16 Optimizing BOM for global editing
2022-07-31 Images for new x joints
2022-07-31 Adding all the STLs for new X joints + config
    [Belt_clamp_1.stl, Belt_clamp_2.stl, Belt_clamp_x2.stl, EVA2-4_Bottom_V1-1.stl, EVA_Backplate_Merc_Support_V1-1.stl, EVA_FrontPlate_HD_V-1-1.stl, EVA_M1-1_FrontPlate_HD_v0-1.stl, EVA_M1-1_bottom_mgn12_short_duct.stl]
2022-07-31 Small fix to stepper mounts+
    [stepper_mount_top_left.stl, stepper_mount_top_right.stl]
2022-08-03 FIX: Tension plate download URL
2022-08-15 Fix link to the print settings page
    dry coded by replacing the link to the permalink in https://github.com/ZeroGDesign/docs/blob/gh-pages/docs/pages/standard/standard_print.md
2022-08-18 Added missing fan trihorn duct to configurator
2022-10-05 Online database for stores + more instructions
    [a_D2F-L_X_Limit_Stop_Block.stl, a_EVA_Backplate_Merc_Support_V1-1.stl, a_EVA_FrontPlate_HD_V-1-1.stl, a_Extruder_X_Limit_Stop_Block.stl, a_FlangeSpacer_short_1.stl, a_FlangeSpacer_short_2.stl, a_FlangeSpacer_tall_1.stl, a_FlangeSpacer_tall_2.stl]
2022-10-13 Adding oldham coupling to hydra (optinal)
2022-10-14 Adding loading bar for BOM databse
2022-10-22 Updated spacer design + rotated for slicer
    [a_FlangeSpacer_short_1.stl, a_FlangeSpacer_short_2.stl, a_FlangeSpacer_tall_1.stl, a_FlangeSpacer_tall_2.stl, a_MellowSpacer_short_1.stl, a_MellowSpacer_short_2.stl, a_MellowSpacer_tall_1.stl, a_MellowSpacer_tall_2.stl]
2022-10-22 Rotating for slicer, seam in the back.
    [XJoint_left_top.stl, XJoint_right_top.stl]
2022-10-22 New Y Endstop
    [y_endstop.stl]
2022-10-23 Work in progress - BOM M1.1
2022-10-23 Update rail size (typo)
2022-10-23 Updated part rotation for printing - Seam in back
    [a_stepper_mount_top_left.stl, a_stepper_mount_top_right.stl]
2022-10-23 Cleaning up M1.1 BOM
2022-10-24 FIX - Typo in dowel pin amount
2022-11-27 Update X joints to 1.1.4!
    [XJoint_left_bottom.stl, XJoint_right_bottom.stl, XJoint_right_top.stl]
2022-11-28 Fix model, forgot to replace
    [XJoint_left_top.stl]
2022-11-28 Update m3 holes
    [XJoint_left_bottom.stl, XJoint_left_top.stl, XJoint_right_bottom.stl, XJoint_right_top.stl]
2022-12-02 Temp fix BOM
2022-12-05 Button url fix
2022-12-07 Adding info for right stepper tower
2022-12-12 Higher resolution stepper towers
    [a_stepper_mount_top_left.stl, a_stepper_mount_top_right.stl]
2022-12-12 Update Drag chain url
2022-12-15 Adding CR Touch mount - Thanks to CatalinaFlyer
    [cr_touch_mount.stl]
2022-12-20 Emergency Fix
    [a_stepper_mount_top_left.stl, a_stepper_mount_top_right.stl]
2022-12-20 Final Fix
    [a_stepper_mount_top_right.stl]
2022-12-26 QoL Changes to stls + renames
    [BMG_TOP.stl, Extruder_X_Limit_Top_BMG_MGN12.stl, Extruder_X_Limit_Top_LGX_MGN12__b.stl, Extruder_X_Limit_Top_LGX_MGN12_a.stl, Extruder_X_Limit_Top_MGN12.stl, Extruder_X_Limit_Top_Orbiter_1_5_MGN12.stl, Extruder_X_Limit_Top_Orbiter_2_0_MGN12.stl, Extruder_X_Limit_Top_Sherpa_Mini_MGN12.stl]
2022-12-26 Added new bolts to the BoM Database
2022-12-26 Changed BoM to fit our new EVA files
2022-12-26 Renamed STL Files
2022-12-26 Reordered structure of the menu + renamed printers
2023-01-15 Combined files into one - the printed spacers
    [RearSplitloomArm_V1-1-0.stl, a_FlangeSpacer_short_1.stl, a_FlangeSpacer_short_2.stl, a_FlangeSpacer_short_pair.stl, a_FlangeSpacer_tall_1.stl, a_FlangeSpacer_tall_2.stl, a_MellowSpacer_short_1.stl, a_MellowSpacer_short_2.stl]
2023-01-15 Added a callibration print section
2023-02-25 Removed store + changed 100mm mgn9c url
2023-03-04 Uploaded hydra files for configurator
    [2020_CableTie.stl, ChainEnd.stl, a_MGN9C_12x3Mag.stl, a_MGN9C_12x4Mag.stl, a_MGN9C_12x5Mag.stl]
2023-03-04 BOM update HYDRA
2023-03-04 Fixed duplicate item on BOM
2023-03-19 Added display message after clicking get files button
2023-03-19 Added message after clicking get files button + fix typo
2023-03-19 Cleaned up the printed files page
2023-03-26 Fixed links to correct T-nuts from KB3D in BOM
2023-03-29 Adding the Electronics Enclosure configurator
    [2020_Cable_Tie_x3.stl, 5Plus_Hydra_TopPanel.dxf, 5Pro_BottomPanel.dxf, 5Pro_Hydra_TopPanel.dxf, Clip_Base_x4.stl, Clip_Top_x4.stl, DIN-5PL-Mosfet-M3_heatset.stl, DIN-Generic-M2_5_threaded_1.stl]
2023-04-08 Uploading the Mercury One.1.5 files
    [XJoint_left_top.stl, XJoint_right_top.stl, a_FlangeSpacer_short_pair.stl, a_front_tower_left.stl, a_front_tower_right.stl, a_stepper_mount_top_left.stl, a_stepper_mount_top_right.stl, front_tower_tool.stl]
2023-04-08 Fix url to left stepper tower instrucitons
2023-04-08 Updating BOM, adding 10 shims
2023-04-08 Adding another tool for brass shims
    [front_tower_tool_brass.stl]
2023-04-08 Upload step 7, right stepper tower
2023-04-16 Update file ,missed lgx mount update
    [LGX_Lite_TOP.stl]
2023-05-05 New files for spacers x joints
    [a_FlangeSpacer_pair.stl, a_MellowSpacer_short_pair.stl, a_Xjoint_10mm_Idler_Spacers.stl, a_Xjoint_8mm_Idler_Spacers.stl, a_Xjoint_9mm_Idler_Spacers.stl, a_tIdlerSpacer_short_pair.stl]
2023-05-14 Adding missing m4x20 bolts for ender 5 plus
2023-05-15 Updating some bom info for hydra
2023-05-30 QOL update - Logo is now deeper, easier to print.
    [a_front_tower_left.stl, a_front_tower_right.stl]
2023-05-31 Increas angle, 45 degree to 60 for easier print
    [a_front_tower_left.stl, a_front_tower_right.stl]
2023-05-31 Change rotation
    [x_endstop_block.stl]
2023-06-02 Fix close button, small error in code.
2023-06-03 Update bom.json
    Update url
2023-06-08 FIxed Y endstop default location
    [plus_only_bed_raiser_1.stl, plus_only_bed_raiser_2.stl, plus_only_bed_raiser_3.stl, plus_only_bed_raiser_4.stl, y_endstop.stl]
2023-08-13 Adding long forgotten default mosfet mount
2023-08-15 Update bom urls
2023-08-15 Adding missing info to print standards page
2023-08-15 Reduced ZeroG logo to 0.25 depth for printability
    [a_front_tower_left.stl, a_front_tower_right.stl]
2023-08-15 Remade stepper mounts fully, same looks but better
    [a_stepper_mount_top_left.stl, a_stepper_mount_top_right.stl]
2023-08-15 Moved m5 hole 1.8mm down, they line up with tnuts
    [front_tension_plate_t-nut_1.stl, front_tension_plate_t-nut_2.stl]
2023-08-15 Small fix
    [a_stepper_mount_top_right.stl]
2023-08-18 Quick fix on the hole size for the stepper towers
    [a_stepper_mount_top_left.stl, a_stepper_mount_top_right.stl]
2023-08-20 Adding orcaslicer flow callibration tool
2023-09-01 Removal of experimental belt tension tool
2023-09-21 Removal of JSON BOM database, converting to YAML
2023-10-23 CoreXy homing solver alpha _hidden
2023-11-21 Sneaky text update on right bottom stepper tower
    [a_stepper_mount_bottom_right.stl]
2023-11-21 moving klipper tools to universal page/ warning text
2024-02-15 Adding rail alignment tool + rotation correction on trihorn
    [EVA2_4_Trihorn_high-narrow.stl, rail_alignment_tool.stl]
2024-02-18 Removing list number from BOM
2024-02-18 Fixed rotation
    [Orbiter_2_0_TOP.stl]
2024-02-18 More lightweight extrusion stuff
    [x_endstop_block_PLUS.stl]
2024-02-18 1_1_6 x joint part update
    [XJoint_left_top.stl, XJoint_right_top.stl, a_FlangeSpacer_pair.stl]
2024-02-18 Change 300mm rail to 330
2024-02-20 Intergrating fan ducts with bottom plate, better stability
    [EVA2-4_Bottom_V1-1.stl, EVA2_4_Trihorn_high-narrow.stl, EVA2_4_Trihorn_high-wide.stl, EVA2_4_Trihorn_safe-wide.stl]
2024-02-21 Renaming to height off build plate
    [EVA2_4_Trihorn_3-4-wide.stl, EVA2_4_Trihorn_4-3-wide.stl]
2024-02-21 Additional info file to optional fan ducts
2024-02-21 1.04 Electronics skirt feet + bottom panel qol changes
    [5Pro_BottomPanel.dxf, SK_5Plus_BottomPanel.dxf]
2024-02-21 Removal of stock ender feet for skirt corner pieces
    [SK_FT_Stock_PowerSW.stl, SK_FT_Stock_x3.stl]
